KotoriProject/CherryDAP/projects/HSLink-Pro/hardware/README.md

# HSLinkPro

## 本仓库不再更新！！

新的参考设计: <https://github.com/cherry-embedded/CherryDAP/tree/master/projects/HSLink-Pro/hardware>

HSLink Pro是一款基于HPM5301系列MCU的调试器。最高SWD/JTAG通信速率可达80M，并且拥有一路USB转串口，并带有DTR与RTS的输出，方便某些串口下载的MCU应用。

HSLink Pro软件参考<https://github.com/cherry-embedded/CherryDAP>。

## KiCAD 版本

使用8.0以上版本的KiCAD打开。
