KotoriProject/CherryDAP/docs/src/projects/README.md

---
title: 示例工程
---

以下是 CherryDAP 提供的一系列 MCU 的示例工程，可作为参考。

<Catalog />
