KotoriProject/CherryDAP/docs/src/projects/image/53uart.png

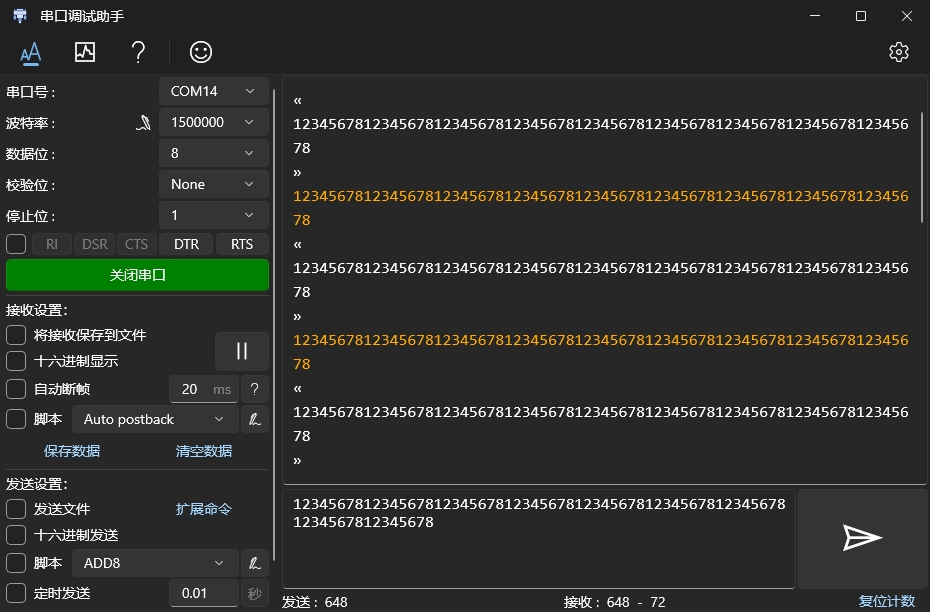
docs/src/projects/image/53uart.png
