KotoriProject/CherryDAP/docs/src/projects/image/2024-09-16-17-08-40.png

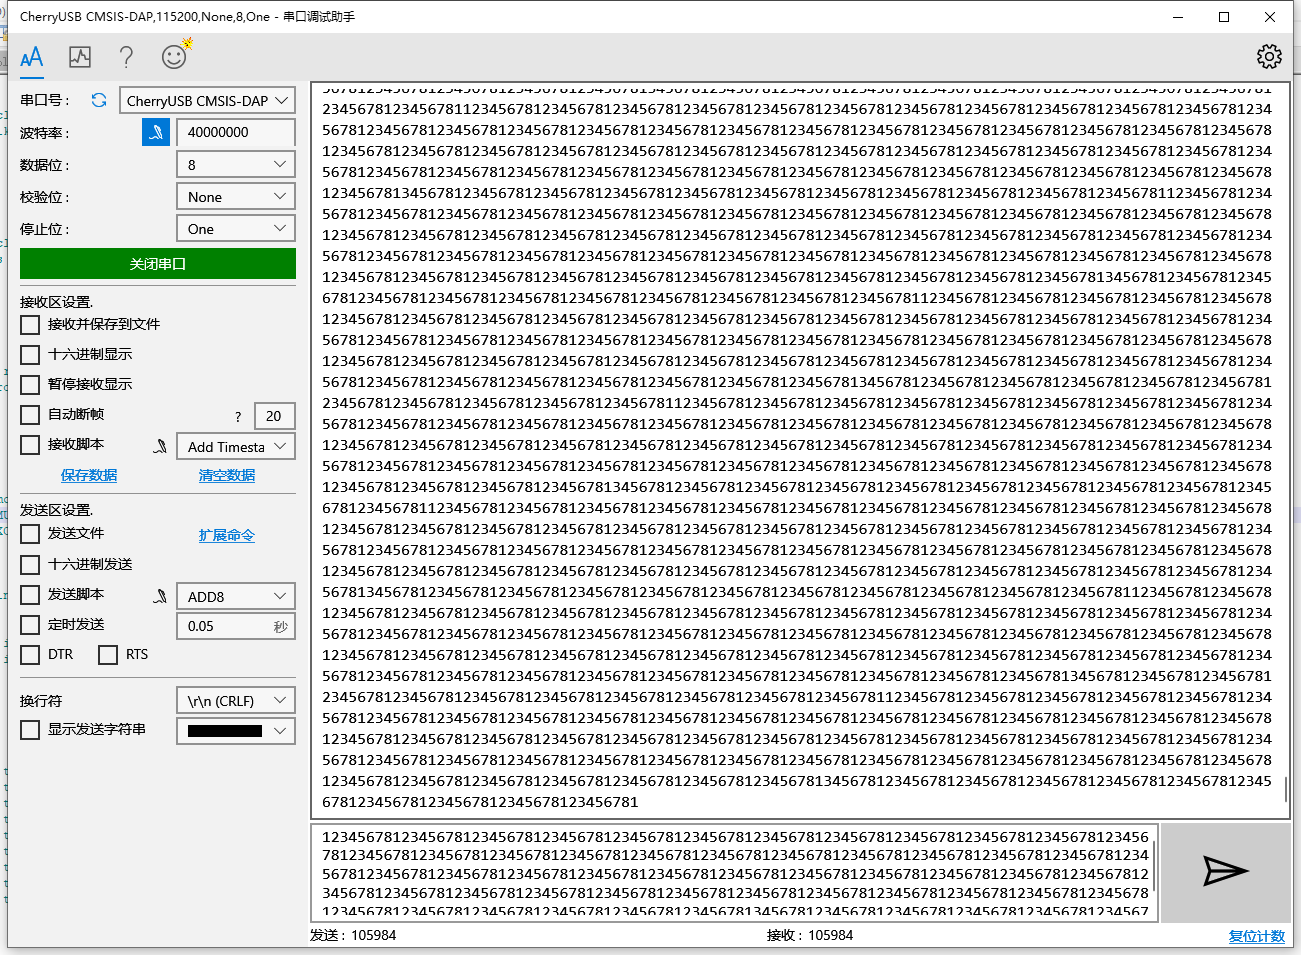
docs/src/projects/image/2024-09-16-17-08-40.png
