KotoriProject/CherryDAP/docs/src/projects/image/2024-09-16-17-09-58.png

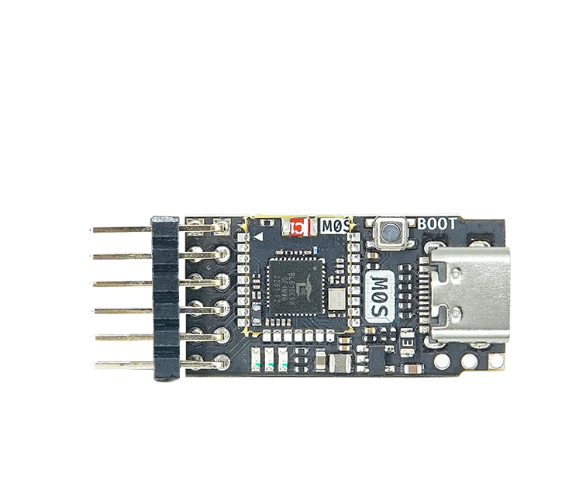
docs/src/projects/image/2024-09-16-17-09-58.png
