KotoriProject/CherryDAP/docs/src/projects/image/2024-09-16-17-15-38.png

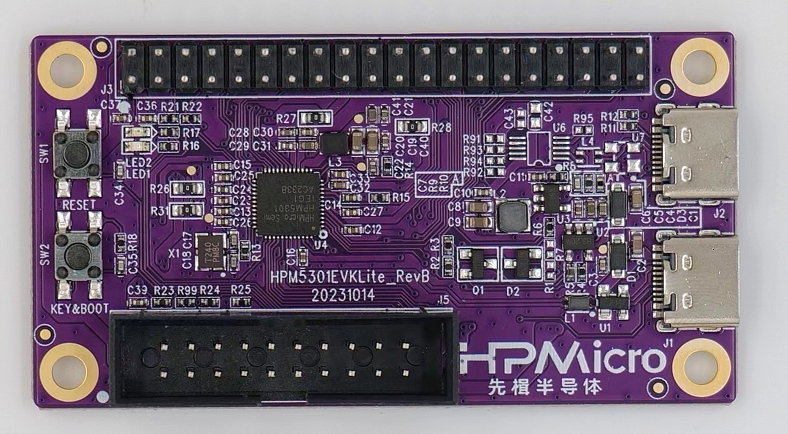
docs/src/projects/image/2024-09-16-17-15-38.png
