KotoriProject/CherryDAP/docs/src/projects/image/hpm_acc_tools.png

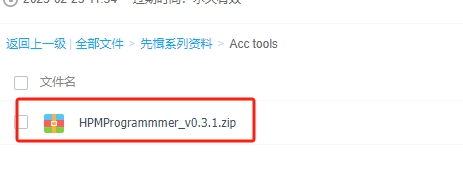
docs/src/projects/image/hpm_acc_tools.png
