KotoriProject/CherryDAP/docs/src/projects/image/hpm_download.png

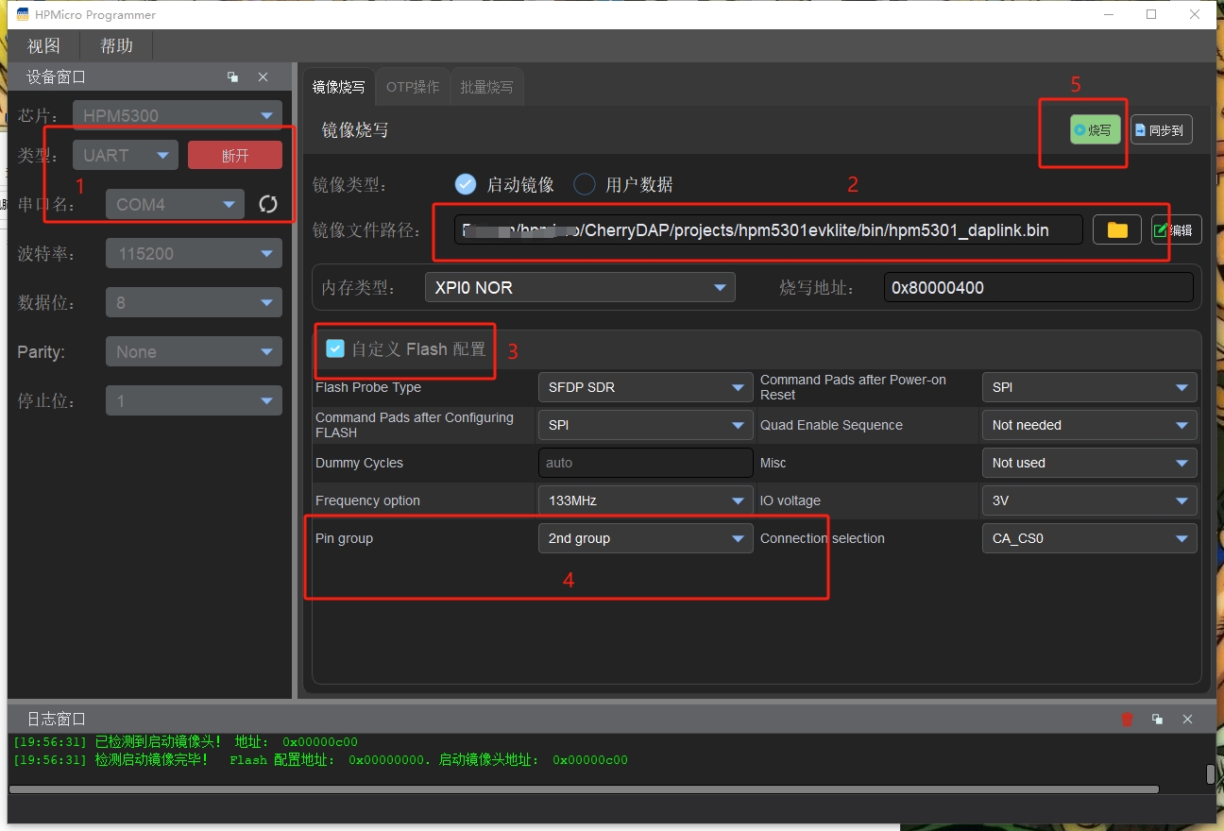
docs/src/projects/image/hpm_download.png
