KotoriProject/CherryDAP/docs/src/projects/image/hpm_isp_uart.png

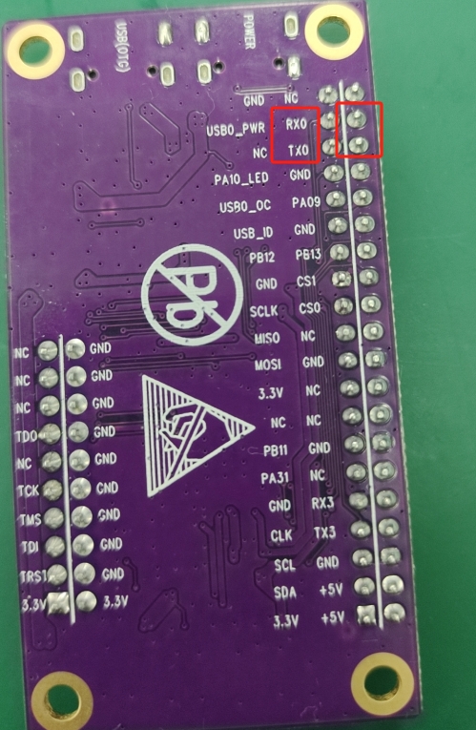
docs/src/projects/image/hpm_isp_uart.png
