KotoriProject/CherryDAP/docs/src/projects/image/sdk_env.png

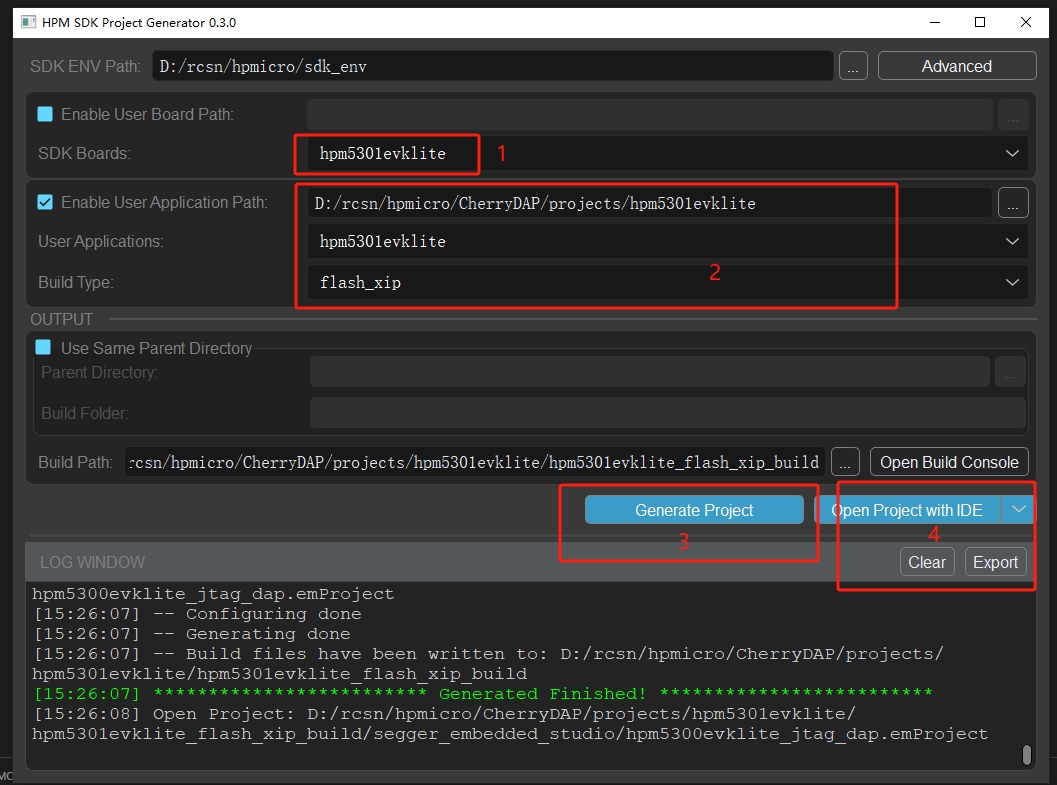
docs/src/projects/image/sdk_env.png
