KotoriProject/CherryDAP/docs/src/projects/image/ses_debug_hpm.png

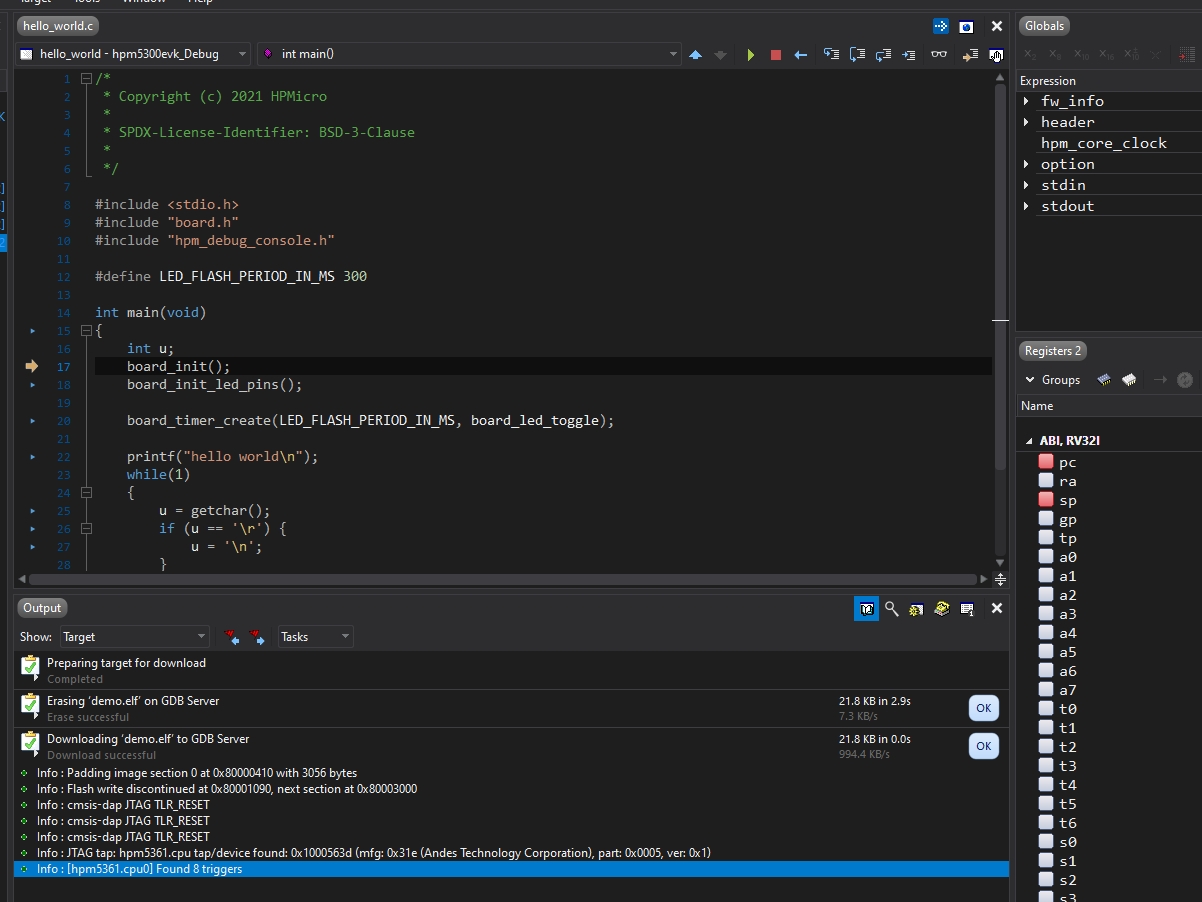
docs/src/projects/image/ses_debug_hpm.png
