KotoriProject/CherryDAP/docs/pnpm-lock.yaml

lockfileVersion: '6.0'

settings:
  autoInstallPeers: true
  excludeLinksFromLockfile: false

dependencies:
  '@vuepress/plugin-markdown-image':
    specifier: 2.0.0-rc.47
    version: 2.0.0-rc.47(markdown-it@14.1.0)(vuepress@2.0.0-rc.15)
  '@vuepress/plugin-markdown-tab':
    specifier: 2.0.0-rc.47
    version: 2.0.0-rc.47(markdown-it@14.1.0)(vuepress@2.0.0-rc.15)
  '@vuepress/plugin-redirect':
    specifier: 2.0.0-rc.51
    version: 2.0.0-rc.51(vuepress@2.0.0-rc.15)
  sass-embedded:
    specifier: ^1.79.3
    version: 1.79.3

devDependencies:
  '@vuepress/bundler-vite':
    specifier: 2.0.0-rc.15
    version: 2.0.0-rc.15(sass-embedded@1.79.3)
  vue:
    specifier: ^3.5.8
    version: 3.5.8
  vuepress:
    specifier: 2.0.0-rc.15
    version: 2.0.0-rc.15(@vuepress/bundler-vite@2.0.0-rc.15)(vue@3.5.8)
  vuepress-theme-hope:
    specifier: 2.0.0-rc.56
    version: 2.0.0-rc.56(@vuepress/plugin-redirect@2.0.0-rc.51)(markdown-it@14.1.0)(sass-embedded@1.79.3)(vuepress@2.0.0-rc.15)

packages:

  /@babel/helper-string-parser@7.24.8:
    resolution: {integrity: sha512-pO9KhhRcuUyGnJWwyEgnRJTSIZHiT+vMD0kPeD+so0l7mxkMT19g3pjY9GTnHySck/hDzq+dtW/4VgnMkippsQ==}
    engines: {node: '>=6.9.0'}

  /@babel/helper-validator-identifier@7.24.7:
    resolution: {integrity: sha512-rR+PBcQ1SMQDDyF6X0wxtG8QyLCgUB0eRAGguqRLfkCA87l7yAP7ehq8SNj96OOGTO8OBV70KhuFYcIkHXOg0w==}
    engines: {node: '>=6.9.0'}

  /@babel/parser@7.25.6:
    resolution: {integrity: sha512-trGdfBdbD0l1ZPmcJ83eNxB9rbEax4ALFTF7fN386TMYbeCQbyme5cOEXQhbGXKebwGaB/J52w1mrklMcbgy6Q==}
    engines: {node: '>=6.0.0'}
    hasBin: true
    dependencies:
      '@babel/types': 7.25.6

  /@babel/types@7.25.6:
    resolution: {integrity: sha512-/l42B1qxpG6RdfYf343Uw1vmDjeNhneUXtzhojE7pDgfpEypmRhI6j1kr17XCVv4Cgl9HdAiQY2x0GwKm7rWCw==}
    engines: {node: '>=6.9.0'}
    dependencies:
      '@babel/helper-string-parser': 7.24.8
      '@babel/helper-validator-identifier': 7.24.7
      to-fast-properties: 2.0.0

  /@bufbuild/protobuf@2.1.0:
    resolution: {integrity: sha512-+2Mx67Y3skJ4NCD/qNSdBJNWtu6x6Qr53jeNg+QcwiL6mt0wK+3jwHH2x1p7xaYH6Ve2JKOVn0OxU35WsmqI9A==}

  /@esbuild/aix-ppc64@0.21.5:
    resolution: {integrity: sha512-1SDgH6ZSPTlggy1yI6+Dbkiz8xzpHJEVAlF/AM1tHPLsf5STom9rwtjE4hKAF20FfXXNTFqEYXyJNWh1GiZedQ==}
    engines: {node: '>=12'}
    cpu: [ppc64]
    os: [aix]
    requiresBuild: true
    optional: true

  /@esbuild/android-arm64@0.21.5:
    resolution: {integrity: sha512-c0uX9VAUBQ7dTDCjq+wdyGLowMdtR/GoC2U5IYk/7D1H1JYC0qseD7+11iMP2mRLN9RcCMRcjC4YMclCzGwS/A==}
    engines: {node: '>=12'}
    cpu: [arm64]
    os: [android]
    requiresBuild: true
    optional: true

  /@esbuild/android-arm@0.21.5:
    resolution: {integrity: sha512-vCPvzSjpPHEi1siZdlvAlsPxXl7WbOVUBBAowWug4rJHb68Ox8KualB+1ocNvT5fjv6wpkX6o/iEpbDrf68zcg==}
    engines: {node: '>=12'}
    cpu: [arm]
    os: [android]
    requiresBuild: true
    optional: true

  /@esbuild/android-x64@0.21.5:
    resolution: {integrity: sha512-D7aPRUUNHRBwHxzxRvp856rjUHRFW1SdQATKXH2hqA0kAZb1hKmi02OpYRacl0TxIGz/ZmXWlbZgjwWYaCakTA==}
    engines: {node: '>=12'}
    cpu: [x64]
    os: [android]
    requiresBuild: true
    optional: true

  /@esbuild/darwin-arm64@0.21.5:
    resolution: {integrity: sha512-DwqXqZyuk5AiWWf3UfLiRDJ5EDd49zg6O9wclZ7kUMv2WRFr4HKjXp/5t8JZ11QbQfUS6/cRCKGwYhtNAY88kQ==}
    engines: {node: '>=12'}
    cpu: [arm64]
    os: [darwin]
    requiresBuild: true
    optional: true

  /@esbuild/darwin-x64@0.21.5:
    resolution: {integrity: sha512-se/JjF8NlmKVG4kNIuyWMV/22ZaerB+qaSi5MdrXtd6R08kvs2qCN4C09miupktDitvh8jRFflwGFBQcxZRjbw==}
    engines: {node: '>=12'}
    cpu: [x64]
    os: [darwin]
    requiresBuild: true
    optional: true

  /@esbuild/freebsd-arm64@0.21.5:
    resolution: {integrity: sha512-5JcRxxRDUJLX8JXp/wcBCy3pENnCgBR9bN6JsY4OmhfUtIHe3ZW0mawA7+RDAcMLrMIZaf03NlQiX9DGyB8h4g==}
    engines: {node: '>=12'}
    cpu: [arm64]
    os: [freebsd]
    requiresBuild: true
    optional: true

  /@esbuild/freebsd-x64@0.21.5:
    resolution: {integrity: sha512-J95kNBj1zkbMXtHVH29bBriQygMXqoVQOQYA+ISs0/2l3T9/kj42ow2mpqerRBxDJnmkUDCaQT/dfNXWX/ZZCQ==}
    engines: {node: '>=12'}
    cpu: [x64]
    os: [freebsd]
    requiresBuild: true
    optional: true

  /@esbuild/linux-arm64@0.21.5:
    resolution: {integrity: sha512-ibKvmyYzKsBeX8d8I7MH/TMfWDXBF3db4qM6sy+7re0YXya+K1cem3on9XgdT2EQGMu4hQyZhan7TeQ8XkGp4Q==}
    engines: {node: '>=12'}
    cpu: [arm64]
    os: [linux]
    requiresBuild: true
    optional: true

  /@esbuild/linux-arm@0.21.5:
    resolution: {integrity: sha512-bPb5AHZtbeNGjCKVZ9UGqGwo8EUu4cLq68E95A53KlxAPRmUyYv2D6F0uUI65XisGOL1hBP5mTronbgo+0bFcA==}
    engines: {node: '>=12'}
    cpu: [arm]
    os: [linux]
    requiresBuild: true
    optional: true

  /@esbuild/linux-ia32@0.21.5:
    resolution: {integrity: sha512-YvjXDqLRqPDl2dvRODYmmhz4rPeVKYvppfGYKSNGdyZkA01046pLWyRKKI3ax8fbJoK5QbxblURkwK/MWY18Tg==}
    engines: {node: '>=12'}
    cpu: [ia32]
    os: [linux]
    requiresBuild: true
    optional: true

  /@esbuild/linux-loong64@0.21.5:
    resolution: {integrity: sha512-uHf1BmMG8qEvzdrzAqg2SIG/02+4/DHB6a9Kbya0XDvwDEKCoC8ZRWI5JJvNdUjtciBGFQ5PuBlpEOXQj+JQSg==}
    engines: {node: '>=12'}
    cpu: [loong64]
    os: [linux]
    requiresBuild: true
    optional: true

  /@esbuild/linux-mips64el@0.21.5:
    resolution: {integrity: sha512-IajOmO+KJK23bj52dFSNCMsz1QP1DqM6cwLUv3W1QwyxkyIWecfafnI555fvSGqEKwjMXVLokcV5ygHW5b3Jbg==}
    engines: {node: '>=12'}
    cpu: [mips64el]
    os: [linux]
    requiresBuild: true
    optional: true

  /@esbuild/linux-ppc64@0.21.5:
    resolution: {integrity: sha512-1hHV/Z4OEfMwpLO8rp7CvlhBDnjsC3CttJXIhBi+5Aj5r+MBvy4egg7wCbe//hSsT+RvDAG7s81tAvpL2XAE4w==}
    engines: {node: '>=12'}
    cpu: [ppc64]
    os: [linux]
    requiresBuild: true
    optional: true

  /@esbuild/linux-riscv64@0.21.5:
    resolution: {integrity: sha512-2HdXDMd9GMgTGrPWnJzP2ALSokE/0O5HhTUvWIbD3YdjME8JwvSCnNGBnTThKGEB91OZhzrJ4qIIxk/SBmyDDA==}
    engines: {node: '>=12'}
    cpu: [riscv64]
    os: [linux]
    requiresBuild: true
    optional: true

  /@esbuild/linux-s390x@0.21.5:
    resolution: {integrity: sha512-zus5sxzqBJD3eXxwvjN1yQkRepANgxE9lgOW2qLnmr8ikMTphkjgXu1HR01K4FJg8h1kEEDAqDcZQtbrRnB41A==}
    engines: {node: '>=12'}
    cpu: [s390x]
    os: [linux]
    requiresBuild: true
    optional: true

  /@esbuild/linux-x64@0.21.5:
    resolution: {integrity: sha512-1rYdTpyv03iycF1+BhzrzQJCdOuAOtaqHTWJZCWvijKD2N5Xu0TtVC8/+1faWqcP9iBCWOmjmhoH94dH82BxPQ==}
    engines: {node: '>=12'}
    cpu: [x64]
    os: [linux]
    requiresBuild: true
    optional: true

  /@esbuild/netbsd-x64@0.21.5:
    resolution: {integrity: sha512-Woi2MXzXjMULccIwMnLciyZH4nCIMpWQAs049KEeMvOcNADVxo0UBIQPfSmxB3CWKedngg7sWZdLvLczpe0tLg==}
    engines: {node: '>=12'}
    cpu: [x64]
    os: [netbsd]
    requiresBuild: true
    optional: true

  /@esbuild/openbsd-x64@0.21.5:
    resolution: {integrity: sha512-HLNNw99xsvx12lFBUwoT8EVCsSvRNDVxNpjZ7bPn947b8gJPzeHWyNVhFsaerc0n3TsbOINvRP2byTZ5LKezow==}
    engines: {node: '>=12'}
    cpu: [x64]
    os: [openbsd]
    requiresBuild: true
    optional: true

  /@esbuild/sunos-x64@0.21.5:
    resolution: {integrity: sha512-6+gjmFpfy0BHU5Tpptkuh8+uw3mnrvgs+dSPQXQOv3ekbordwnzTVEb4qnIvQcYXq6gzkyTnoZ9dZG+D4garKg==}
    engines: {node: '>=12'}
    cpu: [x64]
    os: [sunos]
    requiresBuild: true
    optional: true

  /@esbuild/win32-arm64@0.21.5:
    resolution: {integrity: sha512-Z0gOTd75VvXqyq7nsl93zwahcTROgqvuAcYDUr+vOv8uHhNSKROyU961kgtCD1e95IqPKSQKH7tBTslnS3tA8A==}
    engines: {node: '>=12'}
    cpu: [arm64]
    os: [win32]
    requiresBuild: true
    optional: true

  /@esbuild/win32-ia32@0.21.5:
    resolution: {integrity: sha512-SWXFF1CL2RVNMaVs+BBClwtfZSvDgtL//G/smwAc5oVK/UPu2Gu9tIaRgFmYFFKrmg3SyAjSrElf0TiJ1v8fYA==}
    engines: {node: '>=12'}
    cpu: [ia32]
    os: [win32]
    requiresBuild: true
    optional: true

  /@esbuild/win32-x64@0.21.5:
    resolution: {integrity: sha512-tQd/1efJuzPC6rCFwEvLtci/xNFcTZknmXs98FYDfGE4wP9ClFV98nyKrzJKVPMhdDnjzLhdUyMX4PsQAPjwIw==}
    engines: {node: '>=12'}
    cpu: [x64]
    os: [win32]
    requiresBuild: true
    optional: true

  /@jridgewell/sourcemap-codec@1.5.0:
    resolution: {integrity: sha512-gv3ZRaISU3fjPAgNsriBRqGWQL6quFx04YMPW/zD8XMLsU32mhCCbfbO6KZFLjvYpCZ8zyDEgqsgf+PwPaM7GQ==}

  /@lit-labs/ssr-dom-shim@1.2.1:
    resolution: {integrity: sha512-wx4aBmgeGvFmOKucFKY+8VFJSYZxs9poN3SDNQFF6lT6NrQUnHiPB2PWz2sc4ieEcAaYYzN+1uWahEeTq2aRIQ==}
    dev: true

  /@lit/reactive-element@2.0.4:
    resolution: {integrity: sha512-GFn91inaUa2oHLak8awSIigYz0cU0Payr1rcFsrkf5OJ5eSPxElyZfKh0f2p9FsTiZWXQdWGJeXZICEfXXYSXQ==}
    dependencies:
      '@lit-labs/ssr-dom-shim': 1.2.1
    dev: true

  /@mdit-vue/plugin-component@2.1.3:
    resolution: {integrity: sha512-9AG17beCgpEw/4ldo/M6Y/1Rh4E1bqMmr/rCkWKmCAxy9tJz3lzY7HQJanyHMJufwsb3WL5Lp7Om/aPcQTZ9SA==}
    dependencies:
      '@types/markdown-it': 14.1.2
      markdown-it: 14.1.0

  /@mdit-vue/plugin-frontmatter@2.1.3:
    resolution: {integrity: sha512-KxsSCUVBEmn6sJcchSTiI5v9bWaoRxe68RBYRDGcSEY1GTnfQ5gQPMIsM48P4q1luLEIWurVGGrRu7u93//LDQ==}
    dependencies:
      '@mdit-vue/types': 2.1.0
      '@types/markdown-it': 14.1.2
      gray-matter: 4.0.3
      markdown-it: 14.1.0

  /@mdit-vue/plugin-headers@2.1.3:
    resolution: {integrity: sha512-AcL7a7LHQR3ISINhfjGJNE/bHyM0dcl6MYm1Sr//zF7ZgokPGwD/HhD7TzwmrKA9YNYCcO9P3QmF/RN9XyA6CA==}
    dependencies:
      '@mdit-vue/shared': 2.1.3
      '@mdit-vue/types': 2.1.0
      '@types/markdown-it': 14.1.2
      markdown-it: 14.1.0

  /@mdit-vue/plugin-sfc@2.1.3:
    resolution: {integrity: sha512-Ezl0dNvQNS639Yl4siXm+cnWtQvlqHrg+u+lnau/OHpj9Xh3LVap/BSQVugKIV37eR13jXXYf3VaAOP1fXPN+w==}
    dependencies:
      '@mdit-vue/types': 2.1.0
      '@types/markdown-it': 14.1.2
      markdown-it: 14.1.0

  /@mdit-vue/plugin-title@2.1.3:
    resolution: {integrity: sha512-XWVOQoZqczoN97xCDrnQicmXKoqwOjIymIm9HQnRXhHnYKOgJPW1CxSGhkcOGzvDU1v0mD/adojVyyj/s6ggWw==}
    dependencies:
      '@mdit-vue/shared': 2.1.3
      '@mdit-vue/types': 2.1.0
      '@types/markdown-it': 14.1.2
      markdown-it: 14.1.0

  /@mdit-vue/plugin-toc@2.1.3:
    resolution: {integrity: sha512-41Q+iXpLHZt0zJdApVwoVt7WF6za/xUjtjEPf90Z3KLzQO01TXsv48Xp9BsrFHPcPcm8tiZ0+O1/ICJO80V/MQ==}
    dependencies:
      '@mdit-vue/shared': 2.1.3
      '@mdit-vue/types': 2.1.0
      '@types/markdown-it': 14.1.2
      markdown-it: 14.1.0

  /@mdit-vue/shared@2.1.3:
    resolution: {integrity: sha512-27YI8b0VVZsAlNwaWoaOCWbr4eL8B04HxiYk/y2ktblO/nMcOEOLt4p0RjuobvdyUyjHvGOS09RKhq7qHm1CHQ==}
    dependencies:
      '@mdit-vue/types': 2.1.0
      '@types/markdown-it': 14.1.2
      markdown-it: 14.1.0

  /@mdit-vue/types@2.1.0:
    resolution: {integrity: sha512-TMBB/BQWVvwtpBdWD75rkZx4ZphQ6MN0O4QB2Bc0oI5PC2uE57QerhNxdRZ7cvBHE2iY2C+BUNUziCfJbjIRRA==}

  /@mdit/plugin-alert@0.13.1(markdown-it@14.1.0):
    resolution: {integrity: sha512-3LMYQQ3QP6TUx6zmtmuoHJScST5SVoPZlNuuF4S6PUZvJIwtlITF+eFNjDrA7UQx0PUdCgVHmwu5kYliq+BNtg==}
    peerDependencies:
      markdown-it: ^14.1.0
    peerDependenciesMeta:
      markdown-it:
        optional: true
    dependencies:
      '@types/markdown-it': 14.1.2
      markdown-it: 14.1.0
    dev: true

  /@mdit/plugin-align@0.13.1(markdown-it@14.1.0):
    resolution: {integrity: sha512-g8je53oEpYNHEudhtB5ViSiAaiMcca+hvoGbInhLl979tWuvEosOs0oWH2X3GM4f6goTGx8gLwzA10Z5C4FxIQ==}
    engines: {node: '>= 18'}
    peerDependencies:
      markdown-it: ^14.1.0
    peerDependenciesMeta:
      markdown-it:
        optional: true
    dependencies:
      '@mdit/plugin-container': 0.13.1(markdown-it@14.1.0)
      '@types/markdown-it': 14.1.2
      markdown-it: 14.1.0
    dev: true

  /@mdit/plugin-attrs@0.13.1(markdown-it@14.1.0):
    resolution: {integrity: sha512-3saBw5W2y3T0QNbui+uk7nfD36FOoBWNQImk+pbMGpKRqunjouiYP4ZtnttT/AiieGbZBVaOqhM4e01Uyua8VA==}
    engines: {node: '>= 18'}
    peerDependencies:
      markdown-it: ^14.1.0
    peerDependenciesMeta:
      markdown-it:
        optional: true
    dependencies:
      '@types/markdown-it': 14.1.2
      markdown-it: 14.1.0
    dev: true

  /@mdit/plugin-container@0.13.1(markdown-it@14.1.0):
    resolution: {integrity: sha512-mFfm7YViyLHo8uORVa9oLi9+acZZoSVdPf3WPqzC/yLZAJbF27rfJgWZ9Kylt+tyaAYng8L4DiSeVcSNUIHF1A==}
    engines: {node: '>= 18'}
    peerDependencies:
      markdown-it: ^14.1.0
    peerDependenciesMeta:
      markdown-it:
        optional: true
    dependencies:
      '@types/markdown-it': 14.1.2
      markdown-it: 14.1.0
    dev: true

  /@mdit/plugin-demo@0.13.1(markdown-it@14.1.0):
    resolution: {integrity: sha512-ne36FB7jstUblatow7ed1Z3Nm0zootM7A6b+77xEw7aJnXHkM5tJLbBfS6l8WN1Ze7fWVZbP7xQkI3wRvjqrqg==}
    peerDependencies:
      markdown-it: ^14.1.0
    peerDependenciesMeta:
      markdown-it:
        optional: true
    dependencies:
      '@types/markdown-it': 14.1.2
      markdown-it: 14.1.0
    dev: true

  /@mdit/plugin-figure@0.13.1(markdown-it@14.1.0):
    resolution: {integrity: sha512-bxeUVMPAuXHYRqPzU+1ux7R3LkpyHTdavCa05rQUhzDI07N+BZDE7oOABXnnFbx6ESamzu3/FBtq9VKjoifLmw==}
    engines: {node: '>= 18'}
    peerDependencies:
      markdown-it: ^14.1.0
    peerDependenciesMeta:
      markdown-it:
        optional: true
    dependencies:
      '@types/markdown-it': 14.1.2
      markdown-it: 14.1.0

  /@mdit/plugin-footnote@0.13.1(markdown-it@14.1.0):
    resolution: {integrity: sha512-46TzNvY9QXO5y6MbXlewCe+gfw3lgF2IFQCs0enaWVSgKNaGxOuecDR68SlbLPc7unJQCcs5Bb/XB4xsx0depQ==}
    engines: {node: '>= 18'}
    peerDependencies:
      markdown-it: ^14.1.0
    dependencies:
      '@types/markdown-it': 14.1.2
      markdown-it: 14.1.0
    dev: true

  /@mdit/plugin-img-lazyload@0.13.1(markdown-it@14.1.0):
    resolution: {integrity: sha512-DPzR+yabbgqHWHb8oetOj56TtZzOcn5YZjSTssoh7lY5hp/Yy7jWvlLDrSw/LiXkYEhyocUee78enhTodBEpHQ==}
    engines: {node: '>= 18'}
    peerDependencies:
      markdown-it: ^14.1.0
    peerDependenciesMeta:
      markdown-it:
        optional: true
    dependencies:
      '@types/markdown-it': 14.1.2
      markdown-it: 14.1.0

  /@mdit/plugin-img-mark@0.13.1(markdown-it@14.1.0):
    resolution: {integrity: sha512-HOALB1nILV5vkopSKPrclkwwc5WGbpuAWxuOLTz/teOifE8E4JsbiFivcM6URMP1lZXzRBXoniQCCOUhWRis8A==}
    engines: {node: '>= 18'}
    peerDependencies:
      markdown-it: ^14.1.0
    peerDependenciesMeta:
      markdown-it:
        optional: true
    dependencies:
      '@types/markdown-it': 14.1.2
      markdown-it: 14.1.0

  /@mdit/plugin-img-size@0.13.1(markdown-it@14.1.0):
    resolution: {integrity: sha512-cgihl72BNzij7GXjrqcKhl2eOqAlqWHiImOgblJPghDFNFKnnynty/Bf9nwbj8hTnhVWznFeuwawzXBfKYNbkg==}
    engines: {node: '>= 18'}
    peerDependencies:
      markdown-it: ^14.1.0
    peerDependenciesMeta:
      markdown-it:
        optional: true
    dependencies:
      '@types/markdown-it': 14.1.2
      markdown-it: 14.1.0

  /@mdit/plugin-include@0.13.1(markdown-it@14.1.0):
    resolution: {integrity: sha512-rWGJ3/L2Ocv+8KDNoXPb6H1f+aLqx0FzJKcNqJl+0HOAEScuyKS1GC4OxeWefVMQ87QoG/mYqoCbpDsJeiDbLQ==}
    peerDependencies:
      markdown-it: ^14.1.0
    peerDependenciesMeta:
      markdown-it:
        optional: true
    dependencies:
      '@types/markdown-it': 14.1.2
      markdown-it: 14.1.0
      upath: 2.0.1
    dev: true

  /@mdit/plugin-katex-slim@0.13.1(markdown-it@14.1.0):
    resolution: {integrity: sha512-OO4n51aLo0Igv0aICXOaTO5+ZW/jW8Lnl8u1kxs2zkFVNUqpqNHAo8l4QxtscQk5L4XhXGgaTj2ZgAv7rtH96Q==}
    engines: {node: '>= 18'}
    peerDependencies:
      katex: ^0.16.9
      markdown-it: ^14.1.0
    peerDependenciesMeta:
      katex:
        optional: true
      markdown-it:
        optional: true
    dependencies:
      '@mdit/plugin-tex': 0.13.1(markdown-it@14.1.0)
      '@types/katex': 0.16.7
      '@types/markdown-it': 14.1.2
      markdown-it: 14.1.0
    dev: true

  /@mdit/plugin-mark@0.13.1(markdown-it@14.1.0):
    resolution: {integrity: sha512-UV+7cSY8iQXlfnrIJ/gEpgwiL2SSVzVLtaWMOV0J4tRSsdtN8ZXnJn/gC547SxBaOLIkt+0ObSskXaCH/UzuIA==}
    engines: {node: '>= 18'}
    peerDependencies:
      markdown-it: ^14.1.0
    peerDependenciesMeta:
      markdown-it:
        optional: true
    dependencies:
      '@types/markdown-it': 14.1.2
      markdown-it: 14.1.0
    dev: true

  /@mdit/plugin-mathjax-slim@0.13.1(markdown-it@14.1.0):
    resolution: {integrity: sha512-ZFtKG2BtLAk1BarJZei9HP4aK0vNU7YvDb+R+nApK7MRmLQ53xHe7upu3qlfNBoOZWHXsdRmcz0G4xL3oxzlqA==}
    engines: {node: '>= 18'}
    peerDependencies:
      markdown-it: ^14.1.0
      mathjax-full: ^3.2.2
    peerDependenciesMeta:
      markdown-it:
        optional: true
      mathjax-full:
        optional: true
    dependencies:
      '@mdit/plugin-tex': 0.13.1(markdown-it@14.1.0)
      '@types/markdown-it': 14.1.2
      markdown-it: 14.1.0
      upath: 2.0.1
    dev: true

  /@mdit/plugin-plantuml@0.13.1(markdown-it@14.1.0):
    resolution: {integrity: sha512-qupMO/lG1mDYaGHSutB9AO1TsxHjmp4yFnvp3VBNNRdVh9lqWhXFv/htrnr0IGEWAmlik6zlkCvz/YrKRONV5A==}
    peerDependencies:
      markdown-it: ^14.1.0
    peerDependenciesMeta:
      markdown-it:
        optional: true
    dependencies:
      '@mdit/plugin-uml': 0.13.1(markdown-it@14.1.0)
      '@types/markdown-it': 14.1.2
      markdown-it: 14.1.0
    dev: true

  /@mdit/plugin-spoiler@0.13.1(markdown-it@14.1.0):
    resolution: {integrity: sha512-6aOD+kjGavkn+Ta0Iq8AUfBG3UsKsL5e0pxi0Eng13lIEp8DrDw36W+E6fLOFtX8Te3ays6eTkTc1I5WzHO0Gw==}
    engines: {node: '>= 18'}
    peerDependencies:
      markdown-it: ^14.1.0
    peerDependenciesMeta:
      markdown-it:
        optional: true
    dependencies:
      '@types/markdown-it': 14.1.2
      markdown-it: 14.1.0
    dev: true

  /@mdit/plugin-stylize@0.13.1(markdown-it@14.1.0):
    resolution: {integrity: sha512-1v+3H1nMMvXsbu6iyV1pQ7WccrRNkuHovkIAp04Vj0FtbjnKrBHlmzFZace5OaD2RcZ0fn6qRpyR+/AIMjUvtQ==}
    engines: {node: '>= 18'}
    peerDependencies:
      markdown-it: ^14.1.0
    peerDependenciesMeta:
      markdown-it:
        optional: true
    dependencies:
      '@types/markdown-it': 14.1.2
      markdown-it: 14.1.0
    dev: true

  /@mdit/plugin-sub@0.13.1(markdown-it@14.1.0):
    resolution: {integrity: sha512-2rIvEl6pXUoXIm3JMO5ZOQ+vWIeFXmLkqxcmTZB2yOIfhYdLwIcSyquRwtI2AX8zCuvaTdiQ/aypvIE4tDoURw==}
    engines: {node: '>= 18'}
    peerDependencies:
      markdown-it: ^14.1.0
    peerDependenciesMeta:
      markdown-it:
        optional: true
    dependencies:
      '@types/markdown-it': 14.1.2
      markdown-it: 14.1.0
    dev: true

  /@mdit/plugin-sup@0.13.1(markdown-it@14.1.0):
    resolution: {integrity: sha512-vkNif2Rbj7/gtk4/HJt5hnb+Dcbnek/V4HtLdtqUUnq9bIbzFBpYw5jZ1ZKKZeetDtRvOUPH5oy5d7iXAHorUg==}
    engines: {node: '>= 18'}
    peerDependencies:
      markdown-it: ^14.1.0
    peerDependenciesMeta:
      markdown-it:
        optional: true
    dependencies:
      '@types/markdown-it': 14.1.2
      markdown-it: 14.1.0
    dev: true

  /@mdit/plugin-tab@0.13.1(markdown-it@14.1.0):
    resolution: {integrity: sha512-485YgrkrSkY7t/kgCPnCMlk5gWkXiosdZs9aq4rRDytyvRVa8NQs+4cqMUtxAdYzwnZgsvju+/wmcXfUYAG/EA==}
    peerDependencies:
      markdown-it: ^14.1.0
    peerDependenciesMeta:
      markdown-it:
        optional: true
    dependencies:
      '@types/markdown-it': 14.1.2
      markdown-it: 14.1.0

  /@mdit/plugin-tasklist@0.13.1(markdown-it@14.1.0):
    resolution: {integrity: sha512-flEWnDJFEB7QZIHRwtkVjAEZe9ONiRQLRg7oazRDBM/3Z0rf28blxOx7qj2QZ/FVzQnRRZTgjFQkpiz61IckKQ==}
    engines: {node: '>= 18'}
    peerDependencies:
      markdown-it: ^14.1.0
    peerDependenciesMeta:
      markdown-it:
        optional: true
    dependencies:
      '@types/markdown-it': 14.1.2
      markdown-it: 14.1.0
    dev: true

  /@mdit/plugin-tex@0.13.1(markdown-it@14.1.0):
    resolution: {integrity: sha512-lkRf6XrfVfS11FzT3hiooWdOUPJfAd/cnAv4NN/4WU7qOEz0e0HBVQO8PQb5CPwrE94Ld4+E6rQwJfVH1grkwQ==}
    engines: {node: '>= 18'}
    peerDependencies:
      markdown-it: ^14.1.0
    peerDependenciesMeta:
      markdown-it:
        optional: true
    dependencies:
      '@types/markdown-it': 14.1.2
      markdown-it: 14.1.0
    dev: true

  /@mdit/plugin-uml@0.13.1(markdown-it@14.1.0):
    resolution: {integrity: sha512-JdCOg25OyG+QJFAba6AWwdpkaOjuht5VmOqYt4/h/AzLsIHh/2j+TnCZBn0XQm3D8yJ9Y4w4oouS4wpPduRW0A==}
    engines: {node: '>= 18'}
    peerDependencies:
      markdown-it: ^14.1.0
    peerDependenciesMeta:
      markdown-it:
        optional: true
    dependencies:
      '@types/markdown-it': 14.1.2
      markdown-it: 14.1.0
    dev: true

  /@nodelib/fs.scandir@2.1.5:
    resolution: {integrity: sha512-vq24Bq3ym5HEQm2NKCr3yXDwjc7vTsEThRDnkp2DK9p1uqLR+DHurm/NOTo0KG7HYHU7eppKZj3MyqYuMBf62g==}
    engines: {node: '>= 8'}
    dependencies:
      '@nodelib/fs.stat': 2.0.5
      run-parallel: 1.2.0

  /@nodelib/fs.stat@2.0.5:
    resolution: {integrity: sha512-RkhPPp2zrqDAQA/2jNhnztcPAlv64XdhIp7a7454A5ovI7Bukxgt7MX7udwAu3zg1DcpPU0rz3VV1SeaqvY4+A==}
    engines: {node: '>= 8'}

  /@nodelib/fs.walk@1.2.8:
    resolution: {integrity: sha512-oGB+UxlgWcgQkgwo8GcEGwemoTFt3FIO9ababBmaGwXIoBKZ+GTy0pP185beGg7Llih/NSHSV2XAs1lnznocSg==}
    engines: {node: '>= 8'}
    dependencies:
      '@nodelib/fs.scandir': 2.1.5
      fastq: 1.17.1

  /@rollup/rollup-android-arm-eabi@4.22.4:
    resolution: {integrity: sha512-Fxamp4aEZnfPOcGA8KSNEohV8hX7zVHOemC8jVBoBUHu5zpJK/Eu3uJwt6BMgy9fkvzxDaurgj96F/NiLukF2w==}
    cpu: [arm]
    os: [android]
    requiresBuild: true
    optional: true

  /@rollup/rollup-android-arm64@4.22.4:
    resolution: {integrity: sha512-VXoK5UMrgECLYaMuGuVTOx5kcuap1Jm8g/M83RnCHBKOqvPPmROFJGQaZhGccnsFtfXQ3XYa4/jMCJvZnbJBdA==}
    cpu: [arm64]
    os: [android]
    requiresBuild: true
    optional: true

  /@rollup/rollup-darwin-arm64@4.22.4:
    resolution: {integrity: sha512-xMM9ORBqu81jyMKCDP+SZDhnX2QEVQzTcC6G18KlTQEzWK8r/oNZtKuZaCcHhnsa6fEeOBionoyl5JsAbE/36Q==}
    cpu: [arm64]
    os: [darwin]
    requiresBuild: true
    optional: true

  /@rollup/rollup-darwin-x64@4.22.4:
    resolution: {integrity: sha512-aJJyYKQwbHuhTUrjWjxEvGnNNBCnmpHDvrb8JFDbeSH3m2XdHcxDd3jthAzvmoI8w/kSjd2y0udT+4okADsZIw==}
    cpu: [x64]
    os: [darwin]
    requiresBuild: true
    optional: true

  /@rollup/rollup-linux-arm-gnueabihf@4.22.4:
    resolution: {integrity: sha512-j63YtCIRAzbO+gC2L9dWXRh5BFetsv0j0va0Wi9epXDgU/XUi5dJKo4USTttVyK7fGw2nPWK0PbAvyliz50SCQ==}
    cpu: [arm]
    os: [linux]
    requiresBuild: true
    optional: true

  /@rollup/rollup-linux-arm-musleabihf@4.22.4:
    resolution: {integrity: sha512-dJnWUgwWBX1YBRsuKKMOlXCzh2Wu1mlHzv20TpqEsfdZLb3WoJW2kIEsGwLkroYf24IrPAvOT/ZQ2OYMV6vlrg==}
    cpu: [arm]
    os: [linux]
    requiresBuild: true
    optional: true

  /@rollup/rollup-linux-arm64-gnu@4.22.4:
    resolution: {integrity: sha512-AdPRoNi3NKVLolCN/Sp4F4N1d98c4SBnHMKoLuiG6RXgoZ4sllseuGioszumnPGmPM2O7qaAX/IJdeDU8f26Aw==}
    cpu: [arm64]
    os: [linux]
    requiresBuild: true
    optional: true

  /@rollup/rollup-linux-arm64-musl@4.22.4:
    resolution: {integrity: sha512-Gl0AxBtDg8uoAn5CCqQDMqAx22Wx22pjDOjBdmG0VIWX3qUBHzYmOKh8KXHL4UpogfJ14G4wk16EQogF+v8hmA==}
    cpu: [arm64]
    os: [linux]
    requiresBuild: true
    optional: true

  /@rollup/rollup-linux-powerpc64le-gnu@4.22.4:
    resolution: {integrity: sha512-3aVCK9xfWW1oGQpTsYJJPF6bfpWfhbRnhdlyhak2ZiyFLDaayz0EP5j9V1RVLAAxlmWKTDfS9wyRyY3hvhPoOg==}
    cpu: [ppc64]
    os: [linux]
    requiresBuild: true
    optional: true

  /@rollup/rollup-linux-riscv64-gnu@4.22.4:
    resolution: {integrity: sha512-ePYIir6VYnhgv2C5Xe9u+ico4t8sZWXschR6fMgoPUK31yQu7hTEJb7bCqivHECwIClJfKgE7zYsh1qTP3WHUA==}
    cpu: [riscv64]
    os: [linux]
    requiresBuild: true
    optional: true

  /@rollup/rollup-linux-s390x-gnu@4.22.4:
    resolution: {integrity: sha512-GqFJ9wLlbB9daxhVlrTe61vJtEY99/xB3C8e4ULVsVfflcpmR6c8UZXjtkMA6FhNONhj2eA5Tk9uAVw5orEs4Q==}
    cpu: [s390x]
    os: [linux]
    requiresBuild: true
    optional: true

  /@rollup/rollup-linux-x64-gnu@4.22.4:
    resolution: {integrity: sha512-87v0ol2sH9GE3cLQLNEy0K/R0pz1nvg76o8M5nhMR0+Q+BBGLnb35P0fVz4CQxHYXaAOhE8HhlkaZfsdUOlHwg==}
    cpu: [x64]
    os: [linux]
    requiresBuild: true
    optional: true

  /@rollup/rollup-linux-x64-musl@4.22.4:
    resolution: {integrity: sha512-UV6FZMUgePDZrFjrNGIWzDo/vABebuXBhJEqrHxrGiU6HikPy0Z3LfdtciIttEUQfuDdCn8fqh7wiFJjCNwO+g==}
    cpu: [x64]
    os: [linux]
    requiresBuild: true
    optional: true

  /@rollup/rollup-win32-arm64-msvc@4.22.4:
    resolution: {integrity: sha512-BjI+NVVEGAXjGWYHz/vv0pBqfGoUH0IGZ0cICTn7kB9PyjrATSkX+8WkguNjWoj2qSr1im/+tTGRaY+4/PdcQw==}
    cpu: [arm64]
    os: [win32]
    requiresBuild: true
    optional: true

  /@rollup/rollup-win32-ia32-msvc@4.22.4:
    resolution: {integrity: sha512-SiWG/1TuUdPvYmzmYnmd3IEifzR61Tragkbx9D3+R8mzQqDBz8v+BvZNDlkiTtI9T15KYZhP0ehn3Dld4n9J5g==}
    cpu: [ia32]
    os: [win32]
    requiresBuild: true
    optional: true

  /@rollup/rollup-win32-x64-msvc@4.22.4:
    resolution: {integrity: sha512-j8pPKp53/lq9lMXN57S8cFz0MynJk8OWNuUnXct/9KCpKU7DgU3bYMJhwWmcqC0UU29p8Lr0/7KEVcaM6bf47Q==}
    cpu: [x64]
    os: [win32]
    requiresBuild: true
    optional: true

  /@sec-ant/readable-stream@0.4.1:
    resolution: {integrity: sha512-831qok9r2t8AlxLko40y2ebgSDhenenCatLVeW/uBtnHPyhHOvG0C7TvfgecV+wHzIm5KUICgzmVpWS+IMEAeg==}
    dev: true

  /@shikijs/core@1.18.0:
    resolution: {integrity: sha512-VK4BNVCd2leY62Nm2JjyxtRLkyrZT/tv104O81eyaCjHq4Adceq2uJVFJJAIof6lT1mBwZrEo2qT/T+grv3MQQ==}
    dependencies:
      '@shikijs/engine-javascript': 1.18.0
      '@shikijs/engine-oniguruma': 1.18.0
      '@shikijs/types': 1.18.0
      '@shikijs/vscode-textmate': 9.2.2
      '@types/hast': 3.0.4
      hast-util-to-html: 9.0.3
    dev: true

  /@shikijs/engine-javascript@1.18.0:
    resolution: {integrity: sha512-qoP/aO/ATNwYAUw1YMdaip/YVEstMZEgrwhePm83Ll9OeQPuxDZd48szZR8oSQNQBT8m8UlWxZv8EA3lFuyI5A==}
    dependencies:
      '@shikijs/types': 1.18.0
      '@shikijs/vscode-textmate': 9.2.2
      oniguruma-to-js: 0.4.3
    dev: true

  /@shikijs/engine-oniguruma@1.18.0:
    resolution: {integrity: sha512-B9u0ZKI/cud+TcmF8Chyh+R4V5qQVvyDOqXC2l2a4x73PBSBc6sZ0JRAX3eqyJswqir6ktwApUUGBYePdKnMJg==}
    dependencies:
      '@shikijs/types': 1.18.0
      '@shikijs/vscode-textmate': 9.2.2
    dev: true

  /@shikijs/transformers@1.18.0:
    resolution: {integrity: sha512-EdX/UIVaaS8qp9NWRyHIXp2dmuLpdVvx+UVpbIn9eafFlLemAuljPb2+K40ie6jrlg0uUIqkg25CM/8I34yBNw==}
    dependencies:
      shiki: 1.18.0
    dev: true

  /@shikijs/types@1.18.0:
    resolution: {integrity: sha512-O9N36UEaGGrxv1yUrN2nye7gDLG5Uq0/c1LyfmxsvzNPqlHzWo9DI0A4+fhW2y3bGKuQu/fwS7EPdKJJCowcVA==}
    dependencies:
      '@shikijs/vscode-textmate': 9.2.2
      '@types/hast': 3.0.4
    dev: true

  /@shikijs/vscode-textmate@9.2.2:
    resolution: {integrity: sha512-TMp15K+GGYrWlZM8+Lnj9EaHEFmOen0WJBrfa17hF7taDOYthuPPV0GWzfd/9iMij0akS/8Yw2ikquH7uVi/fg==}
    dev: true

  /@sindresorhus/merge-streams@2.3.0:
    resolution: {integrity: sha512-LtoMMhxAlorcGhmFYI+LhPgbPZCkgP6ra1YL604EeF6U98pLlQ3iWIGMdWSC+vWmPBWBNgmDBAhnAobLROJmwg==}
    engines: {node: '>=18'}

  /@sindresorhus/merge-streams@4.0.0:
    resolution: {integrity: sha512-tlqY9xq5ukxTUZBmoOp+m61cqwQD5pHJtFY3Mn8CA8ps6yghLH/Hw8UPdqg4OLmFW3IFlcXnQNmo/dh8HzXYIQ==}
    engines: {node: '>=18'}
    dev: true

  /@stackblitz/sdk@1.11.0:
    resolution: {integrity: sha512-DFQGANNkEZRzFk1/rDP6TcFdM82ycHE+zfl9C/M/jXlH68jiqHWHFMQURLELoD8koxvu/eW5uhg94NSAZlYrUQ==}
    dev: true

  /@types/debug@4.1.12:
    resolution: {integrity: sha512-vIChWdVG3LG1SMxEvI/AK+FWJthlrqlTu7fbrlywTkkaONwk/UAGaULXRlf8vkzFBLVm0zkMdCquhL5aOjhXPQ==}
    dependencies:
      '@types/ms': 0.7.34

  /@types/estree@1.0.5:
    resolution: {integrity: sha512-/kYRxGDLWzHOB7q+wtSUQlFrtcdUccpfy+X+9iMBpHK8QLLhx2wIPYuS5DYtR9Wa/YlZAbIovy7qVdB1Aq6Lyw==}

  /@types/fs-extra@11.0.4:
    resolution: {integrity: sha512-yTbItCNreRooED33qjunPthRcSjERP1r4MqCZc7wv0u2sUkzTFp45tgUfS5+r7FrZPdmCCNflLhVSP/o+SemsQ==}
    dependencies:
      '@types/jsonfile': 6.1.4
      '@types/node': 22.5.5

  /@types/hash-sum@1.0.2:
    resolution: {integrity: sha512-UP28RddqY8xcU0SCEp9YKutQICXpaAq9N8U2klqF5hegGha7KzTOL8EdhIIV3bOSGBzjEpN9bU/d+nNZBdJYVw==}

  /@types/hast@3.0.4:
    resolution: {integrity: sha512-WPs+bbQw5aCj+x6laNGWLH3wviHtoCv/P3+otBhbOhJgG8qtpdAMlTCxLtsTWA7LH1Oh/bFCHsBn0TPS5m30EQ==}
    dependencies:
      '@types/unist': 3.0.3
    dev: true

  /@types/jsonfile@6.1.4:
    resolution: {integrity: sha512-D5qGUYwjvnNNextdU59/+fI+spnwtTFmyQP0h+PfIOSkNfpU6AOICUOkm4i0OnSk+NyjdPJrxCDro0sJsWlRpQ==}
    dependencies:
      '@types/node': 22.5.5

  /@types/katex@0.16.7:
    resolution: {integrity: sha512-HMwFiRujE5PjrgwHQ25+bsLJgowjGjm5Z8FVSf0N6PwgJrwxH0QxzHYDcKsTfV3wva0vzrpqMTJS2jXPr5BMEQ==}
    dev: true

  /@types/linkify-it@5.0.0:
    resolution: {integrity: sha512-sVDA58zAw4eWAffKOaQH5/5j3XeayukzDk+ewSsnv3p4yJEZHCCzMDiZM8e0OUrRvmpGZ85jf4yDHkHsgBNr9Q==}

  /@types/markdown-it-emoji@3.0.1:
    resolution: {integrity: sha512-cz1j8R35XivBqq9mwnsrP2fsz2yicLhB8+PDtuVkKOExwEdsVBNI+ROL3sbhtR5occRZ66vT0QnwFZCqdjf3pA==}
    dependencies:
      '@types/markdown-it': 14.1.2

  /@types/markdown-it@14.1.2:
    resolution: {integrity: sha512-promo4eFwuiW+TfGxhi+0x3czqTYJkG8qB17ZUJiVF10Xm7NLVRSLUsfRTU/6h1e24VvRnXCx+hG7li58lkzog==}
    dependencies:
      '@types/linkify-it': 5.0.0
      '@types/mdurl': 2.0.0

  /@types/mdast@4.0.4:
    resolution: {integrity: sha512-kGaNbPh1k7AFzgpud/gMdvIm5xuECykRR+JnWKQno9TAXVa6WIVCGTPvYGekIDL4uwCZQSYbUxNBSb1aUo79oA==}
    dependencies:
      '@types/unist': 3.0.3
    dev: true

  /@types/mdurl@2.0.0:
    resolution: {integrity: sha512-RGdgjQUZba5p6QEFAVx2OGb8rQDL/cPRG7GiedRzMcJ1tYnUANBncjbSB1NRGwbvjcPeikRABz2nshyPk1bhWg==}

  /@types/ms@0.7.34:
    resolution: {integrity: sha512-nG96G3Wp6acyAgJqGasjODb+acrI7KltPiRxzHPXnP3NgI28bpQDRv53olbqGXbfcgF5aiiHmO3xpwEpS5Ld9g==}

  /@types/node@17.0.45:
    resolution: {integrity: sha512-w+tIMs3rq2afQdsPJlODhoUEKzFP1ayaoyl1CcnwtIlsVe7K7bA1NGm4s3PraqTLlXnbIN84zuBlxBWo1u9BLw==}
    dev: true

  /@types/node@22.5.5:
    resolution: {integrity: sha512-Xjs4y5UPO/CLdzpgR6GirZJx36yScjh73+2NlLlkFRSoQN8B0DpfXPdZGnvVmLRLOsqDpOfTNv7D9trgGhmOIA==}
    dependencies:
      undici-types: 6.19.8

  /@types/sax@1.2.7:
    resolution: {integrity: sha512-rO73L89PJxeYM3s3pPPjiPgVVcymqU490g0YO5n5By0k2Erzj6tay/4lr1CHAAU4JyOWd1rpQ8bCf6cZfHU96A==}
    dependencies:
      '@types/node': 17.0.45
    dev: true

  /@types/trusted-types@2.0.7:
    resolution: {integrity: sha512-ScaPdn1dQczgbl0QFTeTOmVHFULt394XJgOQNoyVhZ6r2vLnMLJfBPd53SB52T/3G36VI1/g2MZaX0cwDuXsfw==}
    dev: true

  /@types/unist@3.0.3:
    resolution: {integrity: sha512-ko/gIFJRv177XgZsZcBwnqJN5x/Gien8qNOn0D5bQU/zAzVf9Zt3BlcUiLqhV9y4ARk0GbT3tnUiPNgnTXzc/Q==}
    dev: true

  /@types/web-bluetooth@0.0.20:
    resolution: {integrity: sha512-g9gZnnXVq7gM7v3tJCWV/qw7w+KeOlSHAhgF9RytFyifW6AF61hdT2ucrYhPq9hLs5JIryeupHV3qGk95dH9ow==}

  /@ungap/structured-clone@1.2.0:
    resolution: {integrity: sha512-zuVdFrMJiuCDQUMCzQaD6KL28MjnqqN8XnAqiEq9PNm/hCPTSGfrXCOfwj1ow4LFb/tNymJPwsNbVePc1xFqrQ==}
    dev: true

  /@vitejs/plugin-vue@5.1.4(vite@5.4.7)(vue@3.5.8):
    resolution: {integrity: sha512-N2XSI2n3sQqp5w7Y/AN/L2XDjBIRGqXko+eDp42sydYSBeJuSm5a1sLf8zakmo8u7tA8NmBgoDLA1HeOESjp9A==}
    engines: {node: ^18.0.0 || >=20.0.0}
    peerDependencies:
      vite: ^5.0.0
      vue: ^3.2.25
    dependencies:
      vite: 5.4.7(sass-embedded@1.79.3)
      vue: 3.5.8

  /@vue/compiler-core@3.5.8:
    resolution: {integrity: sha512-Uzlxp91EPjfbpeO5KtC0KnXPkuTfGsNDeaKQJxQN718uz+RqDYarEf7UhQJGK+ZYloD2taUbHTI2J4WrUaZQNA==}
    dependencies:
      '@babel/parser': 7.25.6
      '@vue/shared': 3.5.8
      entities: 4.5.0
      estree-walker: 2.0.2
      source-map-js: 1.2.1

  /@vue/compiler-dom@3.5.8:
    resolution: {integrity: sha512-GUNHWvoDSbSa5ZSHT9SnV5WkStWfzJwwTd6NMGzilOE/HM5j+9EB9zGXdtu/fCNEmctBqMs6C9SvVPpVPuk1Eg==}
    dependencies:
      '@vue/compiler-core': 3.5.8
      '@vue/shared': 3.5.8

  /@vue/compiler-sfc@3.5.8:
    resolution: {integrity: sha512-taYpngQtSysrvO9GULaOSwcG5q821zCoIQBtQQSx7Uf7DxpR6CIHR90toPr9QfDD2mqHQPCSgoWBvJu0yV9zjg==}
    dependencies:
      '@babel/parser': 7.25.6
      '@vue/compiler-core': 3.5.8
      '@vue/compiler-dom': 3.5.8
      '@vue/compiler-ssr': 3.5.8
      '@vue/shared': 3.5.8
      estree-walker: 2.0.2
      magic-string: 0.30.11
      postcss: 8.4.47
      source-map-js: 1.2.1

  /@vue/compiler-ssr@3.5.8:
    resolution: {integrity: sha512-W96PtryNsNG9u0ZnN5Q5j27Z/feGrFV6zy9q5tzJVyJaLiwYxvC0ek4IXClZygyhjm+XKM7WD9pdKi/wIRVC/Q==}
    dependencies:
      '@vue/compiler-dom': 3.5.8
      '@vue/shared': 3.5.8

  /@vue/devtools-api@6.6.4:
    resolution: {integrity: sha512-sGhTPMuXqZ1rVOk32RylztWkfXTRhuS7vgAKv0zjqk8gbsHkJ7xfFf+jbySxt7tWObEJwyKaHMikV/WGDiQm8g==}

  /@vue/reactivity@3.5.8:
    resolution: {integrity: sha512-mlgUyFHLCUZcAYkqvzYnlBRCh0t5ZQfLYit7nukn1GR96gc48Bp4B7OIcSfVSvlG1k3BPfD+p22gi1t2n9tsXg==}
    dependencies:
      '@vue/shared': 3.5.8

  /@vue/runtime-core@3.5.8:
    resolution: {integrity: sha512-fJuPelh64agZ8vKkZgp5iCkPaEqFJsYzxLk9vSC0X3G8ppknclNDr61gDc45yBGTaN5Xqc1qZWU3/NoaBMHcjQ==}
    dependencies:
      '@vue/reactivity': 3.5.8
      '@vue/shared': 3.5.8

  /@vue/runtime-dom@3.5.8:
    resolution: {integrity: sha512-DpAUz+PKjTZPUOB6zJgkxVI3GuYc2iWZiNeeHQUw53kdrparSTG6HeXUrYDjaam8dVsCdvQxDz6ZWxnyjccUjQ==}
    dependencies:
      '@vue/reactivity': 3.5.8
      '@vue/runtime-core': 3.5.8
      '@vue/shared': 3.5.8
      csstype: 3.1.3

  /@vue/server-renderer@3.5.8(vue@3.5.8):
    resolution: {integrity: sha512-7AmC9/mEeV9mmXNVyUIm1a1AjUhyeeGNbkLh39J00E7iPeGks8OGRB5blJiMmvqSh8SkaS7jkLWSpXtxUCeagA==}
    peerDependencies:
      vue: 3.5.8
    dependencies:
      '@vue/compiler-ssr': 3.5.8
      '@vue/shared': 3.5.8
      vue: 3.5.8

  /@vue/shared@3.5.8:
    resolution: {integrity: sha512-mJleSWbAGySd2RJdX1RBtcrUBX6snyOc0qHpgk3lGi4l9/P/3ny3ELqFWqYdkXIwwNN/kdm8nD9ky8o6l/Lx2A==}

  /@vuepress/bundler-vite@2.0.0-rc.15(sass-embedded@1.79.3):
    resolution: {integrity: sha512-xPJBOvrt9hn+3dkMuWIpVy1Jb3a29ZPkEZ0nE10ULzLaGvN+Lv6tB7FPTN9d67LGT4wi09X0EXSvWg9Eun+6pQ==}
    dependencies:
      '@vitejs/plugin-vue': 5.1.4(vite@5.4.7)(vue@3.5.8)
      '@vuepress/client': 2.0.0-rc.15
      '@vuepress/core': 2.0.0-rc.15
      '@vuepress/shared': 2.0.0-rc.15
      '@vuepress/utils': 2.0.0-rc.15
      autoprefixer: 10.4.20(postcss@8.4.47)
      connect-history-api-fallback: 2.0.0
      postcss: 8.4.47
      postcss-load-config: 6.0.1(postcss@8.4.47)
      rollup: 4.22.4
      vite: 5.4.7(sass-embedded@1.79.3)
      vue: 3.5.8
      vue-router: 4.4.5(vue@3.5.8)
    transitivePeerDependencies:
      - '@types/node'
      - jiti
      - less
      - lightningcss
      - sass
      - sass-embedded
      - stylus
      - sugarss
      - supports-color
      - terser
      - tsx
      - typescript
      - yaml

  /@vuepress/cli@2.0.0-rc.15:
    resolution: {integrity: sha512-frJ0G4sOWUicpa6P1avpgYT0ZLfaAPeRCugghaQGVPnssYuddsP9KBIwfsJ5RP4lWpwfcsdZEuJKKrVJDh6PkQ==}
    hasBin: true
    dependencies:
      '@vuepress/core': 2.0.0-rc.15
      '@vuepress/shared': 2.0.0-rc.15
      '@vuepress/utils': 2.0.0-rc.15
      cac: 6.7.14
      chokidar: 3.6.0
      envinfo: 7.14.0
      esbuild: 0.21.5
    transitivePeerDependencies:
      - supports-color
      - typescript

  /@vuepress/client@2.0.0-rc.15:
    resolution: {integrity: sha512-73TWRIFKFqDRI+JHFjVWUJNfeExBYUxR7QuB5ZrtbntvN7Tu+Qr6wMwTU9bwDttRIaxUzoTBuTN5wfAiijokHg==}
    dependencies:
      '@vue/devtools-api': 6.6.4
      '@vuepress/shared': 2.0.0-rc.15
      vue: 3.5.8
      vue-router: 4.4.5(vue@3.5.8)
    transitivePeerDependencies:
      - typescript

  /@vuepress/core@2.0.0-rc.15:
    resolution: {integrity: sha512-CcVuANpF3k5QH6k27uShpQc+fdb35QdMbqNr4YEBleCVM2M5fHPeA8Did2OgzDzdr15G+AX2aP98yNVLgNR8cw==}
    dependencies:
      '@vuepress/client': 2.0.0-rc.15
      '@vuepress/markdown': 2.0.0-rc.15
      '@vuepress/shared': 2.0.0-rc.15
      '@vuepress/utils': 2.0.0-rc.15
      vue: 3.5.8
    transitivePeerDependencies:
      - supports-color
      - typescript

  /@vuepress/helper@2.0.0-rc.47(vuepress@2.0.0-rc.15):
    resolution: {integrity: sha512-XlfrkRjxv7Id3sc8Wjh7pHs2eFhOE/HAA+u9AMLZHcfxZUBkIftBfrSqg9ZBGybVkm4aGT+K/sC2IZxFhqukiA==}
    peerDependencies:
      vuepress: 2.0.0-rc.15
    dependencies:
      '@vue/shared': 3.5.8
      '@vueuse/core': 11.1.0(vue@3.5.8)
      cheerio: 1.0.0
      fflate: 0.8.2
      gray-matter: 4.0.3
      vue: 3.5.8
      vuepress: 2.0.0-rc.15(@vuepress/bundler-vite@2.0.0-rc.15)(vue@3.5.8)
    transitivePeerDependencies:
      - '@vue/composition-api'
      - typescript

  /@vuepress/highlighter-helper@2.0.0-rc.46(@vueuse/core@11.1.0)(vuepress@2.0.0-rc.15):
    resolution: {integrity: sha512-F1Uuw8Oz0bz+MvT6hTa27rHz1fckd17xmExazVFxSRWvqlMyjKsl+gW4Wd12DOMDGXOViZrul5SUyO5YPSHcfg==}
    peerDependencies:
      '@vueuse/core': ^11.0.0
      vuepress: 2.0.0-rc.15
    peerDependenciesMeta:
      '@vueuse/core':
        optional: true
    dependencies:
      '@vueuse/core': 11.1.0(vue@3.5.8)
      vuepress: 2.0.0-rc.15(@vuepress/bundler-vite@2.0.0-rc.15)(vue@3.5.8)
    dev: true

  /@vuepress/markdown@2.0.0-rc.15:
    resolution: {integrity: sha512-q+yuwV+PzvFCs92Q/O/3HHRDY9CNYKJgc+fKbqE98P3qGBATnDtABUjc+NjtPvG4OdYt2fELTXOzyprE8omFIw==}
    dependencies:
      '@mdit-vue/plugin-component': 2.1.3
      '@mdit-vue/plugin-frontmatter': 2.1.3
      '@mdit-vue/plugin-headers': 2.1.3
      '@mdit-vue/plugin-sfc': 2.1.3
      '@mdit-vue/plugin-title': 2.1.3
      '@mdit-vue/plugin-toc': 2.1.3
      '@mdit-vue/shared': 2.1.3
      '@mdit-vue/types': 2.1.0
      '@types/markdown-it': 14.1.2
      '@types/markdown-it-emoji': 3.0.1
      '@vuepress/shared': 2.0.0-rc.15
      '@vuepress/utils': 2.0.0-rc.15
      markdown-it: 14.1.0
      markdown-it-anchor: 9.2.0(@types/markdown-it@14.1.2)(markdown-it@14.1.0)
      markdown-it-emoji: 3.0.0
      mdurl: 2.0.0
    transitivePeerDependencies:
      - supports-color

  /@vuepress/plugin-active-header-links@2.0.0-rc.47(vuepress@2.0.0-rc.15):
    resolution: {integrity: sha512-Y7pB8opzVmzkOPlQo6pWpP+xdagkVM+gKruudb+IR6irF8p53W77VWsdwxep8nmd02gk8gewGM+Wud7as4iV9w==}
    peerDependencies:
      vuepress: 2.0.0-rc.15
    dependencies:
      '@vueuse/core': 11.1.0(vue@3.5.8)
      vue: 3.5.8
      vuepress: 2.0.0-rc.15(@vuepress/bundler-vite@2.0.0-rc.15)(vue@3.5.8)
    transitivePeerDependencies:
      - '@vue/composition-api'
      - typescript
    dev: true

  /@vuepress/plugin-back-to-top@2.0.0-rc.47(vuepress@2.0.0-rc.15):
    resolution: {integrity: sha512-ErJgrVRlpEUwf4DYSIYRXfYmIklUuiZ2D98szIQa6mfSybcOFYTur+MCV/jkpEulXn4UPAQIL/qI2FqdLha6RQ==}
    peerDependencies:
      vuepress: 2.0.0-rc.15
    dependencies:
      '@vuepress/helper': 2.0.0-rc.47(vuepress@2.0.0-rc.15)
      '@vueuse/core': 11.1.0(vue@3.5.8)
      vue: 3.5.8
      vuepress: 2.0.0-rc.15(@vuepress/bundler-vite@2.0.0-rc.15)(vue@3.5.8)
    transitivePeerDependencies:
      - '@vue/composition-api'
      - typescript
    dev: true

  /@vuepress/plugin-blog@2.0.0-rc.47(vuepress@2.0.0-rc.15):
    resolution: {integrity: sha512-8gGPy8c1FNxygis6vncm7ZmfxHgOzGFKgyXr9Df0YqjJeDHizE+0KWSab+qLp6GUa6ili7/nTHSggN5NnBkTeg==}
    peerDependencies:
      vuepress: 2.0.0-rc.15
    dependencies:
      '@vuepress/helper': 2.0.0-rc.47(vuepress@2.0.0-rc.15)
      chokidar: 3.6.0
      vue: 3.5.8
      vuepress: 2.0.0-rc.15(@vuepress/bundler-vite@2.0.0-rc.15)(vue@3.5.8)
    transitivePeerDependencies:
      - '@vue/composition-api'
      - typescript
    dev: true

  /@vuepress/plugin-catalog@2.0.0-rc.47(vuepress@2.0.0-rc.15):
    resolution: {integrity: sha512-2ADxFNEZWo1p1mjtNEouW3A5WDSBV/veCSo293J0Ye6aXNnljkFFVXdZ/NG/vNLvcQ6WR6u48Mvr5kj5k8pxfg==}
    peerDependencies:
      vuepress: 2.0.0-rc.15
    dependencies:
      '@vuepress/helper': 2.0.0-rc.47(vuepress@2.0.0-rc.15)
      vue: 3.5.8
      vuepress: 2.0.0-rc.15(@vuepress/bundler-vite@2.0.0-rc.15)(vue@3.5.8)
    transitivePeerDependencies:
      - '@vue/composition-api'
      - typescript
    dev: true

  /@vuepress/plugin-comment@2.0.0-rc.47(vuepress@2.0.0-rc.15):
    resolution: {integrity: sha512-HULK4Dt5Mj+vU8pppADXgjnQb2TULyVNlJILKR7L8+HgXi860+W6SbFvtMh/VF92MY0x6NUUeDeD/XoiXgOKnA==}
    peerDependencies:
      '@waline/client': ^3.3.1
      artalk: ^2.9.0
      twikoo: ^1.6.39
      vuepress: 2.0.0-rc.15
    peerDependenciesMeta:
      '@waline/client':
        optional: true
      artalk:
        optional: true
      twikoo:
        optional: true
    dependencies:
      '@vuepress/helper': 2.0.0-rc.47(vuepress@2.0.0-rc.15)
      giscus: 1.5.0
      vue: 3.5.8
      vuepress: 2.0.0-rc.15(@vuepress/bundler-vite@2.0.0-rc.15)(vue@3.5.8)
    transitivePeerDependencies:
      - '@vue/composition-api'
      - typescript
    dev: true

  /@vuepress/plugin-copy-code@2.0.0-rc.47(vuepress@2.0.0-rc.15):
    resolution: {integrity: sha512-14astazMzqPC15J3e1yu+t7qR6FuWHOcZlZ6DSIr1wUwIWnchk6ZPzEli/A8WPnUs3eKObNH7lI3vqkWJVgFZQ==}
    peerDependencies:
      vuepress: 2.0.0-rc.15
    dependencies:
      '@vuepress/helper': 2.0.0-rc.47(vuepress@2.0.0-rc.15)
      '@vueuse/core': 11.1.0(vue@3.5.8)
      vue: 3.5.8
      vuepress: 2.0.0-rc.15(@vuepress/bundler-vite@2.0.0-rc.15)(vue@3.5.8)
    transitivePeerDependencies:
      - '@vue/composition-api'
      - typescript
    dev: true

  /@vuepress/plugin-copyright@2.0.0-rc.47(vuepress@2.0.0-rc.15):
    resolution: {integrity: sha512-1q0qnU4t+W/BgnKbIfjvO4lrjvtint0TGPvOkeGpDJBJvsR0Ih+ep/kCp2QcUl95CZQvdqYPq3cqR0yxhlFTng==}
    peerDependencies:
      vuepress: 2.0.0-rc.15
    dependencies:
      '@vuepress/helper': 2.0.0-rc.47(vuepress@2.0.0-rc.15)
      '@vueuse/core': 11.1.0(vue@3.5.8)
      vue: 3.5.8
      vuepress: 2.0.0-rc.15(@vuepress/bundler-vite@2.0.0-rc.15)(vue@3.5.8)
    transitivePeerDependencies:
      - '@vue/composition-api'
      - typescript
    dev: true

  /@vuepress/plugin-git@2.0.0-rc.44(vuepress@2.0.0-rc.15):
    resolution: {integrity: sha512-E4gckcH1vOexhxVTNKJFN5XxYn4IUuu4zz86yybxPm0NObdc8Uu5cYFP/lVnAformqMzxhQrws8UmUD1yX0gEA==}
    peerDependencies:
      vuepress: 2.0.0-rc.15
    dependencies:
      execa: 9.4.0
      vuepress: 2.0.0-rc.15(@vuepress/bundler-vite@2.0.0-rc.15)(vue@3.5.8)
    dev: true

  /@vuepress/plugin-links-check@2.0.0-rc.47(vuepress@2.0.0-rc.15):
    resolution: {integrity: sha512-IRy2pM9c6QFAXZ0LpQR9OY+fq5RjNFqux1Y8vBrn9iwY1RJ4BdvkTdvO5OkslFfM4QguLlirmvYtjPS09Qh9HA==}
    peerDependencies:
      vuepress: 2.0.0-rc.15
    dependencies:
      '@vuepress/helper': 2.0.0-rc.47(vuepress@2.0.0-rc.15)
      vuepress: 2.0.0-rc.15(@vuepress/bundler-vite@2.0.0-rc.15)(vue@3.5.8)
    transitivePeerDependencies:
      - '@vue/composition-api'
      - typescript
    dev: true

  /@vuepress/plugin-markdown-hint@2.0.0-rc.47(markdown-it@14.1.0)(vue@3.5.8)(vuepress@2.0.0-rc.15):
    resolution: {integrity: sha512-TCK9uaLjnCIhhDYn5zBZIgzKeLUpgwG2cuJ0fAcmzKTF/0Am/+G4cLsnbwqrfEZr0WMooWG1KFjTHMAQ+f6lNQ==}
    peerDependencies:
      vuepress: 2.0.0-rc.15
    dependencies:
      '@mdit/plugin-alert': 0.13.1(markdown-it@14.1.0)
      '@mdit/plugin-container': 0.13.1(markdown-it@14.1.0)
      '@types/markdown-it': 14.1.2
      '@vuepress/helper': 2.0.0-rc.47(vuepress@2.0.0-rc.15)
      '@vueuse/core': 11.1.0(vue@3.5.8)
      vuepress: 2.0.0-rc.15(@vuepress/bundler-vite@2.0.0-rc.15)(vue@3.5.8)
    transitivePeerDependencies:
      - '@vue/composition-api'
      - markdown-it
      - typescript
      - vue
    dev: true

  /@vuepress/plugin-markdown-image@2.0.0-rc.47(markdown-it@14.1.0)(vuepress@2.0.0-rc.15):
    resolution: {integrity: sha512-clZuFplQq7RaXh0Itp6sUT/Dw+i0dou+bCfqDTPhU91AsnNDCJkyPWar7xQHBvYKkBcwD/Lh5GLRludH+PaAGg==}
    peerDependencies:
      vuepress: 2.0.0-rc.15
    dependencies:
      '@mdit/plugin-figure': 0.13.1(markdown-it@14.1.0)
      '@mdit/plugin-img-lazyload': 0.13.1(markdown-it@14.1.0)
      '@mdit/plugin-img-mark': 0.13.1(markdown-it@14.1.0)
      '@mdit/plugin-img-size': 0.13.1(markdown-it@14.1.0)
      '@types/markdown-it': 14.1.2
      '@vuepress/helper': 2.0.0-rc.47(vuepress@2.0.0-rc.15)
      vuepress: 2.0.0-rc.15(@vuepress/bundler-vite@2.0.0-rc.15)(vue@3.5.8)
    transitivePeerDependencies:
      - '@vue/composition-api'
      - markdown-it
      - typescript

  /@vuepress/plugin-markdown-math@2.0.0-rc.49(markdown-it@14.1.0)(vuepress@2.0.0-rc.15):
    resolution: {integrity: sha512-1SuXKrlbyZqk3gLdtWxB/PRLVhsnz+i7W0IwvMj1fIB6iMIToWypUX1xeOnNHq3q5NWtRYOj8en+Xs5r906IVw==}
    peerDependencies:
      katex: ^0.16.10
      mathjax-full: ^3.2.2
      vuepress: 2.0.0-rc.15
    peerDependenciesMeta:
      katex:
        optional: true
      mathjax-full:
        optional: true
    dependencies:
      '@mdit/plugin-katex-slim': 0.13.1(markdown-it@14.1.0)
      '@mdit/plugin-mathjax-slim': 0.13.1(markdown-it@14.1.0)
      '@types/markdown-it': 14.1.2
      '@vuepress/helper': 2.0.0-rc.47(vuepress@2.0.0-rc.15)
      vue: 3.5.8
      vuepress: 2.0.0-rc.15(@vuepress/bundler-vite@2.0.0-rc.15)(vue@3.5.8)
    transitivePeerDependencies:
      - '@vue/composition-api'
      - markdown-it
      - typescript
    dev: true

  /@vuepress/plugin-markdown-tab@2.0.0-rc.47(markdown-it@14.1.0)(vuepress@2.0.0-rc.15):
    resolution: {integrity: sha512-oB3/slwgCSOxPejsi8nuzVCFRpaVFqQXUwzyH5DJYofTiwl51ELT2Jhbiz3fqBljTCQk0Ts2e+H10jUgo8Yg+w==}
    peerDependencies:
      vuepress: 2.0.0-rc.15
    dependencies:
      '@mdit/plugin-tab': 0.13.1(markdown-it@14.1.0)
      '@types/markdown-it': 14.1.2
      '@vuepress/helper': 2.0.0-rc.47(vuepress@2.0.0-rc.15)
      '@vueuse/core': 11.1.0(vue@3.5.8)
      vue: 3.5.8
      vuepress: 2.0.0-rc.15(@vuepress/bundler-vite@2.0.0-rc.15)(vue@3.5.8)
    transitivePeerDependencies:
      - '@vue/composition-api'
      - markdown-it
      - typescript

  /@vuepress/plugin-notice@2.0.0-rc.47(vuepress@2.0.0-rc.15):
    resolution: {integrity: sha512-FutASd2pk8tj09fzFDBvHdAu4CjSQ7fIFIvfH2nzd0zbYTJ7AXqXd5ey4G26vIDsfi5d9ZRh+HPAgSqD195c8Q==}
    peerDependencies:
      vuepress: 2.0.0-rc.15
    dependencies:
      '@vuepress/helper': 2.0.0-rc.47(vuepress@2.0.0-rc.15)
      '@vueuse/core': 11.1.0(vue@3.5.8)
      vue: 3.5.8
      vuepress: 2.0.0-rc.15(@vuepress/bundler-vite@2.0.0-rc.15)(vue@3.5.8)
    transitivePeerDependencies:
      - '@vue/composition-api'
      - typescript
    dev: true

  /@vuepress/plugin-nprogress@2.0.0-rc.47(vuepress@2.0.0-rc.15):
    resolution: {integrity: sha512-+e40iceSYnXOd6IW5a2lhDAiGVDQ/XvrL20KRYwERHcsUWqRKrzNpSiI8YhTucG+N2juLDaJsZNjeia2HofErQ==}
    peerDependencies:
      vuepress: 2.0.0-rc.15
    dependencies:
      '@vuepress/helper': 2.0.0-rc.47(vuepress@2.0.0-rc.15)
      vue: 3.5.8
      vuepress: 2.0.0-rc.15(@vuepress/bundler-vite@2.0.0-rc.15)(vue@3.5.8)
    transitivePeerDependencies:
      - '@vue/composition-api'
      - typescript
    dev: true

  /@vuepress/plugin-photo-swipe@2.0.0-rc.47(vuepress@2.0.0-rc.15):
    resolution: {integrity: sha512-p4dadqlv97KtfU/7Fpx5Ck8ofz/4grRh7o8Vd+Q7MCuinPWCUs3ywhToU+9Sukkv2FcVGRi4LPBJkBntN5IKLg==}
    peerDependencies:
      vuepress: 2.0.0-rc.15
    dependencies:
      '@vuepress/helper': 2.0.0-rc.47(vuepress@2.0.0-rc.15)
      '@vueuse/core': 11.1.0(vue@3.5.8)
      photoswipe: 5.4.4
      vue: 3.5.8
      vuepress: 2.0.0-rc.15(@vuepress/bundler-vite@2.0.0-rc.15)(vue@3.5.8)
    transitivePeerDependencies:
      - '@vue/composition-api'
      - typescript
    dev: true

  /@vuepress/plugin-reading-time@2.0.0-rc.47(vuepress@2.0.0-rc.15):
    resolution: {integrity: sha512-OHIMnFx8np0u0m0ujTg4QBya/imG+hIbMPP9jEDfF48fxoXGwWZyw0RfmwOQXrAtcjpOkZ25jkvqn2ZrjPM1jg==}
    peerDependencies:
      vuepress: 2.0.0-rc.15
    dependencies:
      '@vuepress/helper': 2.0.0-rc.47(vuepress@2.0.0-rc.15)
      vue: 3.5.8
      vuepress: 2.0.0-rc.15(@vuepress/bundler-vite@2.0.0-rc.15)(vue@3.5.8)
    transitivePeerDependencies:
      - '@vue/composition-api'
      - typescript
    dev: true

  /@vuepress/plugin-redirect@2.0.0-rc.51(vuepress@2.0.0-rc.15):
    resolution: {integrity: sha512-7iLMlvYbd1I1r43+2vnXSiGx5OzD5DLwVAo5RcS4DIKK9/MqqESfWjGdLJf0Dyx3uEgPiFCVS/qkCeuLy13BxA==}
    hasBin: true
    peerDependencies:
      vuepress: 2.0.0-rc.15
    dependencies:
      '@vuepress/helper': 2.0.0-rc.47(vuepress@2.0.0-rc.15)
      '@vueuse/core': 11.1.0(vue@3.5.8)
      cac: 6.7.14
      vue: 3.5.8
      vuepress: 2.0.0-rc.15(@vuepress/bundler-vite@2.0.0-rc.15)(vue@3.5.8)
    transitivePeerDependencies:
      - '@vue/composition-api'
      - typescript

  /@vuepress/plugin-rtl@2.0.0-rc.47(vuepress@2.0.0-rc.15):
    resolution: {integrity: sha512-0Xbm1aGmJFRKLKdKE3nc/flhscBfINEZh5BcJatu3RUsG6sr/wazHS03O/lq6ebhUT7dwCHdJjyEMwwee84iKQ==}
    peerDependencies:
      vuepress: 2.0.0-rc.15
    dependencies:
      vue: 3.5.8
      vuepress: 2.0.0-rc.15(@vuepress/bundler-vite@2.0.0-rc.15)(vue@3.5.8)
    transitivePeerDependencies:
      - typescript
    dev: true

  /@vuepress/plugin-sass-palette@2.0.0-rc.51(sass-embedded@1.79.3)(vuepress@2.0.0-rc.15):
    resolution: {integrity: sha512-OvO19SRmcNHXqMI8FG+BBDkg1sSe55KWOLArBcquAkrLvf2JYR0urmPJfNauPBbLcNWwS6dTkSwBFJ4FGJ28Dw==}
    peerDependencies:
      sass: ^1.79.2
      sass-embedded: ^1.79.2
      sass-loader: ^16.0.1
      vuepress: 2.0.0-rc.15
    peerDependenciesMeta:
      sass:
        optional: true
      sass-embedded:
        optional: true
      sass-loader:
        optional: true
    dependencies:
      '@vuepress/helper': 2.0.0-rc.47(vuepress@2.0.0-rc.15)
      chokidar: 4.0.1
      sass-embedded: 1.79.3
      vuepress: 2.0.0-rc.15(@vuepress/bundler-vite@2.0.0-rc.15)(vue@3.5.8)
    transitivePeerDependencies:
      - '@vue/composition-api'
      - typescript
    dev: true

  /@vuepress/plugin-seo@2.0.0-rc.47(vuepress@2.0.0-rc.15):
    resolution: {integrity: sha512-CLcot2K+H13eCrB/dyKoZ/GZf+jg+CCKiNyGI3o48U4oLT8qYQJpYtccAUvJ5a9yCPlrUB8VwsL/CGflJIbitw==}
    peerDependencies:
      vuepress: 2.0.0-rc.15
    dependencies:
      '@vuepress/helper': 2.0.0-rc.47(vuepress@2.0.0-rc.15)
      vuepress: 2.0.0-rc.15(@vuepress/bundler-vite@2.0.0-rc.15)(vue@3.5.8)
    transitivePeerDependencies:
      - '@vue/composition-api'
      - typescript
    dev: true

  /@vuepress/plugin-shiki@2.0.0-rc.47(@vueuse/core@11.1.0)(vuepress@2.0.0-rc.15):
    resolution: {integrity: sha512-z86/+Gq53xnbBr/w+FzHlJOPMzwulKwWVSlidpbzmJXDfRmWBoX2fYpAuxgHikYeXPgGML10nV3pnHPW1I7ChA==}
    peerDependencies:
      vuepress: 2.0.0-rc.15
    dependencies:
      '@shikijs/transformers': 1.18.0
      '@vuepress/helper': 2.0.0-rc.47(vuepress@2.0.0-rc.15)
      '@vuepress/highlighter-helper': 2.0.0-rc.46(@vueuse/core@11.1.0)(vuepress@2.0.0-rc.15)
      nanoid: 5.0.7
      shiki: 1.18.0
      vuepress: 2.0.0-rc.15(@vuepress/bundler-vite@2.0.0-rc.15)(vue@3.5.8)
    transitivePeerDependencies:
      - '@vue/composition-api'
      - '@vueuse/core'
      - typescript
    dev: true

  /@vuepress/plugin-sitemap@2.0.0-rc.47(vuepress@2.0.0-rc.15):
    resolution: {integrity: sha512-iO0zvX9YyDQqKd9l8B/9xM3jKH6yxmK0Rlc/6ICubsqOfYutv3rEwgzWS5Sddd0eCL8a8u4jfY7TZyjDbdihnQ==}
    peerDependencies:
      vuepress: 2.0.0-rc.15
    dependencies:
      '@vuepress/helper': 2.0.0-rc.47(vuepress@2.0.0-rc.15)
      sitemap: 8.0.0
      vuepress: 2.0.0-rc.15(@vuepress/bundler-vite@2.0.0-rc.15)(vue@3.5.8)
    transitivePeerDependencies:
      - '@vue/composition-api'
      - typescript
    dev: true

  /@vuepress/plugin-theme-data@2.0.0-rc.47(vuepress@2.0.0-rc.15):
    resolution: {integrity: sha512-A4ifo9Wcq1ZyPNK28XnoqZsbgmxL2tcm9Pq1pRN5zodqZ0hvWHSXahW7QtCdEzayrjjQGp//mOd2nvw75zWHwg==}
    peerDependencies:
      vuepress: 2.0.0-rc.15
    dependencies:
      '@vue/devtools-api': 6.6.4
      vue: 3.5.8
      vuepress: 2.0.0-rc.15(@vuepress/bundler-vite@2.0.0-rc.15)(vue@3.5.8)
    transitivePeerDependencies:
      - typescript
    dev: true

  /@vuepress/plugin-watermark@2.0.0-rc.47(vuepress@2.0.0-rc.15):
    resolution: {integrity: sha512-yI4ri60n0eIArDX/LjgalUH86RAWO+No4UnJ+vn1bk3pOGDIQ0DgjsTB3wT6Qw2JuFRDWCaQNPGUyna3pe5SMw==}
    peerDependencies:
      vuepress: 2.0.0-rc.15
    dependencies:
      '@vuepress/helper': 2.0.0-rc.47(vuepress@2.0.0-rc.15)
      vue: 3.5.8
      vuepress: 2.0.0-rc.15(@vuepress/bundler-vite@2.0.0-rc.15)(vue@3.5.8)
      watermark-js-plus: 1.5.6
    transitivePeerDependencies:
      - '@vue/composition-api'
      - typescript
    dev: true

  /@vuepress/shared@2.0.0-rc.15:
    resolution: {integrity: sha512-KLTTw0MWXrLw5XQ8h6y1iI11zJdlZcB8jXgAdOHFJ3a++InDYmUC0aCE0KbXyQTH46ODpMadJnz8/RewCftVXg==}
    dependencies:
      '@mdit-vue/types': 2.1.0

  /@vuepress/utils@2.0.0-rc.15:
    resolution: {integrity: sha512-yHdMxPg8yxlAz/QL5G7U1IQ+jk34sCtn8H8X5j+A2U1x/j2lnr8LLDWzl84TyN78pdEA1cQL5g7Ks/zTzrIWhQ==}
    dependencies:
      '@types/debug': 4.1.12
      '@types/fs-extra': 11.0.4
      '@types/hash-sum': 1.0.2
      '@vuepress/shared': 2.0.0-rc.15
      debug: 4.3.7
      fs-extra: 11.2.0
      globby: 14.0.2
      hash-sum: 2.0.0
      ora: 8.1.0
      picocolors: 1.1.0
      upath: 2.0.1
    transitivePeerDependencies:
      - supports-color

  /@vueuse/core@11.1.0(vue@3.5.8):
    resolution: {integrity: sha512-P6dk79QYA6sKQnghrUz/1tHi0n9mrb/iO1WTMk/ElLmTyNqgDeSZ3wcDf6fRBGzRJbeG1dxzEOvLENMjr+E3fg==}
    dependencies:
      '@types/web-bluetooth': 0.0.20
      '@vueuse/metadata': 11.1.0
      '@vueuse/shared': 11.1.0(vue@3.5.8)
      vue-demi: 0.14.10(vue@3.5.8)
    transitivePeerDependencies:
      - '@vue/composition-api'
      - vue

  /@vueuse/metadata@11.1.0:
    resolution: {integrity: sha512-l9Q502TBTaPYGanl1G+hPgd3QX5s4CGnpXriVBR5fEZ/goI6fvDaVmIl3Td8oKFurOxTmbXvBPSsgrd6eu6HYg==}

  /@vueuse/shared@11.1.0(vue@3.5.8):
    resolution: {integrity: sha512-YUtIpY122q7osj+zsNMFAfMTubGz0sn5QzE5gPzAIiCmtt2ha3uQUY1+JPyL4gRCTsLPX82Y9brNbo/aqlA91w==}
    dependencies:
      vue-demi: 0.14.10(vue@3.5.8)
    transitivePeerDependencies:
      - '@vue/composition-api'
      - vue

  /ansi-regex@5.0.1:
    resolution: {integrity: sha512-quJQXlTSUGL2LH9SUXo8VwsY4soanhgo6LNSm84E1LBcE8s3O0wpdiRzyR9z/ZZJMlMWv37qOOb9pdJlMUEKFQ==}
    engines: {node: '>=8'}
    dev: true

  /ansi-regex@6.1.0:
    resolution: {integrity: sha512-7HSX4QQb4CspciLpVFwyRe79O3xsIZDDLER21kERQ71oaPodF8jL725AgJMFAYbooIqolJoRLuM81SpeUkpkvA==}
    engines: {node: '>=12'}

  /ansi-styles@4.3.0:
    resolution: {integrity: sha512-zbB9rCJAT1rbjiVDb2hqKFHNYLxgtk8NURxZ3IZwD3F6NtxbXZQCnnSi1Lkx+IDohdPlFp222wVALIheZJQSEg==}
    engines: {node: '>=8'}
    dependencies:
      color-convert: 2.0.1
    dev: true

  /anymatch@3.1.3:
    resolution: {integrity: sha512-KMReFUr0B4t+D+OBkjR3KYqvocp2XaSzO55UcB6mgQMd3KbcE+mWTyvVV7D/zsdEbNnV6acZUutkiHQXvTr1Rw==}
    engines: {node: '>= 8'}
    dependencies:
      normalize-path: 3.0.0
      picomatch: 2.3.1

  /arg@5.0.2:
    resolution: {integrity: sha512-PYjyFOLKQ9y57JvQ6QLo8dAgNqswh8M1RMJYdQduT6xbWSgK36P/Z/v+p888pM69jMMfS8Xd8F6I1kQ/I9HUGg==}
    dev: true

  /argparse@1.0.10:
    resolution: {integrity: sha512-o5Roy6tNG4SL/FOkCAN6RzjiakZS25RLYFrcMttJqbdd8BWrnA+fGz57iN5Pb06pvBGvl5gQ0B48dJlslXvoTg==}
    dependencies:
      sprintf-js: 1.0.3

  /argparse@2.0.1:
    resolution: {integrity: sha512-8+9WqebbFzpX9OR+Wa6O29asIogeRMzcGtAINdpMHHyAg10f05aSFVBbcEqGf/PXw1EjAZ+q2/bEBg3DvurK3Q==}

  /autoprefixer@10.4.20(postcss@8.4.47):
    resolution: {integrity: sha512-XY25y5xSv/wEoqzDyXXME4AFfkZI0P23z6Fs3YgymDnKJkCGOnkL0iTxCa85UTqaSgfcqyf3UA6+c7wUvx/16g==}
    engines: {node: ^10 || ^12 || >=14}
    hasBin: true
    peerDependencies:
      postcss: ^8.1.0
    dependencies:
      browserslist: 4.23.3
      caniuse-lite: 1.0.30001663
      fraction.js: 4.3.7
      normalize-range: 0.1.2
      picocolors: 1.1.0
      postcss: 8.4.47
      postcss-value-parser: 4.2.0

  /balloon-css@1.2.0:
    resolution: {integrity: sha512-urXwkHgwp6GsXVF+it01485Z2Cj4pnW02ICnM0TemOlkKmCNnDLmyy+ZZiRXBpwldUXO+aRNr7Hdia4CBvXJ5A==}
    dev: true

  /bcrypt-ts@5.0.2:
    resolution: {integrity: sha512-gDwQ5784AkkfhHACh3jGcg1hUubyZyeq9AtVd5gXkcyHGVOC+mORjRIHSj+fHfqwY5vxwyBLXQpcfk8MpK0ROg==}
    engines: {node: '>=18'}
    dev: true

  /binary-extensions@2.3.0:
    resolution: {integrity: sha512-Ceh+7ox5qe7LJuLHoY0feh3pHuUDHAcRUeyL2VYghZwfpkNIy/+8Ocg0a3UuSoYzavmylwuLWQOf3hl0jjMMIw==}
    engines: {node: '>=8'}

  /boolbase@1.0.0:
    resolution: {integrity: sha512-JZOSA7Mo9sNGB8+UjSgzdLtokWAky1zbztM3WRLCbZ70/3cTANmQmOdR7y2g+J0e2WXywy1yS468tY+IruqEww==}

  /braces@3.0.3:
    resolution: {integrity: sha512-yQbXgO/OSZVD2IsiLlro+7Hf6Q18EJrKSEsdoMzKePKXct3gvD8oLcOQdIzGupr5Fj+EDe8gO/lxc1BzfMpxvA==}
    engines: {node: '>=8'}
    dependencies:
      fill-range: 7.1.1

  /browserslist@4.23.3:
    resolution: {integrity: sha512-btwCFJVjI4YWDNfau8RhZ+B1Q/VLoUITrm3RlP6y1tYGWIOa+InuYiRGXUBXo8nA1qKmHMyLB/iVQg5TT4eFoA==}
    engines: {node: ^6 || ^7 || ^8 || ^9 || ^10 || ^11 || ^12 || >=13.7}
    hasBin: true
    dependencies:
      caniuse-lite: 1.0.30001663
      electron-to-chromium: 1.5.27
      node-releases: 2.0.18
      update-browserslist-db: 1.1.0(browserslist@4.23.3)

  /buffer-builder@0.2.0:
    resolution: {integrity: sha512-7VPMEPuYznPSoR21NE1zvd2Xna6c/CloiZCfcMXR1Jny6PjX0N4Nsa38zcBFo/FMK+BlA+FLKbJCQ0i2yxp+Xg==}

  /cac@6.7.14:
    resolution: {integrity: sha512-b6Ilus+c3RrdDk+JhLKUAQfzzgLEPy6wcXqS7f/xe1EETvsDP6GORG7SFuOs6cID5YkqchW/LXZbX5bc8j7ZcQ==}
    engines: {node: '>=8'}

  /camelcase@5.3.1:
    resolution: {integrity: sha512-L28STB170nwWS63UjtlEOE3dldQApaJXZkOI1uMFfzf3rRuPegHaHesyee+YxQ+W6SvRDQV6UrdOdRiR153wJg==}
    engines: {node: '>=6'}
    dev: true

  /caniuse-lite@1.0.30001663:
    resolution: {integrity: sha512-o9C3X27GLKbLeTYZ6HBOLU1tsAcBZsLis28wrVzddShCS16RujjHp9GDHKZqrB3meE0YjhawvMFsGb/igqiPzA==}

  /ccount@2.0.1:
    resolution: {integrity: sha512-eyrF0jiFpY+3drT6383f1qhkbGsLSifNAjA61IUjZjmLCWjItY6LB9ft9YhoDgwfmclB2zhu51Lc7+95b8NRAg==}
    dev: true

  /chalk@5.3.0:
    resolution: {integrity: sha512-dLitG79d+GV1Nb/VYcCDFivJeK1hiukt9QjRNVOsUtTy1rR1YJsmpGGTZ3qJos+uw7WmWF4wUwBd9jxjocFC2w==}
    engines: {node: ^12.17.0 || ^14.13 || >=16.0.0}

  /character-entities-html4@2.1.0:
    resolution: {integrity: sha512-1v7fgQRj6hnSwFpq1Eu0ynr/CDEw0rXo2B61qXrLNdHZmPKgb7fqS1a2JwF0rISo9q77jDI8VMEHoApn8qDoZA==}
    dev: true

  /character-entities-legacy@3.0.0:
    resolution: {integrity: sha512-RpPp0asT/6ufRm//AJVwpViZbGM/MkjQFxJccQRHmISF/22NBtsHqAWmL+/pmkPWoIUJdWyeVleTl1wydHATVQ==}
    dev: true

  /cheerio-select@2.1.0:
    resolution: {integrity: sha512-9v9kG0LvzrlcungtnJtpGNxY+fzECQKhK4EGJX2vByejiMX84MFNQw4UxPJl3bFbTMw+Dfs37XaIkCwTZfLh4g==}
    dependencies:
      boolbase: 1.0.0
      css-select: 5.1.0
      css-what: 6.1.0
      domelementtype: 2.3.0
      domhandler: 5.0.3
      domutils: 3.1.0

  /cheerio@1.0.0:
    resolution: {integrity: sha512-quS9HgjQpdaXOvsZz82Oz7uxtXiy6UIsIQcpBj7HRw2M63Skasm9qlDocAM7jNuaxdhpPU7c4kJN+gA5MCu4ww==}
    engines: {node: '>=18.17'}
    dependencies:
      cheerio-select: 2.1.0
      dom-serializer: 2.0.0
      domhandler: 5.0.3
      domutils: 3.1.0
      encoding-sniffer: 0.2.0
      htmlparser2: 9.1.0
      parse5: 7.1.2
      parse5-htmlparser2-tree-adapter: 7.0.0
      parse5-parser-stream: 7.1.2
      undici: 6.19.8
      whatwg-mimetype: 4.0.0

  /chokidar@3.6.0:
    resolution: {integrity: sha512-7VT13fmjotKpGipCW9JEQAusEPE+Ei8nl6/g4FBAmIm0GOOLMua9NDDo/DWp0ZAxCr3cPq5ZpBqmPAQgDda2Pw==}
    engines: {node: '>= 8.10.0'}
    dependencies:
      anymatch: 3.1.3
      braces: 3.0.3
      glob-parent: 5.1.2
      is-binary-path: 2.1.0
      is-glob: 4.0.3
      normalize-path: 3.0.0
      readdirp: 3.6.0
    optionalDependencies:
      fsevents: 2.3.3

  /chokidar@4.0.1:
    resolution: {integrity: sha512-n8enUVCED/KVRQlab1hr3MVpcVMvxtZjmEa956u+4YijlmQED223XMSYj2tLuKvr4jcCTzNNMpQDUer72MMmzA==}
    engines: {node: '>= 14.16.0'}
    dependencies:
      readdirp: 4.0.1
    dev: true

  /cli-cursor@5.0.0:
    resolution: {integrity: sha512-aCj4O5wKyszjMmDT4tZj93kxyydN/K5zPWSCe6/0AV/AA1pqe5ZBIw0a2ZfPQV7lL5/yb5HsUreJ6UFAF1tEQw==}
    engines: {node: '>=18'}
    dependencies:
      restore-cursor: 5.1.0

  /cli-spinners@2.9.2:
    resolution: {integrity: sha512-ywqV+5MmyL4E7ybXgKys4DugZbX0FC6LnwrhjuykIjnK9k8OQacQ7axGKnjDXWNhns0xot3bZI5h55H8yo9cJg==}
    engines: {node: '>=6'}

  /cliui@6.0.0:
    resolution: {integrity: sha512-t6wbgtoCXvAzst7QgXxJYqPt0usEfbgQdftEPbLL/cvv6HPE5VgvqCuAIDR0NgU52ds6rFwqrgakNLrHEjCbrQ==}
    dependencies:
      string-width: 4.2.3
      strip-ansi: 6.0.1
      wrap-ansi: 6.2.0
    dev: true

  /color-convert@2.0.1:
    resolution: {integrity: sha512-RRECPsj7iu/xb5oKYcsFHSppFNnsj/52OVTRKb4zP5onXwVF3zVmmToNcOfGC+CRDpfK/U584fMg38ZHCaElKQ==}
    engines: {node: '>=7.0.0'}
    dependencies:
      color-name: 1.1.4
    dev: true

  /color-name@1.1.4:
    resolution: {integrity: sha512-dOy+3AuW3a2wNbZHIuMZpTcgjGuLU/uBL/ubcZF9OXbDo8ff4O8yVp5Bf0efS8uEoYo5q4Fx7dY9OgQGXgAsQA==}
    dev: true

  /colorjs.io@0.5.2:
    resolution: {integrity: sha512-twmVoizEW7ylZSN32OgKdXRmo1qg+wT5/6C3xu5b9QsWzSFAhHLn2xd8ro0diCsKfCj1RdaTP/nrcW+vAoQPIw==}

  /comma-separated-tokens@2.0.3:
    resolution: {integrity: sha512-Fu4hJdvzeylCfQPp9SGWidpzrMs7tTrlu6Vb8XGaRGck8QSNZJJp538Wrb60Lax4fPwR64ViY468OIUTbRlGZg==}
    dev: true

  /connect-history-api-fallback@2.0.0:
    resolution: {integrity: sha512-U73+6lQFmfiNPrYbXqr6kZ1i1wiRqXnp2nhMsINseWXO8lDau0LGEffJ8kQi4EjLZympVgRdvqjAgiZ1tgzDDA==}
    engines: {node: '>=0.8'}

  /create-codepen@2.0.0:
    resolution: {integrity: sha512-ehJ0Zw5RSV2G4+/azUb7vEZWRSA/K9cW7HDock1Y9ViDexkgSJUZJRcObdw/YAWeXKjreEQV9l/igNSsJ1yw5A==}
    engines: {node: '>=18'}
    dev: true

  /cross-spawn@7.0.3:
    resolution: {integrity: sha512-iRDPJKUPVEND7dHPO8rkbOnPpyDygcDFtWjpeWNCgy8WP2rXcxXL8TskReQl6OrB2G7+UJrags1q15Fudc7G6w==}
    engines: {node: '>= 8'}
    dependencies:
      path-key: 3.1.1
      shebang-command: 2.0.0
      which: 2.0.2
    dev: true

  /css-select@5.1.0:
    resolution: {integrity: sha512-nwoRF1rvRRnnCqqY7updORDsuqKzqYJ28+oSMaJMMgOauh3fvwHqMS7EZpIPqK8GL+g9mKxF1vP/ZjSeNjEVHg==}
    dependencies:
      boolbase: 1.0.0
      css-what: 6.1.0
      domhandler: 5.0.3
      domutils: 3.1.0
      nth-check: 2.1.1

  /css-what@6.1.0:
    resolution: {integrity: sha512-HTUrgRJ7r4dsZKU6GjmpfRK1O76h97Z8MfS1G0FozR+oF2kG6Vfe8JE6zwrkbxigziPHinCJ+gCPjA9EaBDtRw==}
    engines: {node: '>= 6'}

  /csstype@3.1.3:
    resolution: {integrity: sha512-M1uQkMl8rQK/szD0LNhtqxIPLpimGm8sOBwU7lLnCpSbTyY3yeU1Vc7l4KT5zT4s/yOxHH5O7tIuuLOCnLADRw==}

  /dayjs@1.11.13:
    resolution: {integrity: sha512-oaMBel6gjolK862uaPQOVTA7q3TZhuSvuMQAAglQDOWYO9A91IrAOUJEyKVlqJlHE0vq5p5UXxzdPfMH/x6xNg==}
    dev: true

  /debug@4.3.7:
    resolution: {integrity: sha512-Er2nc/H7RrMXZBFCEim6TCmMk02Z8vLC2Rbi1KEBggpo0fS6l0S1nnapwmIi3yW/+GOJap1Krg4w0Hg80oCqgQ==}
    engines: {node: '>=6.0'}
    peerDependencies:
      supports-color: '*'
    peerDependenciesMeta:
      supports-color:
        optional: true
    dependencies:
      ms: 2.1.3

  /decamelize@1.2.0:
    resolution: {integrity: sha512-z2S+W9X73hAUUki+N+9Za2lBlun89zigOyGrsax+KUQ6wKW4ZoWpEYBkGhQjwAjjDCkWxhY0VKEhk8wzY7F5cA==}
    engines: {node: '>=0.10.0'}
    dev: true

  /dequal@2.0.3:
    resolution: {integrity: sha512-0je+qPKHEMohvfRTCEo3CrPG6cAzAYgmzKyxRiYSSDkS6eGJdyVJm7WaYA5ECaAD9wLB2T4EEeymA5aFVcYXCA==}
    engines: {node: '>=6'}
    dev: true

  /devlop@1.1.0:
    resolution: {integrity: sha512-RWmIqhcFf1lRYBvNmr7qTNuyCt/7/ns2jbpp1+PalgE/rDQcBT0fioSMUpJ93irlUhC5hrg4cYqe6U+0ImW0rA==}
    dependencies:
      dequal: 2.0.3
    dev: true

  /dijkstrajs@1.0.3:
    resolution: {integrity: sha512-qiSlmBq9+BCdCA/L46dw8Uy93mloxsPSbwnm5yrKn2vMPiy8KyAskTF6zuV/j5BMsmOGZDPs7KjU+mjb670kfA==}
    dev: true

  /dom-serializer@2.0.0:
    resolution: {integrity: sha512-wIkAryiqt/nV5EQKqQpo3SToSOV9J0DnbJqwK7Wv/Trc92zIAYZ4FlMu+JPFW1DfGFt81ZTCGgDEabffXeLyJg==}
    dependencies:
      domelementtype: 2.3.0
      domhandler: 5.0.3
      entities: 4.5.0

  /domelementtype@2.3.0:
    resolution: {integrity: sha512-OLETBj6w0OsagBwdXnPdN0cnMfF9opN69co+7ZrbfPGrdpPVNBUj02spi6B1N7wChLQiPn4CSH/zJvXw56gmHw==}

  /domhandler@5.0.3:
    resolution: {integrity: sha512-cgwlv/1iFQiFnU96XXgROh8xTeetsnJiDsTc7TYCLFd9+/WNkIqPTxiM/8pSd8VIrhXGTf1Ny1q1hquVqDJB5w==}
    engines: {node: '>= 4'}
    dependencies:
      domelementtype: 2.3.0

  /domutils@3.1.0:
    resolution: {integrity: sha512-H78uMmQtI2AhgDJjWeQmHwJJ2bLPD3GMmO7Zja/ZZh84wkm+4ut+IUnUdRa8uCGX88DiVx1j6FRe1XfxEgjEZA==}
    dependencies:
      dom-serializer: 2.0.0
      domelementtype: 2.3.0
      domhandler: 5.0.3

  /electron-to-chromium@1.5.27:
    resolution: {integrity: sha512-o37j1vZqCoEgBuWWXLHQgTN/KDKe7zwpiY5CPeq2RvUqOyJw9xnrULzZAEVQ5p4h+zjMk7hgtOoPdnLxr7m/jw==}

  /emoji-regex@10.4.0:
    resolution: {integrity: sha512-EC+0oUMY1Rqm4O6LLrgjtYDvcVYTy7chDnM4Q7030tP4Kwj3u/pR6gP9ygnp2CJMK5Gq+9Q2oqmrFJAz01DXjw==}

  /emoji-regex@8.0.0:
    resolution: {integrity: sha512-MSjYzcWNOA0ewAHpz0MxpYFvwg6yjy1NG3xteoqz644VCo/RPgnr1/GGt+ic3iJTzQ8Eu3TdM14SawnVUmGE6A==}
    dev: true

  /encoding-sniffer@0.2.0:
    resolution: {integrity: sha512-ju7Wq1kg04I3HtiYIOrUrdfdDvkyO9s5XM8QAj/bN61Yo/Vb4vgJxy5vi4Yxk01gWHbrofpPtpxM8bKger9jhg==}
    dependencies:
      iconv-lite: 0.6.3
      whatwg-encoding: 3.1.1

  /entities@4.5.0:
    resolution: {integrity: sha512-V0hjH4dGPh9Ao5p0MoRY6BVqtwCjhz6vI5LT8AJ55H+4g9/4vbHx1I54fS0XuclLhDHArPQCiMjDxjaL8fPxhw==}
    engines: {node: '>=0.12'}

  /envinfo@7.14.0:
    resolution: {integrity: sha512-CO40UI41xDQzhLB1hWyqUKgFhs250pNcGbyGKe1l/e4FSaI/+YE4IMG76GDt0In67WLPACIITC+sOi08x4wIvg==}
    engines: {node: '>=4'}
    hasBin: true

  /esbuild@0.21.5:
    resolution: {integrity: sha512-mg3OPMV4hXywwpoDxu3Qda5xCKQi+vCTZq8S9J/EpkhB2HzKXq4SNFZE3+NK93JYxc8VMSep+lOUSC/RVKaBqw==}
    engines: {node: '>=12'}
    hasBin: true
    requiresBuild: true
    optionalDependencies:
      '@esbuild/aix-ppc64': 0.21.5
      '@esbuild/android-arm': 0.21.5
      '@esbuild/android-arm64': 0.21.5
      '@esbuild/android-x64': 0.21.5
      '@esbuild/darwin-arm64': 0.21.5
      '@esbuild/darwin-x64': 0.21.5
      '@esbuild/freebsd-arm64': 0.21.5
      '@esbuild/freebsd-x64': 0.21.5
      '@esbuild/linux-arm': 0.21.5
      '@esbuild/linux-arm64': 0.21.5
      '@esbuild/linux-ia32': 0.21.5
      '@esbuild/linux-loong64': 0.21.5
      '@esbuild/linux-mips64el': 0.21.5
      '@esbuild/linux-ppc64': 0.21.5
      '@esbuild/linux-riscv64': 0.21.5
      '@esbuild/linux-s390x': 0.21.5
      '@esbuild/linux-x64': 0.21.5
      '@esbuild/netbsd-x64': 0.21.5
      '@esbuild/openbsd-x64': 0.21.5
      '@esbuild/sunos-x64': 0.21.5
      '@esbuild/win32-arm64': 0.21.5
      '@esbuild/win32-ia32': 0.21.5
      '@esbuild/win32-x64': 0.21.5

  /escalade@3.2.0:
    resolution: {integrity: sha512-WUj2qlxaQtO4g6Pq5c29GTcWGDyd8itL8zTlipgECz3JesAiiOKotd8JU6otB3PACgG6xkJUyVhboMS+bje/jA==}
    engines: {node: '>=6'}

  /esprima@4.0.1:
    resolution: {integrity: sha512-eGuFFw7Upda+g4p+QHvnW0RyTX/SVeJBDM/gCtMARO0cLuT2HcEKnTPvhjV6aGeqrCB/sbNop0Kszm0jsaWU4A==}
    engines: {node: '>=4'}
    hasBin: true

  /estree-walker@2.0.2:
    resolution: {integrity: sha512-Rfkk/Mp/DL7JVje3u18FxFujQlTNR2q6QfMSMB7AvCBx91NGj/ba3kCfza0f6dVDbw7YlRf/nDrn7pQrCCyQ/w==}

  /execa@9.4.0:
    resolution: {integrity: sha512-yKHlle2YGxZE842MERVIplWwNH5VYmqqcPFgtnlU//K8gxuFFXu0pwd/CrfXTumFpeEiufsP7+opT/bPJa1yVw==}
    engines: {node: ^18.19.0 || >=20.5.0}
    dependencies:
      '@sindresorhus/merge-streams': 4.0.0
      cross-spawn: 7.0.3
      figures: 6.1.0
      get-stream: 9.0.1
      human-signals: 8.0.0
      is-plain-obj: 4.1.0
      is-stream: 4.0.1
      npm-run-path: 6.0.0
      pretty-ms: 9.1.0
      signal-exit: 4.1.0
      strip-final-newline: 4.0.0
      yoctocolors: 2.1.1
    dev: true

  /extend-shallow@2.0.1:
    resolution: {integrity: sha512-zCnTtlxNoAiDc3gqY2aYAWFx7XWWiasuF2K8Me5WbN8otHKTUKBwjPtNpRs/rbUZm7KxWAaNj7P1a/p52GbVug==}
    engines: {node: '>=0.10.0'}
    dependencies:
      is-extendable: 0.1.1

  /fast-glob@3.3.2:
    resolution: {integrity: sha512-oX2ruAFQwf/Orj8m737Y5adxDQO0LAB7/S5MnxCdTNDd4p6BsyIVsv9JQsATbTSq8KHRpLwIHbVlUNatxd+1Ow==}
    engines: {node: '>=8.6.0'}
    dependencies:
      '@nodelib/fs.stat': 2.0.5
      '@nodelib/fs.walk': 1.2.8
      glob-parent: 5.1.2
      merge2: 1.4.1
      micromatch: 4.0.8

  /fastq@1.17.1:
    resolution: {integrity: sha512-sRVD3lWVIXWg6By68ZN7vho9a1pQcN/WBFaAAsDDFzlJjvoGx0P8z7V1t72grFJfJhu3YPZBuu25f7Kaw2jN1w==}
    dependencies:
      reusify: 1.0.4

  /fflate@0.8.2:
    resolution: {integrity: sha512-cPJU47OaAoCbg0pBvzsgpTPhmhqI5eJjh/JIu8tPj5q+T7iLvW/JAYUqmE7KOB4R1ZyEhzBaIQpQpardBF5z8A==}

  /figures@6.1.0:
    resolution: {integrity: sha512-d+l3qxjSesT4V7v2fh+QnmFnUWv9lSpjarhShNTgBOfA0ttejbQUAlHLitbjkoRiDulW0OPoQPYIGhIC8ohejg==}
    engines: {node: '>=18'}
    dependencies:
      is-unicode-supported: 2.1.0
    dev: true

  /fill-range@7.1.1:
    resolution: {integrity: sha512-YsGpe3WHLK8ZYi4tWDg2Jy3ebRz2rXowDxnld4bkQB00cc/1Zw9AWnC0i9ztDJitivtQvaI9KaLyKrc+hBW0yg==}
    engines: {node: '>=8'}
    dependencies:
      to-regex-range: 5.0.1

  /find-up@4.1.0:
    resolution: {integrity: sha512-PpOwAdQ/YlXQ2vj8a3h8IipDuYRi3wceVQQGYWxNINccq40Anw7BlsEXCMbt1Zt+OLA6Fq9suIpIWD0OsnISlw==}
    engines: {node: '>=8'}
    dependencies:
      locate-path: 5.0.0
      path-exists: 4.0.0
    dev: true

  /fraction.js@4.3.7:
    resolution: {integrity: sha512-ZsDfxO51wGAXREY55a7la9LScWpwv9RxIrYABrlvOFBlH/ShPnrtsXeuUIfXKKOVicNxQ+o8JTbJvjS4M89yew==}

  /fs-extra@11.2.0:
    resolution: {integrity: sha512-PmDi3uwK5nFuXh7XDTlVnS17xJS7vW36is2+w3xcv8SVxiB4NyATf4ctkVY5bkSjX0Y4nbvZCq1/EjtEyr9ktw==}
    engines: {node: '>=14.14'}
    dependencies:
      graceful-fs: 4.2.11
      jsonfile: 6.1.0
      universalify: 2.0.1

  /fsevents@2.3.3:
    resolution: {integrity: sha512-5xoDfX+fL7faATnagmWPpbFtwh/R77WmMMqqHGS65C3vvB0YHrgF+B1YmZ3441tMj5n63k0212XNoJwzlhffQw==}
    engines: {node: ^8.16.0 || ^10.6.0 || >=11.0.0}
    os: [darwin]
    requiresBuild: true
    optional: true

  /get-caller-file@2.0.5:
    resolution: {integrity: sha512-DyFP3BM/3YHTQOCUL/w0OZHR0lpKeGrxotcHWcqNEdnltqFwXVfhEBQ94eIo34AfQpo0rGki4cyIiftY06h2Fg==}
    engines: {node: 6.* || 8.* || >= 10.*}
    dev: true

  /get-east-asian-width@1.2.0:
    resolution: {integrity: sha512-2nk+7SIVb14QrgXFHcm84tD4bKQz0RxPuMT8Ag5KPOq7J5fEmAg0UbXdTOSHqNuHSU28k55qnceesxXRZGzKWA==}
    engines: {node: '>=18'}

  /get-stream@9.0.1:
    resolution: {integrity: sha512-kVCxPF3vQM/N0B1PmoqVUqgHP+EeVjmZSQn+1oCRPxd2P21P2F19lIgbR3HBosbB1PUhOAoctJnfEn2GbN2eZA==}
    engines: {node: '>=18'}
    dependencies:
      '@sec-ant/readable-stream': 0.4.1
      is-stream: 4.0.1
    dev: true

  /giscus@1.5.0:
    resolution: {integrity: sha512-t3LL0qbSO3JXq3uyQeKpF5CegstGfKX/0gI6eDe1cmnI7D56R7j52yLdzw4pdKrg3VnufwCgCM3FDz7G1Qr6lg==}
    dependencies:
      lit: 3.2.0
    dev: true

  /glob-parent@5.1.2:
    resolution: {integrity: sha512-AOIgSQCepiJYwP3ARnGx+5VnTu2HBYdzbGP45eLw1vr3zB3vZLeyed1sC9hnbcOc9/SrMyM5RPQrkGz4aS9Zow==}
    engines: {node: '>= 6'}
    dependencies:
      is-glob: 4.0.3

  /globby@14.0.2:
    resolution: {integrity: sha512-s3Fq41ZVh7vbbe2PN3nrW7yC7U7MFVc5c98/iTl9c2GawNMKx/J648KQRW6WKkuU8GIbbh2IXfIRQjOZnXcTnw==}
    engines: {node: '>=18'}
    dependencies:
      '@sindresorhus/merge-streams': 2.3.0
      fast-glob: 3.3.2
      ignore: 5.3.2
      path-type: 5.0.0
      slash: 5.1.0
      unicorn-magic: 0.1.0

  /graceful-fs@4.2.11:
    resolution: {integrity: sha512-RbJ5/jmFcNNCcDV5o9eTnBLJ/HszWV0P73bc+Ff4nS/rJj+YaS6IGyiOL0VoBYX+l1Wrl3k63h/KrH+nhJ0XvQ==}

  /gray-matter@4.0.3:
    resolution: {integrity: sha512-5v6yZd4JK3eMI3FqqCouswVqwugaA9r4dNZB1wwcmrD02QkV5H0y7XBQW8QwQqEaZY1pM9aqORSORhJRdNK44Q==}
    engines: {node: '>=6.0'}
    dependencies:
      js-yaml: 3.14.1
      kind-of: 6.0.3
      section-matter: 1.0.0
      strip-bom-string: 1.0.0

  /has-flag@4.0.0:
    resolution: {integrity: sha512-EykJT/Q1KjTWctppgIAgfSO0tKVuZUjhgMr17kqTumMl6Afv3EISleU7qZUzoXDFTAHTDC4NOoG/ZxU3EvlMPQ==}
    engines: {node: '>=8'}

  /hash-sum@2.0.0:
    resolution: {integrity: sha512-WdZTbAByD+pHfl/g9QSsBIIwy8IT+EsPiKDs0KNX+zSHhdDLFKdZu0BQHljvO+0QI/BasbMSUa8wYNCZTvhslg==}

  /hast-util-to-html@9.0.3:
    resolution: {integrity: sha512-M17uBDzMJ9RPCqLMO92gNNUDuBSq10a25SDBI08iCCxmorf4Yy6sYHK57n9WAbRAAaU+DuR4W6GN9K4DFZesYg==}
    dependencies:
      '@types/hast': 3.0.4
      '@types/unist': 3.0.3
      ccount: 2.0.1
      comma-separated-tokens: 2.0.3
      hast-util-whitespace: 3.0.0
      html-void-elements: 3.0.0
      mdast-util-to-hast: 13.2.0
      property-information: 6.5.0
      space-separated-tokens: 2.0.2
      stringify-entities: 4.0.4
      zwitch: 2.0.4
    dev: true

  /hast-util-whitespace@3.0.0:
    resolution: {integrity: sha512-88JUN06ipLwsnv+dVn+OIYOvAuvBMy/Qoi6O7mQHxdPXpjy+Cd6xRkWwux7DKO+4sYILtLBRIKgsdpS2gQc7qw==}
    dependencies:
      '@types/hast': 3.0.4
    dev: true

  /html-void-elements@3.0.0:
    resolution: {integrity: sha512-bEqo66MRXsUGxWHV5IP0PUiAWwoEjba4VCzg0LjFJBpchPaTfyfCKTG6bc5F8ucKec3q5y6qOdGyYTSBEvhCrg==}
    dev: true

  /htmlparser2@9.1.0:
    resolution: {integrity: sha512-5zfg6mHUoaer/97TxnGpxmbR7zJtPwIYFMZ/H5ucTlPZhKvtum05yiPK3Mgai3a0DyVxv7qYqoweaEd2nrYQzQ==}
    dependencies:
      domelementtype: 2.3.0
      domhandler: 5.0.3
      domutils: 3.1.0
      entities: 4.5.0

  /human-signals@8.0.0:
    resolution: {integrity: sha512-/1/GPCpDUCCYwlERiYjxoczfP0zfvZMU/OWgQPMya9AbAE24vseigFdhAMObpc8Q4lc/kjutPfUddDYyAmejnA==}
    engines: {node: '>=18.18.0'}
    dev: true

  /iconv-lite@0.6.3:
    resolution: {integrity: sha512-4fCk79wshMdzMp2rH06qWrJE4iolqLhCUH+OiuIgU++RB0+94NlDL81atO7GX55uUKueo0txHNtvEyI6D7WdMw==}
    engines: {node: '>=0.10.0'}
    dependencies:
      safer-buffer: 2.1.2

  /ignore@5.3.2:
    resolution: {integrity: sha512-hsBTNUqQTDwkWtcdYI2i06Y/nUBEsNEDJKjWdigLvegy8kDuJAS8uRlpkkcQpyEXL0Z/pjDy5HBmMjRCJ2gq+g==}
    engines: {node: '>= 4'}

  /immutable@4.3.7:
    resolution: {integrity: sha512-1hqclzwYwjRDFLjcFxOM5AYkkG0rpFPpr1RLPMEuGczoS7YA8gLhy8SWXYRAA/XwfEHpfo3cw5JGioS32fnMRw==}

  /is-binary-path@2.1.0:
    resolution: {integrity: sha512-ZMERYes6pDydyuGidse7OsHxtbI7WVeUEozgR/g7rd0xUimYNlvZRE/K2MgZTjWy725IfelLeVcEM97mmtRGXw==}
    engines: {node: '>=8'}
    dependencies:
      binary-extensions: 2.3.0

  /is-extendable@0.1.1:
    resolution: {integrity: sha512-5BMULNob1vgFX6EjQw5izWDxrecWK9AM72rugNr0TFldMOi0fj6Jk+zeKIt0xGj4cEfQIJth4w3OKWOJ4f+AFw==}
    engines: {node: '>=0.10.0'}

  /is-extglob@2.1.1:
    resolution: {integrity: sha512-SbKbANkN603Vi4jEZv49LeVJMn4yGwsbzZworEoyEiutsN3nJYdbO36zfhGJ6QEDpOZIFkDtnq5JRxmvl3jsoQ==}
    engines: {node: '>=0.10.0'}

  /is-fullwidth-code-point@3.0.0:
    resolution: {integrity: sha512-zymm5+u+sCsSWyD9qNaejV3DFvhCKclKdizYaJUuHA83RLjb7nSuGnddCHGv0hk+KY7BMAlsWeK4Ueg6EV6XQg==}
    engines: {node: '>=8'}
    dev: true

  /is-glob@4.0.3:
    resolution: {integrity: sha512-xelSayHH36ZgE7ZWhli7pW34hNbNl8Ojv5KVmkJD4hBdD3th8Tfk9vYasLM+mXWOZhFkgZfxhLSnrwRr4elSSg==}
    engines: {node: '>=0.10.0'}
    dependencies:
      is-extglob: 2.1.1

  /is-interactive@2.0.0:
    resolution: {integrity: sha512-qP1vozQRI+BMOPcjFzrjXuQvdak2pHNUMZoeG2eRbiSqyvbEf/wQtEOTOX1guk6E3t36RkaqiSt8A/6YElNxLQ==}
    engines: {node: '>=12'}

  /is-number@7.0.0:
    resolution: {integrity: sha512-41Cifkg6e8TylSpdtTpeLVMqvSBEVzTttHvERD741+pnZ8ANv0004MRL43QKPDlK9cGvNp6NZWZUBlbGXYxxng==}
    engines: {node: '>=0.12.0'}

  /is-plain-obj@4.1.0:
    resolution: {integrity: sha512-+Pgi+vMuUNkJyExiMBt5IlFoMyKnr5zhJ4Uspz58WOhBF5QoIZkFyNHIbBAtHwzVAgk5RtndVNsDRN61/mmDqg==}
    engines: {node: '>=12'}
    dev: true

  /is-stream@4.0.1:
    resolution: {integrity: sha512-Dnz92NInDqYckGEUJv689RbRiTSEHCQ7wOVeALbkOz999YpqT46yMRIGtSNl2iCL1waAZSx40+h59NV/EwzV/A==}
    engines: {node: '>=18'}
    dev: true

  /is-unicode-supported@1.3.0:
    resolution: {integrity: sha512-43r2mRvz+8JRIKnWJ+3j8JtjRKZ6GmjzfaE/qiBJnikNnYv/6bagRJ1kUhNk8R5EX/GkobD+r+sfxCPJsiKBLQ==}
    engines: {node: '>=12'}

  /is-unicode-supported@2.1.0:
    resolution: {integrity: sha512-mE00Gnza5EEB3Ds0HfMyllZzbBrmLOX3vfWoj9A9PEnTfratQ/BcaJOuMhnkhjXvb2+FkY3VuHqtAGpTPmglFQ==}
    engines: {node: '>=18'}

  /isexe@2.0.0:
    resolution: {integrity: sha512-RHxMLp9lnKHGHRng9QFhRCMbYAcVpn69smSGcq3f36xjgVVWThj4qqLbTLlq7Ssj8B+fIQ1EuCEGI2lKsyQeIw==}
    dev: true

  /js-yaml@3.14.1:
    resolution: {integrity: sha512-okMH7OXXJ7YrN9Ok3/SXrnu4iX9yOk+25nqX4imS2npuvTYDmo/QEZoqwZkYaIDk3jVvBOTOIEgEhaLOynBS9g==}
    hasBin: true
    dependencies:
      argparse: 1.0.10
      esprima: 4.0.1

  /js-yaml@4.1.0:
    resolution: {integrity: sha512-wpxZs9NoxZaJESJGIZTyDEaYpl0FKSA+FB9aJiyemKhMwkxQg63h4T1KJgUGHpTqPDNRcmmYLugrRjJlBtWvRA==}
    hasBin: true
    dependencies:
      argparse: 2.0.1
    dev: true

  /jsonfile@6.1.0:
    resolution: {integrity: sha512-5dgndWOriYSm5cnYaJNhalLNDKOqFwyDB/rr1E9ZsGciGvKPs8R2xYGCacuf3z6K1YKDz182fd+fY3cn3pMqXQ==}
    dependencies:
      universalify: 2.0.1
    optionalDependencies:
      graceful-fs: 4.2.11

  /kind-of@6.0.3:
    resolution: {integrity: sha512-dcS1ul+9tmeD95T+x28/ehLgd9mENa3LsvDTtzm3vyBEO7RPptvAD+t44WVXaUjTBRcrpFeFlC8WCruUR456hw==}
    engines: {node: '>=0.10.0'}

  /lilconfig@3.1.2:
    resolution: {integrity: sha512-eop+wDAvpItUys0FWkHIKeC9ybYrTGbU41U5K7+bttZZeohvnY7M9dZ5kB21GNWiFT2q1OoPTvncPCgSOVO5ow==}
    engines: {node: '>=14'}

  /linkify-it@5.0.0:
    resolution: {integrity: sha512-5aHCbzQRADcdP+ATqnDuhhJ/MRIqDkZX5pyjFHRRysS8vZ5AbqGEoFIb6pYHPZ+L/OC2Lc+xT8uHVVR5CAK/wQ==}
    dependencies:
      uc.micro: 2.1.0

  /lit-element@4.1.0:
    resolution: {integrity: sha512-gSejRUQJuMQjV2Z59KAS/D4iElUhwKpIyJvZ9w+DIagIQjfJnhR20h2Q5ddpzXGS+fF0tMZ/xEYGMnKmaI/iww==}
    dependencies:
      '@lit-labs/ssr-dom-shim': 1.2.1
      '@lit/reactive-element': 2.0.4
      lit-html: 3.2.0
    dev: true

  /lit-html@3.2.0:
    resolution: {integrity: sha512-pwT/HwoxqI9FggTrYVarkBKFN9MlTUpLrDHubTmW4SrkL3kkqW5gxwbxMMUnbbRHBC0WTZnYHcjDSCM559VyfA==}
    dependencies:
      '@types/trusted-types': 2.0.7
    dev: true

  /lit@3.2.0:
    resolution: {integrity: sha512-s6tI33Lf6VpDu7u4YqsSX78D28bYQulM+VAzsGch4fx2H0eLZnJsUBsPWmGYSGoKDNbjtRv02rio1o+UdPVwvw==}
    dependencies:
      '@lit/reactive-element': 2.0.4
      lit-element: 4.1.0
      lit-html: 3.2.0
    dev: true

  /locate-path@5.0.0:
    resolution: {integrity: sha512-t7hw9pI+WvuwNJXwk5zVHpyhIqzg2qTlklJOf0mVxGSbe3Fp2VieZcduNYjaLDoy6p9uGpQEGWG87WpMKlNq8g==}
    engines: {node: '>=8'}
    dependencies:
      p-locate: 4.1.0
    dev: true

  /log-symbols@6.0.0:
    resolution: {integrity: sha512-i24m8rpwhmPIS4zscNzK6MSEhk0DUWa/8iYQWxhffV8jkI4Phvs3F+quL5xvS0gdQR0FyTCMMH33Y78dDTzzIw==}
    engines: {node: '>=18'}
    dependencies:
      chalk: 5.3.0
      is-unicode-supported: 1.3.0

  /magic-string@0.30.11:
    resolution: {integrity: sha512-+Wri9p0QHMy+545hKww7YAu5NyzF8iomPL/RQazugQ9+Ez4Ic3mERMd8ZTX5rfK944j+560ZJi8iAwgak1Ac7A==}
    dependencies:
      '@jridgewell/sourcemap-codec': 1.5.0

  /markdown-it-anchor@9.2.0(@types/markdown-it@14.1.2)(markdown-it@14.1.0):
    resolution: {integrity: sha512-sa2ErMQ6kKOA4l31gLGYliFQrMKkqSO0ZJgGhDHKijPf0pNFM9vghjAh3gn26pS4JDRs7Iwa9S36gxm3vgZTzg==}
    peerDependencies:
      '@types/markdown-it': '*'
      markdown-it: '*'
    dependencies:
      '@types/markdown-it': 14.1.2
      markdown-it: 14.1.0

  /markdown-it-emoji@3.0.0:
    resolution: {integrity: sha512-+rUD93bXHubA4arpEZO3q80so0qgoFJEKRkRbjKX8RTdca89v2kfyF+xR3i2sQTwql9tpPZPOQN5B+PunspXRg==}

  /markdown-it@14.1.0:
    resolution: {integrity: sha512-a54IwgWPaeBCAAsv13YgmALOF1elABB08FxO9i+r4VFk5Vl4pKokRPeX8u5TCgSsPi6ec1otfLjdOpVcgbpshg==}
    hasBin: true
    dependencies:
      argparse: 2.0.1
      entities: 4.5.0
      linkify-it: 5.0.0
      mdurl: 2.0.0
      punycode.js: 2.3.1
      uc.micro: 2.1.0

  /mdast-util-to-hast@13.2.0:
    resolution: {integrity: sha512-QGYKEuUsYT9ykKBCMOEDLsU5JRObWQusAolFMeko/tYPufNkRffBAQjIE+99jbA87xv6FgmjLtwjh9wBWajwAA==}
    dependencies:
      '@types/hast': 3.0.4
      '@types/mdast': 4.0.4
      '@ungap/structured-clone': 1.2.0
      devlop: 1.1.0
      micromark-util-sanitize-uri: 2.0.0
      trim-lines: 3.0.1
      unist-util-position: 5.0.0
      unist-util-visit: 5.0.0
      vfile: 6.0.3
    dev: true

  /mdurl@2.0.0:
    resolution: {integrity: sha512-Lf+9+2r+Tdp5wXDXC4PcIBjTDtq4UKjCPMQhKIuzpJNW0b96kVqSwW0bT7FhRSfmAiFYgP+SCRvdrDozfh0U5w==}

  /merge2@1.4.1:
    resolution: {integrity: sha512-8q7VEgMJW4J8tcfVPy8g09NcQwZdbwFEqhe/WZkoIzjn/3TGDwtOCYtXGxA3O8tPzpczCCDgv+P2P5y00ZJOOg==}
    engines: {node: '>= 8'}

  /micromark-util-character@2.1.0:
    resolution: {integrity: sha512-KvOVV+X1yLBfs9dCBSopq/+G1PcgT3lAK07mC4BzXi5E7ahzMAF8oIupDDJ6mievI6F+lAATkbQQlQixJfT3aQ==}
    dependencies:
      micromark-util-symbol: 2.0.0
      micromark-util-types: 2.0.0
    dev: true

  /micromark-util-encode@2.0.0:
    resolution: {integrity: sha512-pS+ROfCXAGLWCOc8egcBvT0kf27GoWMqtdarNfDcjb6YLuV5cM3ioG45Ys2qOVqeqSbjaKg72vU+Wby3eddPsA==}
    dev: true

  /micromark-util-sanitize-uri@2.0.0:
    resolution: {integrity: sha512-WhYv5UEcZrbAtlsnPuChHUAsu/iBPOVaEVsntLBIdpibO0ddy8OzavZz3iL2xVvBZOpolujSliP65Kq0/7KIYw==}
    dependencies:
      micromark-util-character: 2.1.0
      micromark-util-encode: 2.0.0
      micromark-util-symbol: 2.0.0
    dev: true

  /micromark-util-symbol@2.0.0:
    resolution: {integrity: sha512-8JZt9ElZ5kyTnO94muPxIGS8oyElRJaiJO8EzV6ZSyGQ1Is8xwl4Q45qU5UOg+bGH4AikWziz0iN4sFLWs8PGw==}
    dev: true

  /micromark-util-types@2.0.0:
    resolution: {integrity: sha512-oNh6S2WMHWRZrmutsRmDDfkzKtxF+bc2VxLC9dvtrDIRFln627VsFP6fLMgTryGDljgLPjkrzQSDcPrjPyDJ5w==}
    dev: true

  /micromatch@4.0.8:
    resolution: {integrity: sha512-PXwfBhYu0hBCPw8Dn0E+WDYb7af3dSLVWKi3HGv84IdF4TyFoC0ysxFd0Goxw7nSv4T/PzEJQxsYsEiFCKo2BA==}
    engines: {node: '>=8.6'}
    dependencies:
      braces: 3.0.3
      picomatch: 2.3.1

  /mimic-function@5.0.1:
    resolution: {integrity: sha512-VP79XUPxV2CigYP3jWwAUFSku2aKqBH7uTAapFWCBqutsbmDo96KY5o8uh6U+/YSIn5OxJnXp73beVkpqMIGhA==}
    engines: {node: '>=18'}

  /ms@2.1.3:
    resolution: {integrity: sha512-6FlzubTLZG3J2a/NVCAleEhjzq5oxgHyaCU9yYXvcLsvoVaHJq/s5xXI6/XXP6tz7R9xAOtHnSO/tXtF3WRTlA==}

  /nanoid@3.3.7:
    resolution: {integrity: sha512-eSRppjcPIatRIMC1U6UngP8XFcz8MQWGQdt1MTBQ7NaAmvXDfvNxbvWV3x2y6CdEUciCSsDHDQZbhYaB8QEo2g==}
    engines: {node: ^10 || ^12 || ^13.7 || ^14 || >=15.0.1}
    hasBin: true

  /nanoid@5.0.7:
    resolution: {integrity: sha512-oLxFY2gd2IqnjcYyOXD8XGCftpGtZP2AbHbOkthDkvRywH5ayNtPVy9YlOPcHckXzbLTCHpkb7FB+yuxKV13pQ==}
    engines: {node: ^18 || >=20}
    hasBin: true
    dev: true

  /node-releases@2.0.18:
    resolution: {integrity: sha512-d9VeXT4SJ7ZeOqGX6R5EM022wpL+eWPooLI+5UpWn2jCT1aosUQEhQP214x33Wkwx3JQMvIm+tIoVOdodFS40g==}

  /normalize-path@3.0.0:
    resolution: {integrity: sha512-6eZs5Ls3WtCisHWp9S2GUy8dqkpGi4BVSz3GaqiE6ezub0512ESztXUwUB6C6IKbQkY2Pnb/mD4WYojCRwcwLA==}
    engines: {node: '>=0.10.0'}

  /normalize-range@0.1.2:
    resolution: {integrity: sha512-bdok/XvKII3nUpklnV6P2hxtMNrCboOjAcyBuQnWEhO665FwrSNRxU+AqpsyvO6LgGYPspN+lu5CLtw4jPRKNA==}
    engines: {node: '>=0.10.0'}

  /npm-run-path@6.0.0:
    resolution: {integrity: sha512-9qny7Z9DsQU8Ou39ERsPU4OZQlSTP47ShQzuKZ6PRXpYLtIFgl/DEBYEXKlvcEa+9tHVcK8CF81Y2V72qaZhWA==}
    engines: {node: '>=18'}
    dependencies:
      path-key: 4.0.0
      unicorn-magic: 0.3.0
    dev: true

  /nth-check@2.1.1:
    resolution: {integrity: sha512-lqjrjmaOoAnWfMmBPL+XNnynZh2+swxiX3WUE0s4yEHI6m+AwrK2UZOimIRl3X/4QctVqS8AiZjFqyOGrMXb/w==}
    dependencies:
      boolbase: 1.0.0

  /onetime@7.0.0:
    resolution: {integrity: sha512-VXJjc87FScF88uafS3JllDgvAm+c/Slfz06lorj2uAY34rlUu0Nt+v8wreiImcrgAjjIHp1rXpTDlLOGw29WwQ==}
    engines: {node: '>=18'}
    dependencies:
      mimic-function: 5.0.1

  /oniguruma-to-js@0.4.3:
    resolution: {integrity: sha512-X0jWUcAlxORhOqqBREgPMgnshB7ZGYszBNspP+tS9hPD3l13CdaXcHbgImoHUHlrvGx/7AvFEkTRhAGYh+jzjQ==}
    dependencies:
      regex: 4.3.2
    dev: true

  /ora@8.1.0:
    resolution: {integrity: sha512-GQEkNkH/GHOhPFXcqZs3IDahXEQcQxsSjEkK4KvEEST4t7eNzoMjxTzef+EZ+JluDEV+Raoi3WQ2CflnRdSVnQ==}
    engines: {node: '>=18'}
    dependencies:
      chalk: 5.3.0
      cli-cursor: 5.0.0
      cli-spinners: 2.9.2
      is-interactive: 2.0.0
      is-unicode-supported: 2.1.0
      log-symbols: 6.0.0
      stdin-discarder: 0.2.2
      string-width: 7.2.0
      strip-ansi: 7.1.0

  /p-limit@2.3.0:
    resolution: {integrity: sha512-//88mFWSJx8lxCzwdAABTJL2MyWB12+eIY7MDL2SqLmAkeKU9qxRvWuSyTjm3FUmpBEMuFfckAIqEaVGUDxb6w==}
    engines: {node: '>=6'}
    dependencies:
      p-try: 2.2.0
    dev: true

  /p-locate@4.1.0:
    resolution: {integrity: sha512-R79ZZ/0wAxKGu3oYMlz8jy/kbhsNrS7SKZ7PxEHBgJ5+F2mtFW2fK2cOtBh1cHYkQsbzFV7I+EoRKe6Yt0oK7A==}
    engines: {node: '>=8'}
    dependencies:
      p-limit: 2.3.0
    dev: true

  /p-try@2.2.0:
    resolution: {integrity: sha512-R4nPAVTAU0B9D35/Gk3uJf/7XYbQcyohSKdvAxIRSNghFl4e71hVoGnBNQz9cWaXxO2I10KTC+3jMdvvoKw6dQ==}
    engines: {node: '>=6'}
    dev: true

  /parse-ms@4.0.0:
    resolution: {integrity: sha512-TXfryirbmq34y8QBwgqCVLi+8oA3oWx2eAnSn62ITyEhEYaWRlVZ2DvMM9eZbMs/RfxPu/PK/aBLyGj4IrqMHw==}
    engines: {node: '>=18'}
    dev: true

  /parse5-htmlparser2-tree-adapter@7.0.0:
    resolution: {integrity: sha512-B77tOZrqqfUfnVcOrUvfdLbz4pu4RopLD/4vmu3HUPswwTA8OH0EMW9BlWR2B0RCoiZRAHEUu7IxeP1Pd1UU+g==}
    dependencies:
      domhandler: 5.0.3
      parse5: 7.1.2

  /parse5-parser-stream@7.1.2:
    resolution: {integrity: sha512-JyeQc9iwFLn5TbvvqACIF/VXG6abODeB3Fwmv/TGdLk2LfbWkaySGY72at4+Ty7EkPZj854u4CrICqNk2qIbow==}
    dependencies:
      parse5: 7.1.2

  /parse5@7.1.2:
    resolution: {integrity: sha512-Czj1WaSVpaoj0wbhMzLmWD69anp2WH7FXMB9n1Sy8/ZFF9jolSQVMu1Ij5WIyGmcBmhk7EOndpO4mIpihVqAXw==}
    dependencies:
      entities: 4.5.0

  /path-exists@4.0.0:
    resolution: {integrity: sha512-ak9Qy5Q7jYb2Wwcey5Fpvg2KoAc/ZIhLSLOSBmRmygPsGwkVVt0fZa0qrtMz+m6tJTAHfZQ8FnmB4MG4LWy7/w==}
    engines: {node: '>=8'}
    dev: true

  /path-key@3.1.1:
    resolution: {integrity: sha512-ojmeN0qd+y0jszEtoY48r0Peq5dwMEkIlCOu6Q5f41lfkswXuKtYrhgoTpLnyIcHm24Uhqx+5Tqm2InSwLhE6Q==}
    engines: {node: '>=8'}
    dev: true

  /path-key@4.0.0:
    resolution: {integrity: sha512-haREypq7xkM7ErfgIyA0z+Bj4AGKlMSdlQE2jvJo6huWD1EdkKYV+G/T4nq0YEF2vgTT8kqMFKo1uHn950r4SQ==}
    engines: {node: '>=12'}
    dev: true

  /path-type@5.0.0:
    resolution: {integrity: sha512-5HviZNaZcfqP95rwpv+1HDgUamezbqdSYTyzjTvwtJSnIH+3vnbmWsItli8OFEndS984VT55M3jduxZbX351gg==}
    engines: {node: '>=12'}

  /photoswipe@5.4.4:
    resolution: {integrity: sha512-WNFHoKrkZNnvFFhbHL93WDkW3ifwVOXSW3w1UuZZelSmgXpIGiZSNlZJq37rR8YejqME2rHs9EhH9ZvlvFH2NA==}
    engines: {node: '>= 0.12.0'}
    dev: true

  /picocolors@1.1.0:
    resolution: {integrity: sha512-TQ92mBOW0l3LeMeyLV6mzy/kWr8lkd/hp3mTg7wYK7zJhuBStmGMBG0BdeDZS/dZx1IukaX6Bk11zcln25o1Aw==}

  /picomatch@2.3.1:
    resolution: {integrity: sha512-JU3teHTNjmE2VCGFzuY8EXzCDVwEqB2a8fsIvwaStHhAWJEeVd1o1QD80CU6+ZdEXXSLbSsuLwJjkCBWqRQUVA==}
    engines: {node: '>=8.6'}

  /pngjs@5.0.0:
    resolution: {integrity: sha512-40QW5YalBNfQo5yRYmiw7Yz6TKKVr3h6970B2YE+3fQpsWcrbj1PzJgxeJ19DRQjhMbKPIuMY8rFaXc8moolVw==}
    engines: {node: '>=10.13.0'}
    dev: true

  /postcss-load-config@6.0.1(postcss@8.4.47):
    resolution: {integrity: sha512-oPtTM4oerL+UXmx+93ytZVN82RrlY/wPUV8IeDxFrzIjXOLF1pN+EmKPLbubvKHT2HC20xXsCAH2Z+CKV6Oz/g==}
    engines: {node: '>= 18'}
    peerDependencies:
      jiti: '>=1.21.0'
      postcss: '>=8.0.9'
      tsx: ^4.8.1
      yaml: ^2.4.2
    peerDependenciesMeta:
      jiti:
        optional: true
      postcss:
        optional: true
      tsx:
        optional: true
      yaml:
        optional: true
    dependencies:
      lilconfig: 3.1.2
      postcss: 8.4.47

  /postcss-value-parser@4.2.0:
    resolution: {integrity: sha512-1NNCs6uurfkVbeXG4S8JFT9t19m45ICnif8zWLd5oPSZ50QnwMfK+H3jv408d4jw/7Bttv5axS5IiHoLaVNHeQ==}

  /postcss@8.4.47:
    resolution: {integrity: sha512-56rxCq7G/XfB4EkXq9Egn5GCqugWvDFjafDOThIdMBsI15iqPqR5r15TfSr1YPYeEI19YeaXMCbY6u88Y76GLQ==}
    engines: {node: ^10 || ^12 || >=14}
    dependencies:
      nanoid: 3.3.7
      picocolors: 1.1.0
      source-map-js: 1.2.1

  /pretty-ms@9.1.0:
    resolution: {integrity: sha512-o1piW0n3tgKIKCwk2vpM/vOV13zjJzvP37Ioze54YlTHE06m4tjEbzg9WsKkvTuyYln2DHjo5pY4qrZGI0otpw==}
    engines: {node: '>=18'}
    dependencies:
      parse-ms: 4.0.0
    dev: true

  /property-information@6.5.0:
    resolution: {integrity: sha512-PgTgs/BlvHxOu8QuEN7wi5A0OmXaBcHpmCSTehcs6Uuu9IkDIEo13Hy7n898RHfrQ49vKCoGeWZSaAK01nwVig==}
    dev: true

  /punycode.js@2.3.1:
    resolution: {integrity: sha512-uxFIHU0YlHYhDQtV4R9J6a52SLx28BCjT+4ieh7IGbgwVJWO+km431c4yRlREUAsAmt/uMjQUyQHNEPf0M39CA==}
    engines: {node: '>=6'}

  /qrcode@1.5.4:
    resolution: {integrity: sha512-1ca71Zgiu6ORjHqFBDpnSMTR2ReToX4l1Au1VFLyVeBTFavzQnv5JxMFr3ukHVKpSrSA2MCk0lNJSykjUfz7Zg==}
    engines: {node: '>=10.13.0'}
    hasBin: true
    dependencies:
      dijkstrajs: 1.0.3
      pngjs: 5.0.0
      yargs: 15.4.1
    dev: true

  /queue-microtask@1.2.3:
    resolution: {integrity: sha512-NuaNSa6flKT5JaSYQzJok04JzTL1CA6aGhv5rfLW3PgqA+M2ChpZQnAC8h8i4ZFkBS8X5RqkDBHA7r4hej3K9A==}

  /readdirp@3.6.0:
    resolution: {integrity: sha512-hOS089on8RduqdbhvQ5Z37A0ESjsqz6qnRcffsMU3495FuTdqSm+7bhJ29JvIOsBDEEnan5DPu9t3To9VRlMzA==}
    engines: {node: '>=8.10.0'}
    dependencies:
      picomatch: 2.3.1

  /readdirp@4.0.1:
    resolution: {integrity: sha512-GkMg9uOTpIWWKbSsgwb5fA4EavTR+SG/PMPoAY8hkhHfEEY0/vqljY+XHqtDf2cr2IJtoNRDbrrEpZUiZCkYRw==}
    engines: {node: '>= 14.16.0'}
    dev: true

  /regex@4.3.2:
    resolution: {integrity: sha512-kK/AA3A9K6q2js89+VMymcboLOlF5lZRCYJv3gzszXFHBr6kO6qLGzbm+UIugBEV8SMMKCTR59txoY6ctRHYVw==}
    dev: true

  /require-directory@2.1.1:
    resolution: {integrity: sha512-fGxEI7+wsG9xrvdjsrlmL22OMTTiHRwAMroiEeMgq8gzoLC/PQr7RsRDSTLUg/bZAZtF+TVIkHc6/4RIKrui+Q==}
    engines: {node: '>=0.10.0'}
    dev: true

  /require-main-filename@2.0.0:
    resolution: {integrity: sha512-NKN5kMDylKuldxYLSUfrbo5Tuzh4hd+2E8NPPX02mZtn1VuREQToYe/ZdlJy+J3uCpfaiGF05e7B8W0iXbQHmg==}
    dev: true

  /restore-cursor@5.1.0:
    resolution: {integrity: sha512-oMA2dcrw6u0YfxJQXm342bFKX/E4sG9rbTzO9ptUcR/e8A33cHuvStiYOwH7fszkZlZ1z/ta9AAoPk2F4qIOHA==}
    engines: {node: '>=18'}
    dependencies:
      onetime: 7.0.0
      signal-exit: 4.1.0

  /reusify@1.0.4:
    resolution: {integrity: sha512-U9nH88a3fc/ekCF1l0/UP1IosiuIjyTh7hBvXVMHYgVcfGvt897Xguj2UOLDeI5BG2m7/uwyaLVT6fbtCwTyzw==}
    engines: {iojs: '>=1.0.0', node: '>=0.10.0'}

  /rollup@4.22.4:
    resolution: {integrity: sha512-vD8HJ5raRcWOyymsR6Z3o6+RzfEPCnVLMFJ6vRslO1jt4LO6dUo5Qnpg7y4RkZFM2DMe3WUirkI5c16onjrc6A==}
    engines: {node: '>=18.0.0', npm: '>=8.0.0'}
    hasBin: true
    dependencies:
      '@types/estree': 1.0.5
    optionalDependencies:
      '@rollup/rollup-android-arm-eabi': 4.22.4
      '@rollup/rollup-android-arm64': 4.22.4
      '@rollup/rollup-darwin-arm64': 4.22.4
      '@rollup/rollup-darwin-x64': 4.22.4
      '@rollup/rollup-linux-arm-gnueabihf': 4.22.4
      '@rollup/rollup-linux-arm-musleabihf': 4.22.4
      '@rollup/rollup-linux-arm64-gnu': 4.22.4
      '@rollup/rollup-linux-arm64-musl': 4.22.4
      '@rollup/rollup-linux-powerpc64le-gnu': 4.22.4
      '@rollup/rollup-linux-riscv64-gnu': 4.22.4
      '@rollup/rollup-linux-s390x-gnu': 4.22.4
      '@rollup/rollup-linux-x64-gnu': 4.22.4
      '@rollup/rollup-linux-x64-musl': 4.22.4
      '@rollup/rollup-win32-arm64-msvc': 4.22.4
      '@rollup/rollup-win32-ia32-msvc': 4.22.4
      '@rollup/rollup-win32-x64-msvc': 4.22.4
      fsevents: 2.3.3

  /run-parallel@1.2.0:
    resolution: {integrity: sha512-5l4VyZR86LZ/lDxZTR6jqL8AFE2S0IFLMP26AbjsLVADxHdhB/c0GUsH+y39UfCi3dzz8OlQuPmnaJOMoDHQBA==}
    dependencies:
      queue-microtask: 1.2.3

  /rxjs@7.8.1:
    resolution: {integrity: sha512-AA3TVj+0A2iuIoQkWEK/tqFjBq2j+6PO6Y0zJcvzLAFhEFIO3HL0vls9hWLncZbAAbK0mar7oZ4V079I/qPMxg==}
    dependencies:
      tslib: 2.7.0

  /safer-buffer@2.1.2:
    resolution: {integrity: sha512-YZo3K82SD7Riyi0E1EQPojLz7kpepnSQI9IyPbHHg1XXXevb5dJI7tpyN2ADxGcQbHG7vcyRHk0cbwqcQriUtg==}

  /sass-embedded-android-arm64@1.79.3:
    resolution: {integrity: sha512-Wqm/WKHIDQl7w7eIQRO/GQ7EXfnwNpipCyJL7Xtb15vSAV64J4/0D/esy6GOPlVG+qcu8/XN8NV7Bf5wZ2ExUw==}
    engines: {node: '>=14.0.0'}
    cpu: [arm64]
    os: [android]
    requiresBuild: true
    optional: true

  /sass-embedded-android-arm@1.79.3:
    resolution: {integrity: sha512-rrdaVDkKBLUqzdqlBFamUbeuLG+8r/QLXHIgz4qPhIDqceJH6ds0Vzrae9Ef6DhYfMatOg2xiScdatwQ8Yl/hA==}
    engines: {node: '>=14.0.0'}
    cpu: [arm]
    os: [android]
    requiresBuild: true
    optional: true

  /sass-embedded-android-ia32@1.79.3:
    resolution: {integrity: sha512-6rDmH0O7hjBP04/xBAFzSYYMU/7MrQYCak4541BZIbIfa2uw0x/8+mB7lZjdgFsBrFjcpdVCPhZPUE6Y50c00A==}
    engines: {node: '>=14.0.0'}
    cpu: [ia32]
    os: [android]
    requiresBuild: true
    optional: true

  /sass-embedded-android-riscv64@1.79.3:
    resolution: {integrity: sha512-B/PgB0AfTCvOlF1g89raJTwTXIUQUM3OXDWqEKIlJEZM1Yao91i8ZkyrFkDMzT4G5sETy4o8pgK+qE9+7bFlug==}
    engines: {node: '>=14.0.0'}
    cpu: [riscv64]
    os: [android]
    requiresBuild: true
    optional: true

  /sass-embedded-android-x64@1.79.3:
    resolution: {integrity: sha512-a5cpo9Yw4xnX32Uo3WfMZLaTVnI/h2n7U3K3eTygyj707yhGkUB0i+qxldzCw8MmKivIu9irG6O4kmnRjW6f7g==}
    engines: {node: '>=14.0.0'}
    cpu: [x64]
    os: [android]
    requiresBuild: true
    optional: true

  /sass-embedded-darwin-arm64@1.79.3:
    resolution: {integrity: sha512-imafD0nlVz5FJhqBqxUbG5rK4E3cu1GxhMZ5VhKm0k4t5jFQo+3OjN7sHT4Ee2Mk1g8sjr5dtq5enDU4fs6lXA==}
    engines: {node: '>=14.0.0'}
    cpu: [arm64]
    os: [darwin]
    requiresBuild: true
    optional: true

  /sass-embedded-darwin-x64@1.79.3:
    resolution: {integrity: sha512-pjciT1FcMUMA4rWdpyZYSwMOvxk5JP7R6vy7TzvqkUEqXxP9FTflYnAiwgYUDVTpngHHqRxTjdyW+e+h2L9dHw==}
    engines: {node: '>=14.0.0'}
    cpu: [x64]
    os: [darwin]
    requiresBuild: true
    optional: true

  /sass-embedded-linux-arm64@1.79.3:
    resolution: {integrity: sha512-ODo8ghwk6KHxchgwxq4CwgfYwWdreEbsQoukeEgRKxHcuLB9XF6tol9pGlfrc8sYox48Vp5WDCZuzgoo6rJ6tg==}
    engines: {node: '>=14.0.0'}
    cpu: [arm64]
    os: [linux]
    requiresBuild: true
    optional: true

  /sass-embedded-linux-arm@1.79.3:
    resolution: {integrity: sha512-n0bDtzABPE5YaL9wSLxNPiQMl1zArsGblHJyED6fEHz41m+OkCTopfO8IVjcf+MBrK/j11gonxiIGWO+fNOxvg==}
    engines: {node: '>=14.0.0'}
    cpu: [arm]
    os: [linux]
    requiresBuild: true
    optional: true

  /sass-embedded-linux-ia32@1.79.3:
    resolution: {integrity: sha512-oC3rUyIE6mEm2etsc4CuNu6IVmB6CoSM4KsubxzCD3S37QFXq8wYbI0t9iiDdTkKb5Iu+vUyhn+tYJRVHg0tvw==}
    engines: {node: '>=14.0.0'}
    cpu: [ia32]
    os: [linux]
    requiresBuild: true
    optional: true

  /sass-embedded-linux-musl-arm64@1.79.3:
    resolution: {integrity: sha512-Q9/5lsrK/JnQci3DwxZ9PGIIrRxuo/bySv+gbyVp8Kb7gdkZcEsY7HkxaBJfwVEwpZSGAyCviyZDHDMILjliOw==}
    engines: {node: '>=14.0.0'}
    cpu: [arm64]
    os: [linux]
    requiresBuild: true
    optional: true

  /sass-embedded-linux-musl-arm@1.79.3:
    resolution: {integrity: sha512-TOUYMtDs9xoMsJSEEr7NjtcVCqVpg1eSOQHXXruJ1kiYfxwmHrCYTjTLoefbZ29mWqIq8NUaXJG4rZNDK6NzRA==}
    engines: {node: '>=14.0.0'}
    cpu: [arm]
    os: [linux]
    requiresBuild: true
    optional: true

  /sass-embedded-linux-musl-ia32@1.79.3:
    resolution: {integrity: sha512-T2uERh3gs9eWUzdkDadPuYbelQJQLZyX8myutUd4fxyrQ7ToQRBwcMoynEjl48DBHnM0oRiJUHrV9uFuJ+fmRA==}
    engines: {node: '>=14.0.0'}
    cpu: [ia32]
    os: [linux]
    requiresBuild: true
    optional: true

  /sass-embedded-linux-musl-riscv64@1.79.3:
    resolution: {integrity: sha512-XTuYtTBPFeEjydS2GsIUkMztzXIiz13noknE7m1yAbVxOchu9jD9FCLAdK9pVPPki+9BiLSxsutYwOcQn8atqQ==}
    engines: {node: '>=14.0.0'}
    cpu: [riscv64]
    os: [linux]
    requiresBuild: true
    optional: true

  /sass-embedded-linux-musl-x64@1.79.3:
    resolution: {integrity: sha512-gDHfaPlxT/XQTMbfb2y+U6zDMuI8pfapVXTYlUrgYhKH2KoICclIvahhjFii5i5+1dHpfGzjgYKBqI3nvZsYFg==}
    engines: {node: '>=14.0.0'}
    cpu: [x64]
    os: [linux]
    requiresBuild: true
    optional: true

  /sass-embedded-linux-riscv64@1.79.3:
    resolution: {integrity: sha512-NONTa//1ZfxA87+Zjp3rabL+Z9gM67FJBdktRKXXMBAce5i8eCj/eqJGUOGPjYxtvxtQw77cex0qMr9SZnX6ww==}
    engines: {node: '>=14.0.0'}
    cpu: [riscv64]
    os: [linux]
    requiresBuild: true
    optional: true

  /sass-embedded-linux-x64@1.79.3:
    resolution: {integrity: sha512-drlUqMMw222+f/T5sNrIAv+z0vQwLkO4zAlDmf4biLdWIloPP/3plTodAkMyfagNcvA8jG2jN414pJXBI3zK6w==}
    engines: {node: '>=14.0.0'}
    cpu: [x64]
    os: [linux]
    requiresBuild: true
    optional: true

  /sass-embedded-win32-arm64@1.79.3:
    resolution: {integrity: sha512-gYz0IUb0fLkHUbhq+HR52wvQfG75Zu1s48/v48TqC+b04H/01k2eiawp/Ec1f+lhpIL/pr5+n5jWR6CjkxPdnQ==}
    engines: {node: '>=14.0.0'}
    cpu: [arm64]
    os: [win32]
    requiresBuild: true
    optional: true

  /sass-embedded-win32-ia32@1.79.3:
    resolution: {integrity: sha512-fbDTyzbqRc+xCWZ+YHSDt2WvGk5PW2K0SjyHuwes/Fls1+wdO4iHIukE/pD+HSWytYrtCqhe7EFq5Ug5HxGTLg==}
    engines: {node: '>=14.0.0'}
    cpu: [ia32]
    os: [win32]
    requiresBuild: true
    optional: true

  /sass-embedded-win32-x64@1.79.3:
    resolution: {integrity: sha512-vvfr6wyCaHvdQbGS8UkYab6DXc1FKJRYFT5aFE3QTVqbzCqmJ5tf80E4+gvB99nljLtMjwKR1d332iWI9KDLhw==}
    engines: {node: '>=14.0.0'}
    cpu: [x64]
    os: [win32]
    requiresBuild: true
    optional: true

  /sass-embedded@1.79.3:
    resolution: {integrity: sha512-zUve2qCn6uSOMZnZazLzrDWq//OQWFle5G45vJjv3B/ADIA3TXVgqHqN3u7D2vGajOGREz0HN5nhliSoKmQqZA==}
    engines: {node: '>=16.0.0'}
    hasBin: true
    dependencies:
      '@bufbuild/protobuf': 2.1.0
      buffer-builder: 0.2.0
      colorjs.io: 0.5.2
      immutable: 4.3.7
      rxjs: 7.8.1
      supports-color: 8.1.1
      varint: 6.0.0
    optionalDependencies:
      sass-embedded-android-arm: 1.79.3
      sass-embedded-android-arm64: 1.79.3
      sass-embedded-android-ia32: 1.79.3
      sass-embedded-android-riscv64: 1.79.3
      sass-embedded-android-x64: 1.79.3
      sass-embedded-darwin-arm64: 1.79.3
      sass-embedded-darwin-x64: 1.79.3
      sass-embedded-linux-arm: 1.79.3
      sass-embedded-linux-arm64: 1.79.3
      sass-embedded-linux-ia32: 1.79.3
      sass-embedded-linux-musl-arm: 1.79.3
      sass-embedded-linux-musl-arm64: 1.79.3
      sass-embedded-linux-musl-ia32: 1.79.3
      sass-embedded-linux-musl-riscv64: 1.79.3
      sass-embedded-linux-musl-x64: 1.79.3
      sass-embedded-linux-riscv64: 1.79.3
      sass-embedded-linux-x64: 1.79.3
      sass-embedded-win32-arm64: 1.79.3
      sass-embedded-win32-ia32: 1.79.3
      sass-embedded-win32-x64: 1.79.3

  /sax@1.4.1:
    resolution: {integrity: sha512-+aWOz7yVScEGoKNd4PA10LZ8sk0A/z5+nXQG5giUO5rprX9jgYsTdov9qCchZiPIZezbZH+jRut8nPodFAX4Jg==}
    dev: true

  /section-matter@1.0.0:
    resolution: {integrity: sha512-vfD3pmTzGpufjScBh50YHKzEu2lxBWhVEHsNGoEXmCmn2hKGfeNLYMzCJpe8cD7gqX7TJluOVpBkAequ6dgMmA==}
    engines: {node: '>=4'}
    dependencies:
      extend-shallow: 2.0.1
      kind-of: 6.0.3

  /set-blocking@2.0.0:
    resolution: {integrity: sha512-KiKBS8AnWGEyLzofFfmvKwpdPzqiy16LvQfK3yv/fVH7Bj13/wl3JSR1J+rfgRE9q7xUJK4qvgS8raSOeLUehw==}
    dev: true

  /shebang-command@2.0.0:
    resolution: {integrity: sha512-kHxr2zZpYtdmrN1qDjrrX/Z1rR1kG8Dx+gkpK1G4eXmvXswmcE1hTWBWYUzlraYw1/yZp6YuDY77YtvbN0dmDA==}
    engines: {node: '>=8'}
    dependencies:
      shebang-regex: 3.0.0
    dev: true

  /shebang-regex@3.0.0:
    resolution: {integrity: sha512-7++dFhtcx3353uBaq8DDR4NuxBetBzC7ZQOhmTQInHEd6bSrXdiEyzCvG07Z44UYdLShWUyXt5M/yhz8ekcb1A==}
    engines: {node: '>=8'}
    dev: true

  /shiki@1.18.0:
    resolution: {integrity: sha512-8jo7tOXr96h9PBQmOHVrltnETn1honZZY76YA79MHheGQg55jBvbm9dtU+MI5pjC5NJCFuA6rvVTLVeSW5cE4A==}
    dependencies:
      '@shikijs/core': 1.18.0
      '@shikijs/engine-javascript': 1.18.0
      '@shikijs/engine-oniguruma': 1.18.0
      '@shikijs/types': 1.18.0
      '@shikijs/vscode-textmate': 9.2.2
      '@types/hast': 3.0.4
    dev: true

  /signal-exit@4.1.0:
    resolution: {integrity: sha512-bzyZ1e88w9O1iNJbKnOlvYTrWPDl46O1bG0D3XInv+9tkPrxrN8jUUTiFlDkkmKWgn1M6CfIA13SuGqOa9Korw==}
    engines: {node: '>=14'}

  /sitemap@8.0.0:
    resolution: {integrity: sha512-+AbdxhM9kJsHtruUF39bwS/B0Fytw6Fr1o4ZAIAEqA6cke2xcoO2GleBw9Zw7nRzILVEgz7zBM5GiTJjie1G9A==}
    engines: {node: '>=14.0.0', npm: '>=6.0.0'}
    hasBin: true
    dependencies:
      '@types/node': 17.0.45
      '@types/sax': 1.2.7
      arg: 5.0.2
      sax: 1.4.1
    dev: true

  /slash@5.1.0:
    resolution: {integrity: sha512-ZA6oR3T/pEyuqwMgAKT0/hAv8oAXckzbkmR0UkUosQ+Mc4RxGoJkRmwHgHufaenlyAgE1Mxgpdcrf75y6XcnDg==}
    engines: {node: '>=14.16'}

  /source-map-js@1.2.1:
    resolution: {integrity: sha512-UXWMKhLOwVKb728IUtQPXxfYU+usdybtUrK/8uGE8CQMvrhOpwvzDBwj0QhSL7MQc7vIsISBG8VQ8+IDQxpfQA==}
    engines: {node: '>=0.10.0'}

  /space-separated-tokens@2.0.2:
    resolution: {integrity: sha512-PEGlAwrG8yXGXRjW32fGbg66JAlOAwbObuqVoJpv/mRgoWDQfgH1wDPvtzWyUSNAXBGSk8h755YDbbcEy3SH2Q==}
    dev: true

  /sprintf-js@1.0.3:
    resolution: {integrity: sha512-D9cPgkvLlV3t3IzL0D0YLvGA9Ahk4PcvVwUbN0dSGr1aP0Nrt4AEnTUbuGvquEC0mA64Gqt1fzirlRs5ibXx8g==}

  /stdin-discarder@0.2.2:
    resolution: {integrity: sha512-UhDfHmA92YAlNnCfhmq0VeNL5bDbiZGg7sZ2IvPsXubGkiNa9EC+tUTsjBRsYUAz87btI6/1wf4XoVvQ3uRnmQ==}
    engines: {node: '>=18'}

  /string-width@4.2.3:
    resolution: {integrity: sha512-wKyQRQpjJ0sIp62ErSZdGsjMJWsap5oRNihHhu6G7JVO/9jIB6UyevL+tXuOqrng8j/cxKTWyWUwvSTriiZz/g==}
    engines: {node: '>=8'}
    dependencies:
      emoji-regex: 8.0.0
      is-fullwidth-code-point: 3.0.0
      strip-ansi: 6.0.1
    dev: true

  /string-width@7.2.0:
    resolution: {integrity: sha512-tsaTIkKW9b4N+AEj+SVA+WhJzV7/zMhcSu78mLKWSk7cXMOSHsBKFWUs0fWwq8QyK3MgJBQRX6Gbi4kYbdvGkQ==}
    engines: {node: '>=18'}
    dependencies:
      emoji-regex: 10.4.0
      get-east-asian-width: 1.2.0
      strip-ansi: 7.1.0

  /stringify-entities@4.0.4:
    resolution: {integrity: sha512-IwfBptatlO+QCJUo19AqvrPNqlVMpW9YEL2LIVY+Rpv2qsjCGxaDLNRgeGsQWJhfItebuJhsGSLjaBbNSQ+ieg==}
    dependencies:
      character-entities-html4: 2.1.0
      character-entities-legacy: 3.0.0
    dev: true

  /strip-ansi@6.0.1:
    resolution: {integrity: sha512-Y38VPSHcqkFrCpFnQ9vuSXmquuv5oXOKpGeT6aGrr3o3Gc9AlVa6JBfUSOCnbxGGZF+/0ooI7KrPuUSztUdU5A==}
    engines: {node: '>=8'}
    dependencies:
      ansi-regex: 5.0.1
    dev: true

  /strip-ansi@7.1.0:
    resolution: {integrity: sha512-iq6eVVI64nQQTRYq2KtEg2d2uU7LElhTJwsH4YzIHZshxlgZms/wIc4VoDQTlG/IvVIrBKG06CrZnp0qv7hkcQ==}
    engines: {node: '>=12'}
    dependencies:
      ansi-regex: 6.1.0

  /strip-bom-string@1.0.0:
    resolution: {integrity: sha512-uCC2VHvQRYu+lMh4My/sFNmF2klFymLX1wHJeXnbEJERpV/ZsVuonzerjfrGpIGF7LBVa1O7i9kjiWvJiFck8g==}
    engines: {node: '>=0.10.0'}

  /strip-final-newline@4.0.0:
    resolution: {integrity: sha512-aulFJcD6YK8V1G7iRB5tigAP4TsHBZZrOV8pjV++zdUwmeV8uzbY7yn6h9MswN62adStNZFuCIx4haBnRuMDaw==}
    engines: {node: '>=18'}
    dev: true

  /supports-color@8.1.1:
    resolution: {integrity: sha512-MpUEN2OodtUzxvKQl72cUF7RQ5EiHsGvSsVG0ia9c5RbWGL2CI4C7EpPS8UTBIplnlzZiNuV56w+FuNxy3ty2Q==}
    engines: {node: '>=10'}
    dependencies:
      has-flag: 4.0.0

  /to-fast-properties@2.0.0:
    resolution: {integrity: sha512-/OaKK0xYrs3DmxRYqL/yDc+FxFUVYhDlXMhRmv3z915w2HF1tnN1omB354j8VUGO/hbRzyD6Y3sA7v7GS/ceog==}
    engines: {node: '>=4'}

  /to-regex-range@5.0.1:
    resolution: {integrity: sha512-65P7iz6X5yEr1cwcgvQxbbIw7Uk3gOy5dIdtZ4rDveLqhrdJP+Li/Hx6tyK0NEb+2GCyneCMJiGqrADCSNk8sQ==}
    engines: {node: '>=8.0'}
    dependencies:
      is-number: 7.0.0

  /trim-lines@3.0.1:
    resolution: {integrity: sha512-kRj8B+YHZCc9kQYdWfJB2/oUl9rA99qbowYYBtr4ui4mZyAQ2JpvVBd/6U2YloATfqBhBTSMhTpgBHtU0Mf3Rg==}
    dev: true

  /tslib@2.7.0:
    resolution: {integrity: sha512-gLXCKdN1/j47AiHiOkJN69hJmcbGTHI0ImLmbYLHykhgeN0jVGola9yVjFgzCUklsZQMW55o+dW7IXv3RCXDzA==}

  /uc.micro@2.1.0:
    resolution: {integrity: sha512-ARDJmphmdvUk6Glw7y9DQ2bFkKBHwQHLi2lsaH6PPmz/Ka9sFOBsBluozhDltWmnv9u/cF6Rt87znRTPV+yp/A==}

  /undici-types@6.19.8:
    resolution: {integrity: sha512-ve2KP6f/JnbPBFyobGHuerC9g1FYGn/F8n1LWTwNxCEzd6IfqTwUQcNXgEtmmQ6DlRrC1hrSrBnCZPokRrDHjw==}

  /undici@6.19.8:
    resolution: {integrity: sha512-U8uCCl2x9TK3WANvmBavymRzxbfFYG+tAu+fgx3zxQy3qdagQqBLwJVrdyO1TBfUXvfKveMKJZhpvUYoOjM+4g==}
    engines: {node: '>=18.17'}

  /unicorn-magic@0.1.0:
    resolution: {integrity: sha512-lRfVq8fE8gz6QMBuDM6a+LO3IAzTi05H6gCVaUpir2E1Rwpo4ZUog45KpNXKC/Mn3Yb9UDuHumeFTo9iV/D9FQ==}
    engines: {node: '>=18'}

  /unicorn-magic@0.3.0:
    resolution: {integrity: sha512-+QBBXBCvifc56fsbuxZQ6Sic3wqqc3WWaqxs58gvJrcOuN83HGTCwz3oS5phzU9LthRNE9VrJCFCLUgHeeFnfA==}
    engines: {node: '>=18'}
    dev: true

  /unist-util-is@6.0.0:
    resolution: {integrity: sha512-2qCTHimwdxLfz+YzdGfkqNlH0tLi9xjTnHddPmJwtIG9MGsdbutfTc4P+haPD7l7Cjxf/WZj+we5qfVPvvxfYw==}
    dependencies:
      '@types/unist': 3.0.3
    dev: true

  /unist-util-position@5.0.0:
    resolution: {integrity: sha512-fucsC7HjXvkB5R3kTCO7kUjRdrS0BJt3M/FPxmHMBOm8JQi2BsHAHFsy27E0EolP8rp0NzXsJ+jNPyDWvOJZPA==}
    dependencies:
      '@types/unist': 3.0.3
    dev: true

  /unist-util-stringify-position@4.0.0:
    resolution: {integrity: sha512-0ASV06AAoKCDkS2+xw5RXJywruurpbC4JZSm7nr7MOt1ojAzvyyaO+UxZf18j8FCF6kmzCZKcAgN/yu2gm2XgQ==}
    dependencies:
      '@types/unist': 3.0.3
    dev: true

  /unist-util-visit-parents@6.0.1:
    resolution: {integrity: sha512-L/PqWzfTP9lzzEa6CKs0k2nARxTdZduw3zyh8d2NVBnsyvHjSX4TWse388YrrQKbvI8w20fGjGlhgT96WwKykw==}
    dependencies:
      '@types/unist': 3.0.3
      unist-util-is: 6.0.0
    dev: true

  /unist-util-visit@5.0.0:
    resolution: {integrity: sha512-MR04uvD+07cwl/yhVuVWAtw+3GOR/knlL55Nd/wAdblk27GCVt3lqpTivy/tkJcZoNPzTwS1Y+KMojlLDhoTzg==}
    dependencies:
      '@types/unist': 3.0.3
      unist-util-is: 6.0.0
      unist-util-visit-parents: 6.0.1
    dev: true

  /universalify@2.0.1:
    resolution: {integrity: sha512-gptHNQghINnc/vTGIk0SOFGFNXw7JVrlRUtConJRlvaw6DuX0wO5Jeko9sWrMBhh+PsYAZ7oXAiOnf/UKogyiw==}
    engines: {node: '>= 10.0.0'}

  /upath@2.0.1:
    resolution: {integrity: sha512-1uEe95xksV1O0CYKXo8vQvN1JEbtJp7lb7C5U9HMsIp6IVwntkH/oNUzyVNQSd4S1sYk2FpSSW44FqMc8qee5w==}
    engines: {node: '>=4'}

  /update-browserslist-db@1.1.0(browserslist@4.23.3):
    resolution: {integrity: sha512-EdRAaAyk2cUE1wOf2DkEhzxqOQvFOoRJFNS6NeyJ01Gp2beMRpBAINjM2iDXE3KCuKhwnvHIQCJm6ThL2Z+HzQ==}
    hasBin: true
    peerDependencies:
      browserslist: '>= 4.21.0'
    dependencies:
      browserslist: 4.23.3
      escalade: 3.2.0
      picocolors: 1.1.0

  /varint@6.0.0:
    resolution: {integrity: sha512-cXEIW6cfr15lFv563k4GuVuW/fiwjknytD37jIOLSdSWuOI6WnO/oKwmP2FQTU2l01LP8/M5TSAJpzUaGe3uWg==}

  /vfile-message@4.0.2:
    resolution: {integrity: sha512-jRDZ1IMLttGj41KcZvlrYAaI3CfqpLpfpf+Mfig13viT6NKvRzWZ+lXz0Y5D60w6uJIBAOGq9mSHf0gktF0duw==}
    dependencies:
      '@types/unist': 3.0.3
      unist-util-stringify-position: 4.0.0
    dev: true

  /vfile@6.0.3:
    resolution: {integrity: sha512-KzIbH/9tXat2u30jf+smMwFCsno4wHVdNmzFyL+T/L3UGqqk6JKfVqOFOZEpZSHADH1k40ab6NUIXZq422ov3Q==}
    dependencies:
      '@types/unist': 3.0.3
      vfile-message: 4.0.2
    dev: true

  /vite@5.4.7(sass-embedded@1.79.3):
    resolution: {integrity: sha512-5l2zxqMEPVENgvzTuBpHer2awaetimj2BGkhBPdnwKbPNOlHsODU+oiazEZzLK7KhAnOrO+XGYJYn4ZlUhDtDQ==}
    engines: {node: ^18.0.0 || >=20.0.0}
    hasBin: true
    peerDependencies:
      '@types/node': ^18.0.0 || >=20.0.0
      less: '*'
      lightningcss: ^1.21.0
      sass: '*'
      sass-embedded: '*'
      stylus: '*'
      sugarss: '*'
      terser: ^5.4.0
    peerDependenciesMeta:
      '@types/node':
        optional: true
      less:
        optional: true
      lightningcss:
        optional: true
      sass:
        optional: true
      sass-embedded:
        optional: true
      stylus:
        optional: true
      sugarss:
        optional: true
      terser:
        optional: true
    dependencies:
      esbuild: 0.21.5
      postcss: 8.4.47
      rollup: 4.22.4
      sass-embedded: 1.79.3
    optionalDependencies:
      fsevents: 2.3.3

  /vue-demi@0.14.10(vue@3.5.8):
    resolution: {integrity: sha512-nMZBOwuzabUO0nLgIcc6rycZEebF6eeUfaiQx9+WSk8e29IbLvPU9feI6tqW4kTo3hvoYAJkMh8n8D0fuISphg==}
    engines: {node: '>=12'}
    hasBin: true
    requiresBuild: true
    peerDependencies:
      '@vue/composition-api': ^1.0.0-rc.1
      vue: ^3.0.0-0 || ^2.6.0
    peerDependenciesMeta:
      '@vue/composition-api':
        optional: true
    dependencies:
      vue: 3.5.8

  /vue-router@4.4.5(vue@3.5.8):
    resolution: {integrity: sha512-4fKZygS8cH1yCyuabAXGUAsyi1b2/o/OKgu/RUb+znIYOxPRxdkytJEx+0wGcpBE1pX6vUgh5jwWOKRGvuA/7Q==}
    peerDependencies:
      vue: ^3.2.0
    dependencies:
      '@vue/devtools-api': 6.6.4
      vue: 3.5.8

  /vue@3.5.8:
    resolution: {integrity: sha512-hvuvuCy51nP/1fSRvrrIqTLSvrSyz2Pq+KQ8S8SXCxTWVE0nMaOnSDnSOxV1eYmGfvK7mqiwvd1C59CEEz7dAQ==}
    peerDependencies:
      typescript: '*'
    peerDependenciesMeta:
      typescript:
        optional: true
    dependencies:
      '@vue/compiler-dom': 3.5.8
      '@vue/compiler-sfc': 3.5.8
      '@vue/runtime-dom': 3.5.8
      '@vue/server-renderer': 3.5.8(vue@3.5.8)
      '@vue/shared': 3.5.8

  /vuepress-plugin-components@2.0.0-rc.54(sass-embedded@1.79.3)(vuepress@2.0.0-rc.15):
    resolution: {integrity: sha512-SwfDrGQMkwuquFoVcokKL/Et4AhUIdwGsChkGPVCtoo/o9/tUA+3KRLrUkB9ypiX01czTnLs6SuS0dkxyLv7WA==}
    engines: {node: '>=18.19.0', npm: '>=8', pnpm: '>=7', yarn: '>=2'}
    peerDependencies:
      artplayer: ^5.0.0
      dashjs: 4.7.4
      hls.js: ^1.4.12
      mpegts.js: ^1.7.3
      sass: ^1.79.3
      sass-embedded: ^1.79.3
      sass-loader: ^16.0.2
      vidstack: ^1.12.9
      vuepress: 2.0.0-rc.15
    peerDependenciesMeta:
      artplayer:
        optional: true
      dashjs:
        optional: true
      hls.js:
        optional: true
      mpegts.js:
        optional: true
      sass:
        optional: true
      sass-embedded:
        optional: true
      sass-loader:
        optional: true
      vidstack:
        optional: true
    dependencies:
      '@stackblitz/sdk': 1.11.0
      '@vuepress/helper': 2.0.0-rc.47(vuepress@2.0.0-rc.15)
      '@vuepress/plugin-sass-palette': 2.0.0-rc.51(sass-embedded@1.79.3)(vuepress@2.0.0-rc.15)
      '@vueuse/core': 11.1.0(vue@3.5.8)
      balloon-css: 1.2.0
      create-codepen: 2.0.0
      qrcode: 1.5.4
      sass-embedded: 1.79.3
      vue: 3.5.8
      vuepress: 2.0.0-rc.15(@vuepress/bundler-vite@2.0.0-rc.15)(vue@3.5.8)
      vuepress-shared: 2.0.0-rc.54(vuepress@2.0.0-rc.15)
    transitivePeerDependencies:
      - '@vue/composition-api'
      - typescript
    dev: true

  /vuepress-plugin-md-enhance@2.0.0-rc.54(markdown-it@14.1.0)(sass-embedded@1.79.3)(vuepress@2.0.0-rc.15):
    resolution: {integrity: sha512-/E/HibDXcjZDM89ABt9lT2aoJie6JMGry7vOaVdrSLeEm46vLrDvEQSPTgLKP0bugcN4AgNgHoV4OkQp4TWaFQ==}
    engines: {node: '>=18.19.0', npm: '>=8', pnpm: '>=7', yarn: '>=2'}
    peerDependencies:
      '@vue/repl': ^4.1.1
      chart.js: ^4.0.0
      echarts: ^5.0.0
      flowchart.ts: ^3.0.0
      kotlin-playground: ^1.23.0
      markmap-lib: ^0.17.0
      markmap-toolbar: ^0.17.0
      markmap-view: ^0.17.0
      mermaid: ^11.2.0
      sandpack-vue3: ^3.0.0
      sass: ^1.79.3
      sass-embedded: ^1.79.3
      sass-loader: ^16.0.2
      vuepress: 2.0.0-rc.15
    peerDependenciesMeta:
      '@vue/repl':
        optional: true
      chart.js:
        optional: true
      echarts:
        optional: true
      flowchart.ts:
        optional: true
      kotlin-playground:
        optional: true
      markmap-lib:
        optional: true
      markmap-toolbar:
        optional: true
      markmap-view:
        optional: true
      mermaid:
        optional: true
      sandpack-vue3:
        optional: true
      sass:
        optional: true
      sass-embedded:
        optional: true
      sass-loader:
        optional: true
    dependencies:
      '@mdit/plugin-alert': 0.13.1(markdown-it@14.1.0)
      '@mdit/plugin-align': 0.13.1(markdown-it@14.1.0)
      '@mdit/plugin-attrs': 0.13.1(markdown-it@14.1.0)
      '@mdit/plugin-container': 0.13.1(markdown-it@14.1.0)
      '@mdit/plugin-demo': 0.13.1(markdown-it@14.1.0)
      '@mdit/plugin-footnote': 0.13.1(markdown-it@14.1.0)
      '@mdit/plugin-include': 0.13.1(markdown-it@14.1.0)
      '@mdit/plugin-mark': 0.13.1(markdown-it@14.1.0)
      '@mdit/plugin-plantuml': 0.13.1(markdown-it@14.1.0)
      '@mdit/plugin-spoiler': 0.13.1(markdown-it@14.1.0)
      '@mdit/plugin-stylize': 0.13.1(markdown-it@14.1.0)
      '@mdit/plugin-sub': 0.13.1(markdown-it@14.1.0)
      '@mdit/plugin-sup': 0.13.1(markdown-it@14.1.0)
      '@mdit/plugin-tasklist': 0.13.1(markdown-it@14.1.0)
      '@mdit/plugin-uml': 0.13.1(markdown-it@14.1.0)
      '@types/markdown-it': 14.1.2
      '@vuepress/helper': 2.0.0-rc.47(vuepress@2.0.0-rc.15)
      '@vuepress/plugin-sass-palette': 2.0.0-rc.51(sass-embedded@1.79.3)(vuepress@2.0.0-rc.15)
      '@vueuse/core': 11.1.0(vue@3.5.8)
      balloon-css: 1.2.0
      js-yaml: 4.1.0
      sass-embedded: 1.79.3
      vue: 3.5.8
      vuepress: 2.0.0-rc.15(@vuepress/bundler-vite@2.0.0-rc.15)(vue@3.5.8)
      vuepress-shared: 2.0.0-rc.54(vuepress@2.0.0-rc.15)
    transitivePeerDependencies:
      - '@vue/composition-api'
      - markdown-it
      - typescript
    dev: true

  /vuepress-shared@2.0.0-rc.54(vuepress@2.0.0-rc.15):
    resolution: {integrity: sha512-Z+i/U6VtKteW5LhT3rvyGUjbhcimVf16QDIPw/g2kE6w94z332fcm/jlaokjFDBUiKRRSrbu74QSYZnwYGUdMQ==}
    engines: {node: '>=18.19.0', npm: '>=8', pnpm: '>=7', yarn: '>=2'}
    peerDependencies:
      vuepress: 2.0.0-rc.15
    dependencies:
      '@vuepress/helper': 2.0.0-rc.47(vuepress@2.0.0-rc.15)
      '@vueuse/core': 11.1.0(vue@3.5.8)
      dayjs: 1.11.13
      vue: 3.5.8
      vuepress: 2.0.0-rc.15(@vuepress/bundler-vite@2.0.0-rc.15)(vue@3.5.8)
    transitivePeerDependencies:
      - '@vue/composition-api'
      - typescript
    dev: true

  /vuepress-theme-hope@2.0.0-rc.56(@vuepress/plugin-redirect@2.0.0-rc.51)(markdown-it@14.1.0)(sass-embedded@1.79.3)(vuepress@2.0.0-rc.15):
    resolution: {integrity: sha512-dTNf/rbRwZiZGarRvv45cjGQcoDTksRfUA2W2/7cBeYRSDPX7YvLDpZSdEMj0DgserWmdbWQMGgy9sMLqvWJGA==}
    engines: {node: '>=18.19.0', npm: '>=8', pnpm: '>=7', yarn: '>=2'}
    peerDependencies:
      '@vuepress/plugin-docsearch': 2.0.0-rc.47
      '@vuepress/plugin-feed': 2.0.0-rc.47
      '@vuepress/plugin-prismjs': 2.0.0-rc.49
      '@vuepress/plugin-pwa': 2.0.0-rc.47
      '@vuepress/plugin-redirect': 2.0.0-rc.51
      '@vuepress/plugin-revealjs': 2.0.0-rc.48
      '@vuepress/plugin-search': 2.0.0-rc.47
      nodejs-jieba: ^0.1.2
      sass: ^1.79.3
      sass-embedded: ^1.79.3
      sass-loader: ^16.0.2
      vuepress: 2.0.0-rc.15
      vuepress-plugin-search-pro: 2.0.0-rc.54
    peerDependenciesMeta:
      '@vuepress/plugin-docsearch':
        optional: true
      '@vuepress/plugin-feed':
        optional: true
      '@vuepress/plugin-prismjs':
        optional: true
      '@vuepress/plugin-pwa':
        optional: true
      '@vuepress/plugin-redirect':
        optional: true
      '@vuepress/plugin-revealjs':
        optional: true
      '@vuepress/plugin-search':
        optional: true
      nodejs-jieba:
        optional: true
      sass:
        optional: true
      sass-embedded:
        optional: true
      sass-loader:
        optional: true
      vuepress-plugin-search-pro:
        optional: true
    dependencies:
      '@vuepress/helper': 2.0.0-rc.47(vuepress@2.0.0-rc.15)
      '@vuepress/plugin-active-header-links': 2.0.0-rc.47(vuepress@2.0.0-rc.15)
      '@vuepress/plugin-back-to-top': 2.0.0-rc.47(vuepress@2.0.0-rc.15)
      '@vuepress/plugin-blog': 2.0.0-rc.47(vuepress@2.0.0-rc.15)
      '@vuepress/plugin-catalog': 2.0.0-rc.47(vuepress@2.0.0-rc.15)
      '@vuepress/plugin-comment': 2.0.0-rc.47(vuepress@2.0.0-rc.15)
      '@vuepress/plugin-copy-code': 2.0.0-rc.47(vuepress@2.0.0-rc.15)
      '@vuepress/plugin-copyright': 2.0.0-rc.47(vuepress@2.0.0-rc.15)
      '@vuepress/plugin-git': 2.0.0-rc.44(vuepress@2.0.0-rc.15)
      '@vuepress/plugin-links-check': 2.0.0-rc.47(vuepress@2.0.0-rc.15)
      '@vuepress/plugin-markdown-hint': 2.0.0-rc.47(markdown-it@14.1.0)(vue@3.5.8)(vuepress@2.0.0-rc.15)
      '@vuepress/plugin-markdown-image': 2.0.0-rc.47(markdown-it@14.1.0)(vuepress@2.0.0-rc.15)
      '@vuepress/plugin-markdown-math': 2.0.0-rc.49(markdown-it@14.1.0)(vuepress@2.0.0-rc.15)
      '@vuepress/plugin-markdown-tab': 2.0.0-rc.47(markdown-it@14.1.0)(vuepress@2.0.0-rc.15)
      '@vuepress/plugin-notice': 2.0.0-rc.47(vuepress@2.0.0-rc.15)
      '@vuepress/plugin-nprogress': 2.0.0-rc.47(vuepress@2.0.0-rc.15)
      '@vuepress/plugin-photo-swipe': 2.0.0-rc.47(vuepress@2.0.0-rc.15)
      '@vuepress/plugin-reading-time': 2.0.0-rc.47(vuepress@2.0.0-rc.15)
      '@vuepress/plugin-redirect': 2.0.0-rc.51(vuepress@2.0.0-rc.15)
      '@vuepress/plugin-rtl': 2.0.0-rc.47(vuepress@2.0.0-rc.15)
      '@vuepress/plugin-sass-palette': 2.0.0-rc.51(sass-embedded@1.79.3)(vuepress@2.0.0-rc.15)
      '@vuepress/plugin-seo': 2.0.0-rc.47(vuepress@2.0.0-rc.15)
      '@vuepress/plugin-shiki': 2.0.0-rc.47(@vueuse/core@11.1.0)(vuepress@2.0.0-rc.15)
      '@vuepress/plugin-sitemap': 2.0.0-rc.47(vuepress@2.0.0-rc.15)
      '@vuepress/plugin-theme-data': 2.0.0-rc.47(vuepress@2.0.0-rc.15)
      '@vuepress/plugin-watermark': 2.0.0-rc.47(vuepress@2.0.0-rc.15)
      '@vueuse/core': 11.1.0(vue@3.5.8)
      balloon-css: 1.2.0
      bcrypt-ts: 5.0.2
      chokidar: 3.6.0
      sass-embedded: 1.79.3
      vue: 3.5.8
      vuepress: 2.0.0-rc.15(@vuepress/bundler-vite@2.0.0-rc.15)(vue@3.5.8)
      vuepress-plugin-components: 2.0.0-rc.54(sass-embedded@1.79.3)(vuepress@2.0.0-rc.15)
      vuepress-plugin-md-enhance: 2.0.0-rc.54(markdown-it@14.1.0)(sass-embedded@1.79.3)(vuepress@2.0.0-rc.15)
      vuepress-shared: 2.0.0-rc.54(vuepress@2.0.0-rc.15)
    transitivePeerDependencies:
      - '@vue/composition-api'
      - '@vue/repl'
      - '@waline/client'
      - artalk
      - artplayer
      - chart.js
      - dashjs
      - echarts
      - flowchart.ts
      - hls.js
      - katex
      - kotlin-playground
      - markdown-it
      - markmap-lib
      - markmap-toolbar
      - markmap-view
      - mathjax-full
      - mermaid
      - mpegts.js
      - sandpack-vue3
      - twikoo
      - typescript
      - vidstack
    dev: true

  /vuepress@2.0.0-rc.15(@vuepress/bundler-vite@2.0.0-rc.15)(vue@3.5.8):
    resolution: {integrity: sha512-8DRaONwIaG0Jn3P8OKBysTfcO1yPO1UwfUUNQjbToLrbYSsGFiFwpuTMSL3HbdaX7ou6TuJHgK/wuslsUV8jCQ==}
    engines: {node: '>=18.16.0'}
    hasBin: true
    peerDependencies:
      '@vuepress/bundler-vite': 2.0.0-rc.15
      '@vuepress/bundler-webpack': 2.0.0-rc.15
      vue: ^3.4.0
    peerDependenciesMeta:
      '@vuepress/bundler-vite':
        optional: true
      '@vuepress/bundler-webpack':
        optional: true
    dependencies:
      '@vuepress/bundler-vite': 2.0.0-rc.15(sass-embedded@1.79.3)
      '@vuepress/cli': 2.0.0-rc.15
      '@vuepress/client': 2.0.0-rc.15
      '@vuepress/core': 2.0.0-rc.15
      '@vuepress/markdown': 2.0.0-rc.15
      '@vuepress/shared': 2.0.0-rc.15
      '@vuepress/utils': 2.0.0-rc.15
      vue: 3.5.8
    transitivePeerDependencies:
      - supports-color
      - typescript
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
