KotoriProject/CherryDAP/projects/HSLink-Pro/src/DAP_config.h

/*
 * Copyright (c) 2013-2021 ARM Limited. All rights reserved.
 *
 * SPDX-License-Identifier: Apache-2.0
 *
 * Licensed under the Apache License, Version 2.0 (the License); you may
 * not use this file except in compliance with the License.
 * You may obtain a copy of the License at
 *
 * www.apache.org/licenses/LICENSE-2.0
 *
 * Unless required by applicable law or agreed to in writing, software
 * distributed under the License is distributed on an AS IS BASIS, WITHOUT
 * WARRANTIES OR CONDITIONS OF ANY KIND, either express or implied.
 * See the License for the specific language governing permissions and
 * limitations under the License.
 *
 * ----------------------------------------------------------------------
 *
 * $Date:        16. June 2021
 * $Revision:    V2.1.0
 *
 * Project:      CMSIS-DAP Configuration
 * Title:        DAP_config.h CMSIS-DAP Configuration File (Template)
 *
 *---------------------------------------------------------------------------*/

#ifndef __DAP_CONFIG_H__
#define __DAP_CONFIG_H__


//**************************************************************************************************
/**
\defgroup DAP_Config_Debug_gr CMSIS-DAP Debug Unit Information
\ingroup DAP_ConfigIO_gr
@{
Provides definitions about the hardware and configuration of the Debug Unit.

This information includes:
 - Definition of Cortex-M processor parameters used in CMSIS-DAP Debug Unit.
 - Debug Unit Identification strings (Vendor, Product, Serial Number).
 - Debug Unit communication packet size.
 - Debug Access Port supported modes and settings (JTAG/SWD and SWO).
 - Optional information about a connected Target Device (for Evaluation Boards).
*/

#include <stdio.h>
#include <hpm_romapi.h>
#include <WS2812.h>
#include "stdint.h"

#ifndef   __STATIC_INLINE
#define __STATIC_INLINE                        static inline
#endif
#ifndef   __STATIC_FORCEINLINE                 
#define __STATIC_FORCEINLINE                   __attribute__((always_inline)) static inline
#endif
#ifndef __WEAK
#define __WEAK __attribute__((weak))
#endif

/// Processor Clock of the Cortex-M MCU used in the Debug Unit.
/// This value is used to calculate the SWD/JTAG clock speed.
#define CPU_CLOCK               36000000U      ///< Specifies the CPU Clock in Hz.

/// Number of processor cycles for I/O Port write operations.
/// This value is used to calculate the SWD/JTAG clock speed that is generated with I/O
/// Port write operations in the Debug Unit by a Cortex-M MCU. Most Cortex-M processors
/// require 2 processor cycles for a I/O Port Write operation.  If the Debug Unit uses
/// a Cortex-M0+ processor with high-speed peripheral I/O only 1 processor cycle might be
/// required.
#define IO_PORT_WRITE_CYCLES    1U              ///< I/O Cycles: 2=default, 1=Cortex-M0+ fast I/0.

/// Indicate that Serial Wire Debug (SWD) communication mode is available at the Debug Access Port.
/// This information is returned by the command \ref DAP_Info as part of <b>Capabilities</b>.
#define DAP_SWD                 1               ///< SWD Mode:  1 = available, 0 = not available.

/// Indicate that JTAG communication mode is available at the Debug Port.
/// This information is returned by the command \ref DAP_Info as part of <b>Capabilities</b>.
#define DAP_JTAG                1               ///< JTAG Mode: 1 = available, 0 = not available.

/// Configure maximum number of JTAG devices on the scan chain connected to the Debug Access Port.
/// This setting impacts the RAM requirements of the Debug Unit. Valid range is 1 .. 255.
#define DAP_JTAG_DEV_CNT        8U              ///< Maximum number of JTAG devices on scan chain.

/// Default communication mode on the Debug Access Port.
/// Used for the command \ref DAP_Connect when Port Default mode is selected.
#define DAP_DEFAULT_PORT        1U              ///< Default JTAG/SWJ Port Mode: 1 = SWD, 2 = JTAG.

/// Default communication speed on the Debug Access Port for SWD and JTAG mode.
/// Used to initialize the default SWD/JTAG clock frequency.
/// The command \ref DAP_SWJ_Clock can be used to overwrite this default setting.
#define DAP_DEFAULT_SWJ_CLOCK   10000000U        ///< Default SWD/JTAG clock frequency in Hz.

/// Maximum Package Size for Command and Response data.
/// This configuration settings is used to optimize the communication performance with the
/// debugger and depends on the USB peripheral. Typical vales are 64 for Full-speed USB HID or WinUSB,
/// 1024 for High-speed USB HID and 512 for High-speed USB WinUSB.
#define DAP_PACKET_SIZE         512U            ///< Specifies Packet Size in bytes.

/// Maximum Package Buffers for Command and Response data.
/// This configuration settings is used to optimize the communication performance with the
/// debugger and depends on the USB peripheral. For devices with limited RAM or USB buffer the
/// setting can be reduced (valid range is 1 .. 255).
#define DAP_PACKET_COUNT        8U              ///< Specifies number of packets buffered.

/// Indicate that UART Serial Wire Output (SWO) trace is available.
/// This information is returned by the command \ref DAP_Info as part of <b>Capabilities</b>.
#define SWO_UART                0               ///< SWO UART:  1 = available, 0 = not available.

/// USART Driver instance number for the UART SWO.
#define SWO_UART_DRIVER         0               ///< USART Driver instance number (Driver_USART#).

/// Maximum SWO UART Baudrate.
#define SWO_UART_MAX_BAUDRATE   10000000U       ///< SWO UART Maximum Baudrate in Hz.

/// Indicate that Manchester Serial Wire Output (SWO) trace is available.
/// This information is returned by the command \ref DAP_Info as part of <b>Capabilities</b>.
#define SWO_MANCHESTER          0               ///< SWO Manchester:  1 = available, 0 = not available.

/// SWO Trace Buffer Size.
#define SWO_BUFFER_SIZE         4096U           ///< SWO Trace Buffer Size in bytes (must be 2^n).

/// SWO Streaming Trace.
#define SWO_STREAM              0               ///< SWO Streaming Trace: 1 = available, 0 = not available.

/// Clock frequency of the Test Domain Timer. Timer value is returned with \ref TIMESTAMP_GET.
#define TIMESTAMP_CLOCK         100000000U      ///< Timestamp clock in Hz (0 = timestamps not supported).

/// Indicate that UART Communication Port is available.
/// This information is returned by the command \ref DAP_Info as part of <b>Capabilities</b>.
#define DAP_UART                0               ///< DAP UART:  1 = available, 0 = not available.

/// USART Driver instance number for the UART Communication Port.
#define DAP_UART_DRIVER         1               ///< USART Driver instance number (Driver_USART#).

/// UART Receive Buffer Size.
#define DAP_UART_RX_BUFFER_SIZE 1024U           ///< Uart Receive Buffer Size in bytes (must be 2^n).

/// UART Transmit Buffer Size.
#define DAP_UART_TX_BUFFER_SIZE 1024U           ///< Uart Transmit Buffer Size in bytes (must be 2^n).

/// Indicate that UART Communication via USB COM Port is available.
/// This information is returned by the command \ref DAP_Info as part of <b>Capabilities</b>.
#define DAP_UART_USB_COM_PORT   1               ///< USB COM Port:  1 = available, 0 = not available.


/// Debug Unit is connected to fixed Target Device.
/// The Debug Unit may be part of an evaluation board and always connected to a fixed
/// known device. In this case a Device Vendor, Device Name, Board Vendor and Board Name strings
/// are stored and may be used by the debugger or IDE to configure device parameters.
#define TARGET_FIXED            0               ///< Target: 1 = known, 0 = unknown;

#define TARGET_DEVICE_VENDOR    "Arm"           ///< String indicating the Silicon Vendor
#define TARGET_DEVICE_NAME      "Cortex-M"      ///< String indicating the Target Device
#define TARGET_BOARD_VENDOR     "Arm"           ///< String indicating the Board Vendor
#define TARGET_BOARD_NAME       "Arm board"     ///< String indicating the Board Name

#if TARGET_FIXED != 0
#include <string.h>
static const char TargetDeviceVendor [] = TARGET_DEVICE_VENDOR;
static const char TargetDeviceName   [] = TARGET_DEVICE_NAME;
static const char TargetBoardVendor  [] = TARGET_BOARD_VENDOR;
static const char TargetBoardName    [] = TARGET_BOARD_NAME;
#endif

/** Get Vendor Name string.
\param str Pointer to buffer to store the string (max 60 characters).
\return String length (including terminating NULL character) or 0 (no string).
*/
__STATIC_INLINE uint8_t DAP_GetVendorString (char *str) {
    const char vendor[] = "CherryUSB";
    uint8_t len = (uint8_t)strlen(vendor);
    memcpy(str, vendor, len);
    return len;
}

/** Get Product Name string.
\param str Pointer to buffer to store the string (max 60 characters).
\return String length (including terminating NULL character) or 0 (no string).
*/
__STATIC_INLINE uint8_t DAP_GetProductString (char *str) {
    const char product[] = "Cherry CMSIS-DAP";
    uint8_t len = (uint8_t)strlen(product);
    memcpy(str, product, len);
    return len;
}

/** Get Serial Number string.
\param str Pointer to buffer to store the string (max 60 characters).
\return String length (including terminating NULL character) or 0 (no string).
*/
__STATIC_INLINE uint8_t DAP_GetSerNumString (char *str) {
    (void)str;
    return (0U);
}

/** Get Target Device Vendor string.
\param str Pointer to buffer to store the string (max 60 characters).
\return String length (including terminating NULL character) or 0 (no string).
*/
__STATIC_INLINE uint8_t DAP_GetTargetDeviceVendorString (char *str) {
#if TARGET_FIXED != 0
  uint8_t len;

  strcpy(str, TargetDeviceVendor);
  len = (uint8_t)(strlen(TargetDeviceVendor) + 1U);
  return (len);
#else
  (void)str;
  return (0U);
#endif
}

/** Get Target Device Name string.
\param str Pointer to buffer to store the string (max 60 characters).
\return String length (including terminating NULL character) or 0 (no string).
*/
__STATIC_INLINE uint8_t DAP_GetTargetDeviceNameString (char *str) {
#if TARGET_FIXED != 0
  uint8_t len;

  strcpy(str, TargetDeviceName);
  len = (uint8_t)(strlen(TargetDeviceName) + 1U);
  return (len);
#else
  (void)str;
  return (0U);
#endif
}

/** Get Target Board Vendor string.
\param str Pointer to buffer to store the string (max 60 characters).
\return String length (including terminating NULL character) or 0 (no string).
*/
__STATIC_INLINE uint8_t DAP_GetTargetBoardVendorString (char *str) {
#if TARGET_FIXED != 0
  uint8_t len;

  strcpy(str, TargetBoardVendor);
  len = (uint8_t)(strlen(TargetBoardVendor) + 1U);
  return (len);
#else
  (void)str;
  return (0U);
#endif
}

/** Get Target Board Name string.
\param str Pointer to buffer to store the string (max 60 characters).
\return String length (including terminating NULL character) or 0 (no string).
*/
__STATIC_INLINE uint8_t DAP_GetTargetBoardNameString (char *str) {
#if TARGET_FIXED != 0
  uint8_t len;

  strcpy(str, TargetBoardName);
  len = (uint8_t)(strlen(TargetBoardName) + 1U);
  return (len);
#else
  (void)str;
  return (0U);
#endif
}

/** Get Product Firmware Version string.
\param str Pointer to buffer to store the string (max 60 characters).
\return String length (including terminating NULL character) or 0 (no string).
*/
__STATIC_INLINE uint8_t DAP_GetProductFirmwareVersionString (char *str) {
    const char version[] = CONFIG_BUILD_VERSION;
    uint8_t len = (uint8_t)strlen(version);
    memcpy(str, version, len);
    return len;
}

///@}

#include "hpm_gpio_drv.h"
#include "hpm_gpiom_regs.h"
#include "hpm_gpiom_drv.h"
#include "hpm_soc.h"
#include "hpm_csr_drv.h"
#include "hpm_clock_drv.h"

#define JTAG_SPI_BASE               HPM_SPI2
#define JTAG_SPI_BASE_CLOCK_NAME    clock_spi2

#define SWD_SPI_BASE               HPM_SPI1
#define SWD_SPI_BASE_CLOCK_NAME    clock_spi1

#define PIN_GPIOM_BASE    HPM_GPIOM
#define PIN_GPIO          HPM_GPIO0
#define PIN_SWDIO_DIR_GPIO HPM_GPIO0

#if defined(USE_HPM_BOARD_JTAG_GPIO) && (USE_HPM_BOARD_JTAG_GPIO == 1)
    #define PIN_TCK                         IOC_PAD_PA06
    #define PIN_TMS                         IOC_PAD_PA07
    #define PIN_TDI                         IOC_PAD_PA05
    #define PIN_TDO                         IOC_PAD_PA04
#else
    #define PIN_TCK           IOC_PAD_PB11
    #define PIN_TMS           IOC_PAD_PA29
    #define PIN_TDI           IOC_PAD_PB13
    #define PIN_TDO           IOC_PAD_PB12
#endif

typedef enum {
    PORT_MODE_GPIO = 0,
    PORT_MODE_SPI = 1,
}PORT_Mode_t;

extern PORT_Mode_t SWD_Port_Mode;
extern PORT_Mode_t JTAG_Port_Mode;

//**************************************************************************************************
/**
\defgroup DAP_Config_PortIO_gr CMSIS-DAP Hardware I/O Pin Access
\ingroup DAP_ConfigIO_gr
@{

Standard I/O Pins of the CMSIS-DAP Hardware Debug Port support standard JTAG mode
and Serial Wire Debug (SWD) mode. In SWD mode only 2 pins are required to implement the debug
interface of a device. The following I/O Pins are provided:

JTAG I/O Pin                 | SWD I/O Pin          | CMSIS-DAP Hardware pin mode
---------------------------- | -------------------- | ---------------------------------------------
TCK: Test Clock              | SWCLK: Clock         | Output Push/Pull
TMS: Test Mode Select        | SWDIO: Data I/O      | Output Push/Pull; Input (for receiving data)
TDI: Test Data Input         |                      | Output Push/Pull
TDO: Test Data Output        |                      | Input
nTRST: Test Reset (optional) |                      | Output Open Drain with pull-up resistor
nRESET: Device Reset         | nRESET: Device Reset | Output Open Drain with pull-up resistor


DAP Hardware I/O Pin Access Functions
-------------------------------------
The various I/O Pins are accessed by functions that implement the Read, Write, Set, or Clear to
these I/O Pins.

For the SWDIO I/O Pin there are additional functions that are called in SWD I/O mode only.
This functions are provided to achieve faster I/O that is possible with some advanced GPIO
peripherals that can independently write/read a single I/O pin without affecting any other pins
of the same I/O port. The following SWDIO I/O Pin functions are provided:
 - \ref PIN_SWDIO_OUT_ENABLE to enable the output mode from the DAP hardware.
 - \ref PIN_SWDIO_OUT_DISABLE to enable the input mode to the DAP hardware.
 - \ref PIN_SWDIO_IN to read from the SWDIO I/O pin with utmost possible speed.
 - \ref PIN_SWDIO_OUT to write to the SWDIO I/O pin with utmost possible speed.
*/


// Configure DAP I/O pins ------------------------------

/** Setup JTAG I/O pins: TCK, TMS, TDI, TDO, nTRST, and nRESET.
Configures the DAP Hardware I/O pins for JTAG mode:
 - TCK, TMS, TDI, nTRST, nRESET to output mode and set to high level.
 - TDO to input mode.
*/
__STATIC_INLINE void gpiom_configure_pin_control_setting(uint16_t gpio_index)
{
    gpiom_set_pin_controller(PIN_GPIOM_BASE, GPIO_GET_PORT_INDEX(gpio_index), GPIO_GET_PIN_INDEX(gpio_index), gpiom_soc_gpio0);
    gpiom_enable_pin_visibility(PIN_GPIOM_BASE, GPIO_GET_PORT_INDEX(gpio_index), GPIO_GET_PIN_INDEX(gpio_index), gpiom_soc_gpio0);
//    gpiom_lock_pin(PIN_GPIOM_BASE, GPIO_GET_PORT_INDEX(gpio_index), GPIO_GET_PIN_INDEX(gpio_index));
}

void PORT_JTAG_SETUP(void);

/** Setup SWD I/O pins: SWCLK, SWDIO, and nRESET.
Configures the DAP Hardware I/O pins for Serial Wire Debug (SWD) mode:
 - SWCLK, SWDIO, nRESET to output mode and set to default high level.
 - TDI, nTRST to HighZ mode (pins are unused in SWD mode).
*/
void PORT_SWD_SETUP(void);

/** Disable JTAG/SWD I/O Pins.
Disables the DAP Hardware I/O pins which configures:
 - TCK/SWCLK, TMS/SWDIO, TDI, TDO, nTRST, nRESET to High-Z mode.
*/
__STATIC_INLINE void PORT_OFF (void) {
    HPM_IOC->PAD[PIN_TCK].PAD_CTL = IOC_PAD_PAD_CTL_PRS_SET(2);
    HPM_IOC->PAD[PIN_TCK].FUNC_CTL = IOC_PAD_FUNC_CTL_ALT_SELECT_SET(0);

    HPM_IOC->PAD[PIN_TMS].PAD_CTL = IOC_PAD_PAD_CTL_PRS_SET(2);
    HPM_IOC->PAD[PIN_TMS].FUNC_CTL = IOC_PAD_FUNC_CTL_ALT_SELECT_SET(0);

    HPM_IOC->PAD[PIN_TDI].PAD_CTL = IOC_PAD_PAD_CTL_PRS_SET(2);
    HPM_IOC->PAD[PIN_TDI].FUNC_CTL = IOC_PAD_FUNC_CTL_ALT_SELECT_SET(0);

    HPM_IOC->PAD[PIN_TDO].PAD_CTL = IOC_PAD_PAD_CTL_PRS_SET(2);
    HPM_IOC->PAD[PIN_TDO].FUNC_CTL = IOC_PAD_FUNC_CTL_ALT_SELECT_SET(0);

    HPM_IOC->PAD[PIN_SRST].PAD_CTL = IOC_PAD_PAD_CTL_PRS_SET(2);
    HPM_IOC->PAD[PIN_SRST].FUNC_CTL = IOC_PAD_FUNC_CTL_ALT_SELECT_SET(0);

    HPM_IOC->PAD[PIN_JTAG_TRST].PAD_CTL = IOC_PAD_PAD_CTL_PRS_SET(2);
    HPM_IOC->PAD[PIN_JTAG_TRST].FUNC_CTL = IOC_PAD_FUNC_CTL_ALT_SELECT_SET(0);

    HPM_IOC->PAD[IOC_PAD_PA27].PAD_CTL = IOC_PAD_PAD_CTL_PRS_SET(2);
    HPM_IOC->PAD[IOC_PAD_PA27].FUNC_CTL = IOC_PAD_FUNC_CTL_ALT_SELECT_SET(0); // SWD SPI SCLK
    gpio_set_pin_input(PIN_GPIO, GPIO_GET_PORT_INDEX(IOC_PAD_PA27), GPIO_GET_PIN_INDEX(IOC_PAD_PA27));
    gpio_disable_pin_interrupt(PIN_GPIO, GPIO_GET_PORT_INDEX(IOC_PAD_PA27), GPIO_GET_PIN_INDEX(IOC_PAD_PA27));
    gpiom_set_pin_controller(HPM_GPIOM, GPIO_GET_PORT_INDEX(IOC_PAD_PA27), GPIO_GET_PIN_INDEX(IOC_PAD_PA27), gpiom_soc_gpio0);

    gpio_set_pin_input(PIN_GPIO, GPIO_GET_PORT_INDEX(PIN_TCK), GPIO_GET_PIN_INDEX(PIN_TCK));
    gpio_disable_pin_interrupt(PIN_GPIO, GPIO_GET_PORT_INDEX(PIN_TCK), GPIO_GET_PIN_INDEX(PIN_TCK));
    gpiom_set_pin_controller(HPM_GPIOM, GPIO_GET_PORT_INDEX(PIN_TCK), GPIO_GET_PIN_INDEX(PIN_TCK), gpiom_soc_gpio0);

    gpio_set_pin_input(PIN_GPIO, GPIO_GET_PORT_INDEX(PIN_TMS), GPIO_GET_PIN_INDEX(PIN_TMS));
    gpio_disable_pin_interrupt(PIN_GPIO, GPIO_GET_PORT_INDEX(PIN_TMS), GPIO_GET_PIN_INDEX(PIN_TMS));
    gpiom_set_pin_controller(HPM_GPIOM, GPIO_GET_PORT_INDEX(PIN_TMS), GPIO_GET_PIN_INDEX(PIN_TMS), gpiom_soc_gpio0);

    gpio_set_pin_input(PIN_GPIO, GPIO_GET_PORT_INDEX(PIN_TDI), GPIO_GET_PIN_INDEX(PIN_TDI));
    gpio_disable_pin_interrupt(PIN_GPIO, GPIO_GET_PORT_INDEX(PIN_TDI), GPIO_GET_PIN_INDEX(PIN_TDI));
    gpiom_set_pin_controller(HPM_GPIOM, GPIO_GET_PORT_INDEX(PIN_TDI), GPIO_GET_PIN_INDEX(PIN_TDI), gpiom_soc_gpio0);

    gpio_set_pin_input(PIN_GPIO, GPIO_GET_PORT_INDEX(PIN_TDO), GPIO_GET_PIN_INDEX(PIN_TDO));
    gpio_disable_pin_interrupt(PIN_GPIO, GPIO_GET_PORT_INDEX(PIN_TDO), GPIO_GET_PIN_INDEX(PIN_TDO));
    gpiom_set_pin_controller(HPM_GPIOM, GPIO_GET_PORT_INDEX(PIN_TDO), GPIO_GET_PIN_INDEX(PIN_TDO), gpiom_soc_gpio0);

    gpio_set_pin_input(PIN_GPIO, GPIO_GET_PORT_INDEX(PIN_SRST), GPIO_GET_PIN_INDEX(PIN_SRST));
    gpio_disable_pin_interrupt(PIN_GPIO, GPIO_GET_PORT_INDEX(PIN_SRST), GPIO_GET_PIN_INDEX(PIN_SRST));
    gpiom_set_pin_controller(HPM_GPIOM, GPIO_GET_PORT_INDEX(PIN_SRST), GPIO_GET_PIN_INDEX(PIN_SRST), gpiom_soc_gpio0);

    gpio_set_pin_input(PIN_GPIO, GPIO_GET_PORT_INDEX(PIN_JTAG_TRST), GPIO_GET_PIN_INDEX(PIN_JTAG_TRST));
    gpio_disable_pin_interrupt(PIN_GPIO, GPIO_GET_PORT_INDEX(PIN_JTAG_TRST), GPIO_GET_PIN_INDEX(PIN_JTAG_TRST));
    gpiom_set_pin_controller(HPM_GPIOM, GPIO_GET_PORT_INDEX(PIN_JTAG_TRST), GPIO_GET_PIN_INDEX(PIN_JTAG_TRST), gpiom_soc_gpio0);
}


// SWCLK/TCK I/O pin -------------------------------------

/** SWCLK/TCK I/O pin: Get Input.
\return Current status of the SWCLK/TCK DAP hardware I/O pin.
*/
__STATIC_FORCEINLINE uint32_t PIN_SWCLK_TCK_IN  (void) {
    uint32_t sta =  gpio_read_pin(PIN_GPIO, GPIO_GET_PORT_INDEX(PIN_TCK), GPIO_GET_PIN_INDEX(PIN_TCK));
    __asm volatile("fence io, io");
    return sta;
}

/** SWCLK/TCK I/O pin: Set Output to High
Set the SWCLK/TCK DAP hardware I/O pin to high level.;
*/
__STATIC_FORCEINLINE void     PIN_SWCLK_TCK_SET (void) {
    gpio_write_pin(PIN_GPIO, GPIO_GET_PORT_INDEX(PIN_TCK), GPIO_GET_PIN_INDEX(PIN_TCK), true);
    __asm volatile("fence io, io");
}

/** SWCLK/TCK I/O pin: Set Output to Low.
Set the SWCLK/TCK DAP hardware I/O pin to low level.
*/
__STATIC_FORCEINLINE void     PIN_SWCLK_TCK_CLR (void) {
    gpio_write_pin(PIN_GPIO, GPIO_GET_PORT_INDEX(PIN_TCK), GPIO_GET_PIN_INDEX(PIN_TCK), false);
    __asm volatile("fence io, io");
}


// SWDIO/TMS Pin I/O --------------------------------------

/** SWDIO/TMS I/O pin: Get Input.
\return Current status of the SWDIO/TMS DAP hardware I/O pin.
*/
__STATIC_FORCEINLINE uint32_t PIN_SWDIO_TMS_IN  (void) {
    gpio_write_pin(PIN_SWDIO_DIR_GPIO, GPIO_GET_PORT_INDEX(SWDIO_DIR), GPIO_GET_PIN_INDEX(SWDIO_DIR), 0);
    uint32_t sta =  gpio_read_pin(PIN_GPIO, GPIO_GET_PORT_INDEX(PIN_TMS), GPIO_GET_PIN_INDEX(PIN_TMS));
    __asm volatile("fence io, io");
    return sta;
}

/** SWDIO/TMS I/O pin: Set Output to High.
Set the SWDIO/TMS DAP hardware I/O pin to high level.
*/
__STATIC_FORCEINLINE void     PIN_SWDIO_TMS_SET (void) {
    gpio_write_pin(PIN_SWDIO_DIR_GPIO, GPIO_GET_PORT_INDEX(SWDIO_DIR), GPIO_GET_PIN_INDEX(SWDIO_DIR), 1);
    gpio_write_pin(PIN_GPIO, GPIO_GET_PORT_INDEX(PIN_TMS), GPIO_GET_PIN_INDEX(PIN_TMS), true);
    __asm volatile("fence io, io");
}

/** SWDIO/TMS I/O pin: Set Output to Low.
Set the SWDIO/TMS DAP hardware I/O pin to low level.
*/
__STATIC_FORCEINLINE void     PIN_SWDIO_TMS_CLR (void) {
    gpio_write_pin(PIN_SWDIO_DIR_GPIO, GPIO_GET_PORT_INDEX(SWDIO_DIR), GPIO_GET_PIN_INDEX(SWDIO_DIR), 1);
    gpio_write_pin(PIN_GPIO, GPIO_GET_PORT_INDEX(PIN_TMS), GPIO_GET_PIN_INDEX(PIN_TMS), false);
    __asm volatile("fence io, io");
}

/** SWDIO I/O pin: Get Input (used in SWD mode only).
\return Current status of the SWDIO DAP hardware I/O pin.
*/
__STATIC_FORCEINLINE uint32_t PIN_SWDIO_IN      (void) {
    gpio_write_pin(PIN_SWDIO_DIR_GPIO, GPIO_GET_PORT_INDEX(SWDIO_DIR), GPIO_GET_PIN_INDEX(SWDIO_DIR), 0);
    uint32_t sta =  gpio_read_pin(PIN_GPIO, GPIO_GET_PORT_INDEX(PIN_TMS), GPIO_GET_PIN_INDEX(PIN_TMS));
    __asm volatile("fence io, io");
    return sta;
}

/** SWDIO I/O pin: Set Output (used in SWD mode only).
\param bit Output value for the SWDIO DAP hardware I/O pin.
*/
__STATIC_FORCEINLINE void     PIN_SWDIO_OUT     (uint32_t bit) {
    gpio_write_pin(PIN_SWDIO_DIR_GPIO, GPIO_GET_PORT_INDEX(SWDIO_DIR), GPIO_GET_PIN_INDEX(SWDIO_DIR), 1);
  if(bit & 0x01) {
     gpio_write_pin(PIN_GPIO, GPIO_GET_PORT_INDEX(PIN_TMS), GPIO_GET_PIN_INDEX(PIN_TMS), true);
  }
  else {
    gpio_write_pin(PIN_GPIO, GPIO_GET_PORT_INDEX(PIN_TMS), GPIO_GET_PIN_INDEX(PIN_TMS), false);
  }
  __asm volatile("fence io, io");
}

/** SWDIO I/O pin: Switch to Output mode (used in SWD mode only).
Configure the SWDIO DAP hardware I/O pin to output mode. This function is
called prior \ref PIN_SWDIO_OUT function calls.
*/
__STATIC_FORCEINLINE void     PIN_SWDIO_OUT_ENABLE  (void) {
    gpio_write_pin(PIN_SWDIO_DIR_GPIO, GPIO_GET_PORT_INDEX(SWDIO_DIR), GPIO_GET_PIN_INDEX(SWDIO_DIR), 1);
  HPM_IOC->PAD[PIN_TMS].FUNC_CTL = IOC_PAD_FUNC_CTL_ALT_SELECT_SET(0); /* as gpio*/
  HPM_IOC->PAD[PIN_TMS].PAD_CTL = IOC_PAD_PAD_CTL_PRS_SET(2) | IOC_PAD_PAD_CTL_PE_SET(1) | IOC_PAD_PAD_CTL_PS_SET(1);
  gpiom_configure_pin_control_setting(PIN_TMS);
  gpio_set_pin_output(PIN_GPIO, GPIO_GET_PORT_INDEX(PIN_TMS), GPIO_GET_PIN_INDEX(PIN_TMS));
}

/** SWDIO I/O pin: Switch to Input mode (used in SWD mode only).
Configure the SWDIO DAP hardware I/O pin to input mode. This function is
called prior \ref PIN_SWDIO_IN function calls.
*/
__STATIC_FORCEINLINE void     PIN_SWDIO_OUT_DISABLE (void) {
    gpio_write_pin(PIN_SWDIO_DIR_GPIO, GPIO_GET_PORT_INDEX(SWDIO_DIR), GPIO_GET_PIN_INDEX(SWDIO_DIR), 0);
    HPM_IOC->PAD[PIN_TMS].PAD_CTL = IOC_PAD_PAD_CTL_PRS_SET(2);
    HPM_IOC->PAD[PIN_TMS].FUNC_CTL = IOC_PAD_FUNC_CTL_ALT_SELECT_SET(0);
    gpio_set_pin_input(PIN_GPIO, GPIO_GET_PORT_INDEX(PIN_TMS), GPIO_GET_PIN_INDEX(PIN_TMS));
    gpio_disable_pin_interrupt(PIN_GPIO, GPIO_GET_PORT_INDEX(PIN_TMS), GPIO_GET_PIN_INDEX(PIN_TMS));
    gpiom_set_pin_controller(HPM_GPIOM, GPIO_GET_PORT_INDEX(PIN_TMS), GPIO_GET_PIN_INDEX(PIN_TMS), gpiom_soc_gpio0);
}


// TDI Pin I/O ---------------------------------------------

/** TDI I/O pin: Get Input.
\return Current status of the TDI DAP hardware I/O pin.
*/
__STATIC_FORCEINLINE uint32_t PIN_TDI_IN  (void) {
    uint32_t sta =  gpio_read_pin(PIN_GPIO, GPIO_GET_PORT_INDEX(PIN_TDI), GPIO_GET_PIN_INDEX(PIN_TDI));
    __asm volatile("fence io, io");
    return sta;
}

/** TDI I/O pin: Set Output.
\param bit Output value for the TDI DAP hardware I/O pin.
*/
__STATIC_FORCEINLINE void     PIN_TDI_OUT (uint32_t bit) {

  if(bit & 0x01) {
     gpio_write_pin(PIN_GPIO, GPIO_GET_PORT_INDEX(PIN_TDI), GPIO_GET_PIN_INDEX(PIN_TDI), true);
  }
  else {
     gpio_write_pin(PIN_GPIO, GPIO_GET_PORT_INDEX(PIN_TDI), GPIO_GET_PIN_INDEX(PIN_TDI), false);
  }
  __asm volatile("fence io, io");
}


// TDO Pin I/O ---------------------------------------------

/** TDO I/O pin: Get Input.
\return Current status of the TDO DAP hardware I/O pin.
*/
__STATIC_FORCEINLINE uint32_t PIN_TDO_IN  (void) {
    uint32_t sta =  gpio_read_pin(PIN_GPIO, GPIO_GET_PORT_INDEX(PIN_TDO), GPIO_GET_PIN_INDEX(PIN_TDO));
    __asm volatile("fence io, io");
    return sta;
}


// nTRST Pin I/O -------------------------------------------

/** nTRST I/O pin: Get Input.
\return Current status of the nTRST DAP hardware I/O pin.
*/
__STATIC_FORCEINLINE uint32_t PIN_nTRST_IN   (void) {
    uint32_t sta =  gpio_read_pin(PIN_GPIO, GPIO_GET_PORT_INDEX(PIN_JTAG_TRST), GPIO_GET_PIN_INDEX(PIN_JTAG_TRST));
    __asm volatile("fence io, io");
    return sta;
}

/** nTRST I/O pin: Set Output.
\param bit JTAG TRST Test Reset pin status:
           - 0: issue a JTAG TRST Test Reset.
           - 1: release JTAG TRST Test Reset.
*/
__STATIC_FORCEINLINE void     PIN_nTRST_OUT  (uint32_t bit) {
    if(bit & 0x01) {
       gpio_write_pin(PIN_GPIO, GPIO_GET_PORT_INDEX(PIN_JTAG_TRST), GPIO_GET_PIN_INDEX(PIN_JTAG_TRST), true);
    }
    else {
       gpio_write_pin(PIN_GPIO, GPIO_GET_PORT_INDEX(PIN_JTAG_TRST), GPIO_GET_PIN_INDEX(PIN_JTAG_TRST), false);
    }
    __asm volatile("fence io, io");
}

// nRESET Pin I/O------------------------------------------

/** nRESET I/O pin: Get Input.
\return Current status of the nRESET DAP hardware I/O pin.
*/
__STATIC_FORCEINLINE uint32_t PIN_nRESET_IN  (void) {
    uint32_t sta =  gpio_read_pin(PIN_GPIO, GPIO_GET_PORT_INDEX(PIN_SRST), GPIO_GET_PIN_INDEX(PIN_SRST));
    __asm volatile("fence io, io");
    return sta;
}

/** nRESET I/O pin: Set Output.
\param bit target device hardware reset pin status:
           - 0: issue a device hardware reset.
           - 1: release device hardware reset.
*/
__STATIC_FORCEINLINE void     PIN_nRESET_OUT (uint32_t bit) {
    if(bit & 0x01) {
       gpio_write_pin(PIN_GPIO, GPIO_GET_PORT_INDEX(PIN_SRST), GPIO_GET_PIN_INDEX(PIN_SRST), true);
    }
    else {
       gpio_write_pin(PIN_GPIO, GPIO_GET_PORT_INDEX(PIN_SRST), GPIO_GET_PIN_INDEX(PIN_SRST), false);
       extern uint8_t software_reset(void);
       uint8_t ret = software_reset();
        (void)ret;
    }
    __asm volatile("fence io, io");
}

///@}


//**************************************************************************************************
/**
\defgroup DAP_Config_LEDs_gr CMSIS-DAP Hardware Status LEDs
\ingroup DAP_ConfigIO_gr
@{

CMSIS-DAP Hardware may provide LEDs that indicate the status of the CMSIS-DAP Debug Unit.

It is recommended to provide the following LEDs for status indication:
 - Connect LED: is active when the DAP hardware is connected to a debugger.
 - Running LED: is active when the debugger has put the target device into running state.
*/

/** Debug Unit: Set status of Connected LED.
\param bit status of the Connect LED.
           - 1: Connect LED ON: debugger is connected to CMSIS-DAP Debug Unit.
           - 0: Connect LED OFF: debugger is not connected to CMSIS-DAP Debug Unit.
*/
__STATIC_INLINE void LED_CONNECTED_OUT (uint32_t bit) {
#ifdef PIN_LED_CONNECTED
    if(bit & 0x01) {
       gpio_write_pin(PIN_GPIO, GPIO_GET_PORT_INDEX(PIN_LED_CONNECTED), GPIO_GET_PIN_INDEX(PIN_LED_RUNNING), true);
    }
    else {
       gpio_write_pin(PIN_GPIO, GPIO_GET_PORT_INDEX(PIN_LED_CONNECTED), GPIO_GET_PIN_INDEX(PIN_LED_RUNNING), false);
    }
#endif

#if CONFIG_WS2812
    extern volatile bool WS2812_Update_Flag;
    if (bit & 0x01) {
        WS2812_MixPixel(0, 128, 0, 0);
    } else {
        WS2812_ReverseMixPixel(0, 128, 0, 0);
    }
    WS2812_Update_Flag = true;
#endif
    __asm volatile("fence io, io");
}

/** Debug Unit: Set status Target Running LED.
\param bit status of the Target Running LED.
           - 1: Target Running LED ON: program execution in target started.
           - 0: Target Running LED OFF: program execution in target stopped.
*/
__STATIC_INLINE void LED_RUNNING_OUT (uint32_t bit) {
#ifdef PIN_LED_RUNNING
    if(bit & 0x01) {
       gpio_write_pin(PIN_GPIO, GPIO_GET_PORT_INDEX(PIN_LED_RUNNING), GPIO_GET_PIN_INDEX(PIN_LED_RUNNING), true);
    }
    else {
       gpio_write_pin(PIN_GPIO, GPIO_GET_PORT_INDEX(PIN_LED_RUNNING), GPIO_GET_PIN_INDEX(PIN_LED_RUNNING), false);
    }
#endif

#ifdef CONFIG_WS2812
    extern volatile bool WS2812_Update_Flag;
    if (bit & 0x01) {
        WS2812_MixPixel(0, 0, 0, 128);
    } else {
        WS2812_ReverseMixPixel(0, 0, 0, 128);
    }
    WS2812_Update_Flag = true;
#endif
    __asm volatile("fence io, io");
}

///@}


//**************************************************************************************************
/**
\defgroup DAP_Config_Timestamp_gr CMSIS-DAP Timestamp
\ingroup DAP_ConfigIO_gr
@{
Access function for Test Domain Timer.

The value of the Test Domain Timer in the Debug Unit is returned by the function \ref TIMESTAMP_GET. By
default, the DWT timer is used.  The frequency of this timer is configured with \ref TIMESTAMP_CLOCK.

*/

/** Get timestamp of Test Domain Timer.
\return Current timestamp value.
*/
__STATIC_INLINE uint32_t TIMESTAMP_GET (void) {
    uint32_t current_us = (hpm_csr_get_core_cycle() * 1000000)/ clock_get_frequency(clock_cpu0);
    return current_us;
}

///@}


//**************************************************************************************************
/**
\defgroup DAP_Config_Initialization_gr CMSIS-DAP Initialization
\ingroup DAP_ConfigIO_gr
@{

CMSIS-DAP Hardware I/O and LED Pins are initialized with the function \ref DAP_SETUP.
*/

/** Setup of the Debug Unit I/O pins and LEDs (called when Debug Unit is initialized).
This function performs the initialization of the CMSIS-DAP Hardware I/O Pins and the
Status LEDs. In detail the operation of Hardware I/O and LED pins are enabled and set:
 - I/O clock system enabled.
 - all I/O pins: input buffer enabled, output pins are set to HighZ mode.
 - for nTRST, nRESET a weak pull-up (if available) is enabled.
 - LED output pins are enabled and LEDs are turned off.
*/
__STATIC_INLINE void DAP_SETUP (void) {
  ;
}

/** Reset Target Device with custom specific I/O pin or command sequence.
This function allows the optional implementation of a device specific reset sequence.
It is called when the command \ref DAP_ResetTarget and is for example required
when a device needs a time-critical unlock sequence that enables the debug port.
\return 0 = no device specific reset sequence is implemented.\n
        1 = a device specific reset sequence is implemented.
*/
__STATIC_INLINE uint8_t RESET_TARGET (void) {
  return (0U);             // change to '1' when a device reset sequence is implemented
}

///@}


#endif /* __DAP_CONFIG_H__ */
