KotoriProject/CherryDAP/projects/HSLink-Pro/src/USB2UART/usb2uart.h

#ifndef HSLINK_PRO_USB2UART_H
#define HSLINK_PRO_USB2UART_H

#define PIN_UART_TX IOC_PAD_PA00
#define PIN_UART_RX IOC_PAD_PA01
#define PIN_UART_RTS IOC_PAD_PA07
#define PIN_UART_DTR IOC_PAD_PA06

void uartx_preinit(void);

void usb2uart_handler(void);

#endif //HSLINK_PRO_USB2UART_H
