KotoriProject/CherryDAP/(commit log)

2024-06-25 添加PCB_project
    [core.kicad_sch, hpm_dap.kicad_pcb, hpm_dap.kicad_sch, power.kicad_sch]
2024-06-27 PCB layout 完毕
    [core.kicad_sch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]
2024-06-30 添加钢网文件
    [hpm_dap-B_Cu.gbr, hpm_dap-B_Mask.gbr, hpm_dap-B_Paste.gbr, hpm_dap-B_Silkscreen.gbr, hpm_dap-Edge_Cuts.gbr, hpm_dap-F_Cu.gbr, hpm_dap-F_Mask.gbr, hpm_dap-F_Paste.gbr]
2024-07-01 原理图错误，HPM5301的VDD_SOC引脚应当连接到内部DCDC_LP(输出)，不应当连接到3.3V供电
    [core.kicad_sch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]
2024-07-01 token push test
    [hpm_dap-PTH.drl]
2024-07-01 小乌龟测试
2024-07-01 push test
    [CPL-hpm_dap.csv]
2024-10-11 屏蔽log输出
2024-10-11 更改usb串口到uart0
